romansonder/pro4e/documentation/07_PMA_report/30_analyse.tex

\begin{center}
    \begin{tabular}{ | c | m{5.5cm} | c | c | c | m{5.5cm} |}
    \hline
    $+/-$ & Ereignis & TA & PM & PA & Auswirkungen \\ \hline
    
$+$ & Die Analysephase des Projektes wurde schnell abgeschlossen. & & X & & Die Teile konnten sehr früh bestellt werden, so dass wir in der Projektwoche den Prototypen realisieren konnten. \\ \hline
    
$+$ & Der Aufbau des Dojos wurde von Anfang an gut geplant. & & & X & Beim Einbau der Teile in den Dojo hatten wir keine unvorhergesehene Platzprobleme. \\ \hline
    
$+$ & Die Teammitglieder erledigten ihre Arbeiten seriös und rechtzeitig. & X &  & & Das Projekt kam schnell voran und es gab kaum Verzögerungen im Zeitplan. \\ \hline
    
$-$ & Die Bluetoothverbindung klappte nicht wie gewünscht. & &  & X & Es musste viel Zeit in dieses Problem investiert werden.  \\ \hline
    
$-$ & Die Softwarearbeit wurde unterschätzt. Und die Arbeit anfangs Projekt ungenügend aufgeteilt. & & X & & Dominic musste in anderen Bereichen entlastet werden, da er sonst überlastet gewesen wäre.  \\ \hline
    
$-$ & Es funktionieren nicht alle SD-Kartentypen. & & & X & Wir mussten einen speziellen Typen bestellen, um unsere 3 Prototypen mit SD-Karten auszustatten.  \\ \hline

    \end{tabular}
\end{center}

\begin{tabular}{ | c | l | }
    \hline
    TA & Teamarbeit \\ \hline
    PM & Projektmanagement \\ \hline
    PA & Projektarbeit \\ \hline
   
    \end{tabular}
