romansonder/pro4e/documentation/04_technical_report_Disposition/30_grundlagen.tex

\subsection{Funktionen des Dojos}
Zu Beginn soll eine Übersicht über die Funktionen (aus Sicht des Benutzers) gemacht werden. Es wird gezeigt, wie der Dojo bedient wird und wie der Ablauf von der Konfiguration am PC-Terminal bis zum Check-out ist.

\subsection{Aufbau des Dojos}
Hier wird auf den mechanischen Aufbau des Dojos eingegangen. Die Dimensionen des Gehäuses sowie die Integration der Hardware werden beschrieben.
