romansonder/pro4e/documentation/04_technical_report_Disposition/10_abstract.tex

In diesem Abschnitt wird ein Abstract in Englisch verfasst.
