romansonder/pro4e/documentation/08_factsheet/01_plaincontent.tex

\title{
	Dojo - Mehr als nur ein Museumsführer
}

\team{
    Dominik Hiltbrunner,
    Tobias Klenke,
    Lattmann Emerson,
    Pius Ochs,
    Roman Sonder,
    Alexander Stutz
}

\client{
	Jana Kalbermatter und Hans Gysin
}

\coaches{
    Matthias Meier und Pascal Schleuniger
}

\fssummary{
    Wenn es nach Jana Kalbermatter, einer Absolventin der HGK, geht, sollten 		Museen schon längst modernisiert werden. Ihr letzter Museumsbesuch hat 			gezeigt, dass beim ziellosen umherschweifen Kunstwerke oftmals nicht 			wahrgenommen werden und am Ende nur das Erlebnis ''Besuch'' und nicht 			die Kunstwerke selbst in Erinnernung bleiben. Mit dem Dojo, einem stabförmigen 		Museumsführer soll sich dies nun ändern.
}

\fsgraphics{
    \begin{minipage}{\textwidth}
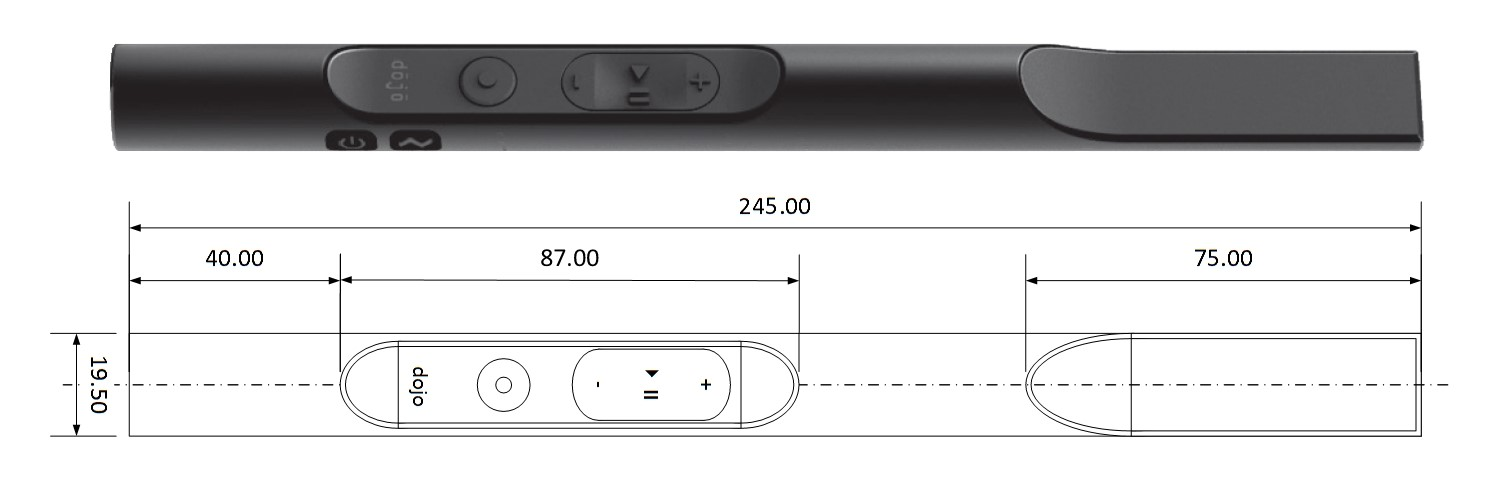
[picture p27: documentation/08_factsheet/graphics/Abbildung.jpg]
    	
        \graphicscaption{	Abbildung 1: Von Auftraggeberin designtes Gehäuse 							mit Dimensionsangaben}
    \end{minipage}
    \graphicssource{Abbildung von Auftraggeberin}
}

\fscontent{
    \section{Die Aufgabe}
    Auf dem Konzept von Jana Kalbermatter beruhend, soll die Elektronik für 		den von Ihr designten Dojo entwickelt werden. Dieser ist nicht nur in der 	Lage, Kunstwerke im Umfeld zu erkennen und entsprechende 						Audioinformationen bereitzustellen, sondern auch gleich als E-Ticket zu			fungieren. Der Dojo soll das Zutrittsrecht zu verschiedenen Räumen 				gewähren können, als auch eine Möglichkeit besitzen, Kunstwerke zu 				''liken''. Beim auschecken kann sodann eine Broschüre als Erinnerung 			mit den ''gelikten'' Kunstwerken bezogen werden. Damit im Museum auch 			weiterhin Ruhe herrscht, soll die Audioübertragung mittels 						Knochenschallgeber funktionieren.

    \newcol
    
    \section{Die Lösung}
    Mit der entwickelten Elektronik wurde ein erstes Funktionsmodell 				geschaffen, das in der Lage ist, die an Kunstwerken montierten Beacons 			zu erkennen und entsprechende Audioinformationen via Knochenschallgeber 		zur Verfügung zu stellen. Aufgrund der Signalstärken der 						einzelnen Beacons wird entschieden, vor welchem Kunstwerk sich der 				Museumsbesucher befindet und durch Vibration des Dojo eine verfügbare 			Audioinformation angekündigt. Ebenso funktioniert die Zutrittsregelung 			durch bei Drehkreuzen montierte Beacons, welche bei genügender 					Zutrittsberechtigung Zutritt gewähren.

    \section{Die Bedienung}
    Mittels einer mit Java entwickelten Software kann der Dojo mit neuen 			Audioinformationen versorgt, sowie mit vom Besucher gewünschter 				Zutrittsberechtigung und Sprache geladen werden. Anschliessend erhält der 	Besucher den Dojo, ein Museumsführer und E-Ticket zugleich. Befindet sich 	der Besucher in Reichweite eines Kunstwerkes, meldet sich der Dojo durch 		Vibration, dass Audioinformationen bereit stehen. Mittels 						''Like-Taste'' kann nun ein Kunstwerk ''geliked'' werden. Beim Abschluss 		des Besuches wird der Dojo zurückgeben, mittels Java Software ausgewertet 	und der Besucher erhält seine persönliche Erinnerungsbroschüre.
}

\infobox{Technische Daten}{
	\begin{tabbing}
		\hspace{40mm}		\= \hspace{15mm} \=\kill
		Gerätebezeichnung:	\> Dojo Museumsführer \\
		Modell:				\> Team 3 \\
		Speicherkapazität:	\> 2 GB \\
		Schnittstelle:		\> USB 2.0 (High Speed) \\
		Abmessungen:		\> ca. 245 mm x 19.5 mm (L x H) \\
		Akku:				\> Wiederaufladbarer Li-Ion Akku; 3.9 V, 600 mAh \\
		Eingang:			\> 5 V, 500 mAh (via USB-Schnittstelle) \\
		Laufzeit*:			\> Bis zu 3.5 Stunden Abspielzeit \\
\end{tabbing}

\begin{description}
\item *Akkulaufzeit kann je nach Abhängigkeit des Bedienverhaltens variieren.
\end{description}
}
