romansonder/pro4e/documentation/06_presentation/00_fhnwpresentation.tex

\documentclass[10pt,ngerman]{beamer}

%%%%%%%%%%%%%%%%%%%%%%%%%%%%%%%%%%%%%%%%%%%%%%%%%%%%%%%%%%%%%%%%%%%%%%%%%%%%%%%%
% basic font and language packages
%%%%%%%%%%%%%%%%%%%%%%%%%%%%%%%%%%%%%%%%%%%%%%%%%%%%%%%%%%%%%%%%%%%%%%%%%%%%%%%%
%\usepackage[left=20mm,right=20mm,top=20mm,bottom=20mm]{geometry}
\usepackage[T1]{fontenc} % font encoding
\usepackage{lmodern} % font latin modern
\usepackage[utf8]{inputenc} % input encoding
\usepackage[ngerman]{babel} % english and german word spelling
\usepackage[babel, german=swiss]{csquotes} % german cites
%\usepackage[babel, english=british]{csquotes} % english cites

%%%%%%%%%%%%%%%%%%%%%%%%%%%%%%%%%%%%%%%%%%%%%%%%%%%%%%%%%%%%%%%%%%%%%%%%%%%%%%%%
% style packages
%%%%%%%%%%%%%%%%%%%%%%%%%%%%%%%%%%%%%%%%%%%%%%%%%%%%%%%%%%%%%%%%%%%%%%%%%%%%%%%%
% \usepackage{hyperref} % use hyperlinks in table of contents
% \hypersetup{colorlinks=true,urlcolor=blue,linkcolor=black} % define hyperlink colors
\usepackage{verbatim} % don't interpret latex symbols (source code)
\usepackage{enumerate} % numbered items
\usepackage{graphicx} % use figures
\usepackage{subfigure} % more than one figure in the same place
\usepackage{booktabs} % create tables
\usepackage{multirow} % create tables
\usepackage{cite} % citations
\usepackage{pdflscape} % allow landscape sites in pdf documents
\usepackage{pdfpages} % include pdf files

%%%%%%%%%%%%%%%%%%%%%%%%%%%%%%%%%%%%%%%%%%%%%%%%%%%%%%%%%%%%%%%%%%%%%%%%%%%%%%%%
% mathematical packages
%%%%%%%%%%%%%%%%%%%%%%%%%%%%%%%%%%%%%%%%%%%%%%%%%%%%%%%%%%%%%%%%%%%%%%%%%%%%%%%%
\usepackage{amsmath} % formula
\usepackage{amsfonts} % formula
\usepackage{amssymb} % formula
\usepackage{amsthm} % formula
\usepackage{listings} % source code formatting

%%%%%%%%%%%%%%%%%%%%%%%%%%%%%%%%%%%%%%%%%%%%%%%%%%%%%%%%%%%%%%%%%%%%%%%%%%%%%%%%
% optional parameters
%%%%%%%%%%%%%%%%%%%%%%%%%%%%%%%%%%%%%%%%%%%%%%%%%%%%%%%%%%%%%%%%%%%%%%%%%%%%%%%%
\bibliographystyle{IEEEtran}
\graphicspath{{./graphics/}{./appendix/}}

% source code parameters
\lstset{numbers=left, numberstyle=\tiny, numbersep=6pt}
\lstset{captionpos=b, tabsize=4, basicstyle=\small, xleftmargin=0mm, xrightmargin=0mm}

%%%%%%%%%%%%%%%%%%%%%%%%%%%%%%%%%%%%%%%%%%%%%%%%%%%%%%%%%%%%%%%%%%%%%%%%%%%%%%%%
% debugging parameters
%%%%%%%%%%%%%%%%%%%%%%%%%%%%%%%%%%%%%%%%%%%%%%%%%%%%%%%%%%%%%%%%%%%%%%%%%%%%%%%%
%\usepackage{todonotes}
%\overfullrule=1em

%%%%%%%%%%%%%%%%%%%%%%%%%%%%%%%%%%%%%%%%%%%%%%%%%%%%%%%%%%%%%%%%%%%%%%%%%%%%%%%%
% beamer theme
%%%%%%%%%%%%%%%%%%%%%%%%%%%%%%%%%%%%%%%%%%%%%%%%%%%%%%%%%%%%%%%%%%%%%%%%%%%%%%%%
\usetheme[compress]{Berlin}
\setbeamertemplate{bibliography item}{\insertbiblabel}

\definecolor{custum_blue}{RGB}{0,0,230}
\setbeamercolor{structure}{fg=custum_blue}

%%%%%%%%%%%%%%%%%%%%%%%%%%%%%%%%%%%%%%%%%%%%%%%%%%%%%%%%%%%%%%%%%%%%%%%%%%%%%%%%
% title
%%%%%%%%%%%%%%%%%%%%%%%%%%%%%%%%%%%%%%%%%%%%%%%%%%%%%%%%%%%%%%%%%%%%%%%%%%%%%%%%
\title{Midterm Presentation}
\subtitle{Dojo -- Mehr als nur ein Museumsbegleiter}
\date{xx.xx.2018}

\begin{document}
%%%%%%%%%%%%%%%%%%%%%%%%%%%%%%%%%%%%%%%%%%%%%%%%%%%%%%%%%%%%%%%%%%%%%%%%%%%%%%%%
\begin{frame}
\maketitle
\end{frame}

%-------------------------------------------------------------------------------
\begin{frame}
\tableofcontents
\end{frame}

%%%%%%%%%%%%%%%%%%%%%%%%%%%%%%%%%%%%%%%%%%%%%%%%%%%%%%%%%%%%%%%%%%%%%%%%%%%%%%%%
\section{introduction}
\begin{frame}

\end{frame}

%-------------------------------------------------------------------------------
\begin{frame}

\end{frame}

%-------------------------------------------------------------------------------
\begin{frame}

\end{frame}

%%%%%%%%%%%%%%%%%%%%%%%%%%%%%%%%%%%%%%%%%%%%%%%%%%%%%%%%%%%%%%%%%%%%%%%%%%%%%%%%
\section{Concept}
\begin{frame}

\end{frame}

%-------------------------------------------------------------------------------
\begin{frame}

\end{frame}

%-------------------------------------------------------------------------------
\begin{frame}

\end{frame}

%%%%%%%%%%%%%%%%%%%%%%%%%%%%%%%%%%%%%%%%%%%%%%%%%%%%%%%%%%%%%%%%%%%%%%%%%%%%%%%%
\section{Harware}
\begin{frame}

\end{frame}

%-------------------------------------------------------------------------------
\begin{frame}

\end{frame}

%%%%%%%%%%%%%%%%%%%%%%%%%%%%%%%%%%%%%%%%%%%%%%%%%%%%%%%%%%%%%%%%%%%%%%%%%%%%%%%%
\section{Software}
\begin{frame}

\end{frame}

%-------------------------------------------------------------------------------
\begin{frame}

\end{frame}

%%%%%%%%%%%%%%%%%%%%%%%%%%%%%%%%%%%%%%%%%%%%%%%%%%%%%%%%%%%%%%%%%%%%%%%%%%%%%%%%
\section{Q\&A}
\begin{frame}

\end{frame}

\end{document}
