romansonder/pro4e/documentation/05_technical_report_usermanual/00_fhnwreport.tex

\documentclass[10pt,a5paper,landscape]{article}

%%%%%%%%%%%%%%%%%%%%%%%%%%%%%%%%%%%%%%%%%%%%%%%%%%%%%%%%%%%%%%%%%%%%%%%%%%%%%%%%
% basic font and language packages
%%%%%%%%%%%%%%%%%%%%%%%%%%%%%%%%%%%%%%%%%%%%%%%%%%%%%%%%%%%%%%%%%%%%%%%%%%%%%%%%
\usepackage[left=20mm,right=20mm,top=20mm,bottom=20mm]{geometry}
\usepackage[T1]{fontenc} % font encoding
\usepackage{lmodern} % font latin modern
\usepackage[utf8]{inputenc} % input encoding
\usepackage[ngerman]{babel} % english and german word spelling
\usepackage[babel, german=swiss]{csquotes} % german cites
%\usepackage[babel, english=british]{csquotes} % english cites

%%%%%%%%%%%%%%%%%%%%%%%%%%%%%%%%%%%%%%%%%%%%%%%%%%%%%%%%%%%%%%%%%%%%%%%%%%%%%%%%
% style packages
%%%%%%%%%%%%%%%%%%%%%%%%%%%%%%%%%%%%%%%%%%%%%%%%%%%%%%%%%%%%%%%%%%%%%%%%%%%%%%%%
\usepackage{hyperref} % use hyperlinks in table of contents
\hypersetup{colorlinks=true,urlcolor=blue,linkcolor=black} % define hyperlink colors
\usepackage{verbatim} % don't interpret latex symbols (source code)
\usepackage{enumerate} % numbered items
\usepackage{graphicx} % use figures
\usepackage{subfigure} % more than one figure in the same place
\usepackage{booktabs} % create tables
\usepackage{multirow} % create tables
\usepackage{cite} % citations
\usepackage{pdflscape} % allow landscape sites in pdf documents
\usepackage{pdfpages} % include pdf files

%%%%%%%%%%%%%%%%%%%%%%%%%%%%%%%%%%%%%%%%%%%%%%%%%%%%%%%%%%%%%%%%%%%%%%%%%%%%%%%%
% mathematical packages
%%%%%%%%%%%%%%%%%%%%%%%%%%%%%%%%%%%%%%%%%%%%%%%%%%%%%%%%%%%%%%%%%%%%%%%%%%%%%%%%
\usepackage{amsmath} % formula
\usepackage{amsfonts} % formula
\usepackage{amssymb} % formula
\usepackage{amsthm} % formula
\usepackage{listings} % source code formatting

%%%%%%%%%%%%%%%%%%%%%%%%%%%%%%%%%%%%%%%%%%%%%%%%%%%%%%%%%%%%%%%%%%%%%%%%%%%%%%%%
% optional parameters
%%%%%%%%%%%%%%%%%%%%%%%%%%%%%%%%%%%%%%%%%%%%%%%%%%%%%%%%%%%%%%%%%%%%%%%%%%%%%%%%
\bibliographystyle{IEEEtran}
\graphicspath{{./graphics/}{./appendix/}}

% source code parameters
\lstset{numbers=left, numberstyle=\tiny, numbersep=6pt}
\lstset{captionpos=b, tabsize=4, basicstyle=\small, xleftmargin=0mm, xrightmargin=0mm}

%%%%%%%%%%%%%%%%%%%%%%%%%%%%%%%%%%%%%%%%%%%%%%%%%%%%%%%%%%%%%%%%%%%%%%%%%%%%%%%%
% debugging parameters
%%%%%%%%%%%%%%%%%%%%%%%%%%%%%%%%%%%%%%%%%%%%%%%%%%%%%%%%%%%%%%%%%%%%%%%%%%%%%%%%
%\usepackage{todonotes}
%\overfullrule=1em

%%%%%%%%%%%%%%%%%%%%%%%%%%%%%%%%%%%%%%%%%%%%%%%%%%%%%%%%%%%%%%%%%%%%%%%%%%%%%%%%
% document settings
%%%%%%%%%%%%%%%%%%%%%%%%%%%%%%%%%%%%%%%%%%%%%%%%%%%%%%%%%%%%%%%%%%%%%%%%%%%%%%%%
\title{
	\textsc{\LARGE{Bedienungsanleitung}}\\[5mm]
	\textsc{\LARGE{Dojo - Mehr als nur ein Museumsführer}}
}

\author{}

\date{\today}

%%%%%%%%%%%%%%%%%%%%%%%%%%%%%%%%%%%%%%%%%%%%%%%%%%%%%%%%%%%%%%%%%%%%%%%%%%%%%%%
% pictures
%\begin{figure}[htb]
%\includegraphics[width=100mm]{image1.png}
%\figcaption{image1} % picture caption
%\label{fig:image1}
%\end{figure}
%
%(Abb. \ref{fig:image1})
%%%%%%%%%%%%%%%%%%%%%%%%%%%%%%%%%%%%%%%%%%%%%%%%%%%%%%%%%%%%%%%%%%%%%%%%%%%%%%%

%%%%%%%%%%%%%%%%%%%%%%%%%%%%%%%%%%%%%%%%%%%%%%%%%%%%%%%%%%%%%%%%%%%%%%%%%%%%%%%
% equation
%\begin{equation}
%X_{1,2} = \frac{-b \pm \sqrt{b^{2}-4ac}}{2a}
%\label{eq:equation1}
%\end{equation}
%%%%%%%%%%%%%%%%%%%%%%%%%%%%%%%%%%%%%%%%%%%%%%%%%%%%%%%%%%%%%%%%%%%%%%%%%%%%%%%

%%%%%%%%%%%%%%%%%%%%%%%%%%%%%%%%%%%%%%%%%%%%%%%%%%%%%%%%%%%%%%%%%%%%%%%%%%%%%%%
% table
%\begin{table}[tb]
%\centering
%\begin{tabular}
%
%\end{tabular}
%\caption{Table 1}
%\label{tab:table1}
%\end{table}
%%%%%%%%%%%%%%%%%%%%%%%%%%%%%%%%%%%%%%%%%%%%%%%%%%%%%%%%%%%%%%%%%%%%%%%%%%%%%%%

%%%%%%%%%%%%%%%%%%%%%%%%%%%%%%%%%%%%%%%%%%%%%%%%%%%%%%%%%%%%%%%%%%%%%%%%%%%%%%%
% citation
%\cite{BUCH1}
%%%%%%%%%%%%%%%%%%%%%%%%%%%%%%%%%%%%%%%%%%%%%%%%%%%%%%%%%%%%%%%%%%%%%%%%%%%%%%%

%%%%%%%%%%%%%%%%%%%%%%%%%%%%%%%%%%%%%%%%%%%%%%%%%%%%%%%%%%%%%%%%%%%%%%%%%%%%%%%
% source code
%\begin{lstlisting}[frame=tb,caption={Application.java}, label=lst:code, language=java]
%your source code
%\end{lstlisting}
% or
%\lstinputlisting[frame=tb,caption={Caption 1}, label=lst:code1, language=c]{path/file.src}
%
%%%%%%%%%%%%%%%%%%%%%%%%%%%%%%%%%%%%%%%%%%%%%%%%%%%%%%%%%%%%%%%%%%%%%%%%%%%%%%%

\begin{document}

%%%%%%%%%%%%%%%%%%%%%%%%%%%%%%%%%%%%%%%%%%%%%%%%%%%%%%%%%%%%%%%%%%%%%%%%%%%%%%%%
% title page
%%%%%%%%%%%%%%%%%%%%%%%%%%%%%%%%%%%%%%%%%%%%%%%%%%%%%%%%%%%%%%%%%%%%%%%%%%%%%%%%
\pagenumbering{gobble}
\maketitle

%\definecolor{gray}{rgb}{0.5,0.5,0.5}
%\color{gray}
\noindent % einzug
\rule{\linewidth}{0.5mm}

\begin{center}
\parbox{50mm}{
\textsc{
\begin{tabbing}
\hspace{50mm}	\= \hspace{15mm} \=\kill
Auftraggeber	\> Jana Kalbermatter und Hans Gysin \\[2.5mm]
Fachcoaches		\> Matthias Meier und Pascal Schleuniger\\[2.5mm]
Projektleiter	\> Dominik Hiltbrunner\\
Team			\> Alexander Stutz, Emerson Lattmann, \\
				\> Pius Ochs, Tobias Klenke und Roman Sonder\\[2.5mm]
Studiengang		\> Elektro- und Informationstechnik \\[2.5mm]
\end{tabbing}}}
\end{center}

\color{black}

%%%%%%%%%%%%%%%%%%%%%%%%%%%%%%%%%%%%%%%%%%%%%%%%%%%%%%%%%%%%%%%%%%%%%%%%%%%%%%%%
% table of contents
%%%%%%%%%%%%%%%%%%%%%%%%%%%%%%%%%%%%%%%%%%%%%%%%%%%%%%%%%%%%%%%%%%%%%%%%%%%%%%%%
\tableofcontents
\clearpage

%%%%%%%%%%%%%%%%%%%%%%%%%%%%%%%%%%%%%%%%%%%%%%%%%%%%%%%%%%%%%%%%%%%%%%%%%%%%%%%%
% Geräte Übersicht
%%%%%%%%%%%%%%%%%%%%%%%%%%%%%%%%%%%%%%%%%%%%%%%%%%%%%%%%%%%%%%%%%%%%%%%%%%%%%%%%
\pagenumbering{arabic}
\setcounter{page}{1}
\section{Geräte Übersicht}\label{sec:Geräte Übersicht}
\input{10_geraete_uebersicht}
\clearpage

%%%%%%%%%%%%%%%%%%%%%%%%%%%%%%%%%%%%%%%%%%%%%%%%%%%%%%%%%%%%%%%%%%%%%%%%%%%%%%%%
% Über dieses Gerät
%%%%%%%%%%%%%%%%%%%%%%%%%%%%%%%%%%%%%%%%%%%%%%%%%%%%%%%%%%%%%%%%%%%%%%%%%%%%%%%%
\section{Über dieses Gerät}\label{sec:Über dieses Gerät}
\input{20_ueber_dieses_geraet}
\clearpage

%%%%%%%%%%%%%%%%%%%%%%%%%%%%%%%%%%%%%%%%%%%%%%%%%%%%%%%%%%%%%%%%%%%%%%%%%%%%%%%%
% Inbetriebnahme
%%%%%%%%%%%%%%%%%%%%%%%%%%%%%%%%%%%%%%%%%%%%%%%%%%%%%%%%%%%%%%%%%%%%%%%%%%%%%%%%
\section{Inbetriebnahme}\label{sec:Inbetriebnahme}
\input{30_inbetriebnahme}
\clearpage

%%%%%%%%%%%%%%%%%%%%%%%%%%%%%%%%%%%%%%%%%%%%%%%%%%%%%%%%%%%%%%%%%%%%%%%%%%%%%%%%
% Datenaustausch mit dem Computer
%%%%%%%%%%%%%%%%%%%%%%%%%%%%%%%%%%%%%%%%%%%%%%%%%%%%%%%%%%%%%%%%%%%%%%%%%%%%%%%%
\section{Datenaustausch mit dem Computer}\label{sec:Datenaustausch mit dem Computer}
\input{40_datenaustausch_mit_computer }
\clearpage

%%%%%%%%%%%%%%%%%%%%%%%%%%%%%%%%%%%%%%%%%%%%%%%%%%%%%%%%%%%%%%%%%%%%%%%%%%%%%%%%
% Bedienung
%%%%%%%%%%%%%%%%%%%%%%%%%%%%%%%%%%%%%%%%%%%%%%%%%%%%%%%%%%%%%%%%%%%%%%%%%%%%%%%%
\section{Bedienung}\label{sec:Bedienung}
\input{50_bedienung}
\clearpage

%%%%%%%%%%%%%%%%%%%%%%%%%%%%%%%%%%%%%%%%%%%%%%%%%%%%%%%%%%%%%%%%%%%%%%%%%%%%%%%%
% Technische Daten
%%%%%%%%%%%%%%%%%%%%%%%%%%%%%%%%%%%%%%%%%%%%%%%%%%%%%%%%%%%%%%%%%%%%%%%%%%%%%%%%
\section{Technische Daten}\label{sec:Technische Daten}
\input{60_technische_daten}
\clearpage

%%%%%%%%%%%%%%%%%%%%%%%%%%%%%%%%%%%%%%%%%%%%%%%%%%%%%%%%%%%%%%%%%%%%%%%%%%%%%%%%
% Entsorgung
%%%%%%%%%%%%%%%%%%%%%%%%%%%%%%%%%%%%%%%%%%%%%%%%%%%%%%%%%%%%%%%%%%%%%%%%%%%%%%%%
\section{Entsorgung}\label{sec:Entsorgung}
\input{70_entsorgung}
\clearpage

\end{document}
