romansonder/pro4e/documentation/00_research/blockschaltbild.pptx

Steckdose

Messgerät

Messteil

Filter und Verstärker

AD-Wandler

Verbraucher

Smartphone

App

NUS-Library

Energie-versorgung

Speicher

nRF52832

Applikation

RTC

Batterie

zB. SPI

?

NUS-Library
BLE-Driver
BLE-Modul

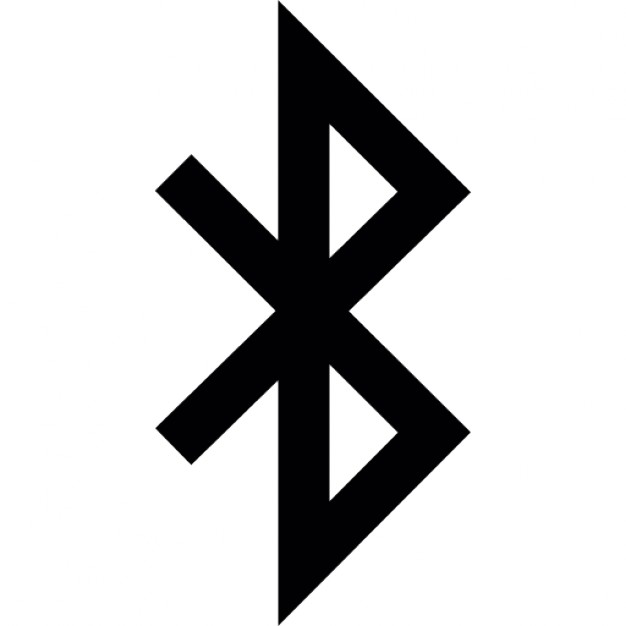
[picture p28: figure]

BLE-Modul
BLE-Treiber

Display

Zu entwickeln in Pro3E

Produkt von Nordic Semiconductor

Produkt von Dritten
