romansonder/pro4e/documentation/07_PMA_report/50_schlusswort.tex

Die Teamarbeit des Projekts kann positiv gewertet werden. Während der gesamten Zeit gab es keine relevanten Unstimmigkeiten. Die im Laufe des Projektes aufgetauchten Probleme, beseitigte das Team jeweils durch viel Engagement und guter Zusammenarbeit. Die negativen Erfahrungen im Projekt beschränken sich auf technische und Projektmanagement spezifische Angelegenheiten. Die Projektarbeit in unserem Team hat ausgezeichnet funktioniert.\\
\\
Besonders hervorzuheben ist in diesem Projekt der schnelle Abschluss der Analysephase. Wir konnten bereits im Pflichtenheft einen relativ detaillierten Lösungsvorschlag für die Hardware präsentieren. Zu kurz gekommen ist in dieser Phase die Software. Die Analyse der Software hätte präziser ausfallen sollen. Dadurch hätten wir uns viele Probleme erspart.\\
\\
Für weitere Projekte kann man die Methoden in der Teamarbeit so beibehalten. Im Bereich des Projektmanagements sollte man darauf achten, dass alle Bereiche genau analysiert werden, auch wenn sie auf den ersten Blick als unproblematisch erachtet werden. Aus unseren technischen Problemen kann man hautsächlich lernen, dass man besser auf gut dokumentierte Bauteile setzen sollte und auf exotische Bauteile verzichtet.
