romansonder/pro4e/documentation/00_research/flussdiagramm.pptx

Reset

Initialisiere aller Nordic Module

n* ≡ LOG_INTERVALL* ≡10 s

k* ≡ DISPLAY_INTERVALL ≡ 3 s

Initialisiere aller Hardwaretreiber

Initialisiere alle anderen Module

n* mal wiederholen

Messung von Strom und Spannung starten

fertig

wiederholen

trifft zu

Berechne zu loggende Werte

BLE Advertising starten

Warten bis Messung fertig

Logge Werte des letzten LOG_INTERVALL*

Daten über BLE empfangen

Reagiere darauf:
- Zeit aktualisieren
- Daten senden
-Messung zurücksetzen

Ende des Threads

Signalverarbeitung durchführen

Alle k* mal trifft zu

trifft nicht zu

Berechne anzuzeigende Werte

Gebe die Werte auf Display aus

Falls mit App verbunden:
Sende Werte an App
