romansonder/pro4e/documentation/03_technical_report/graphics/dojo_layer.pdf

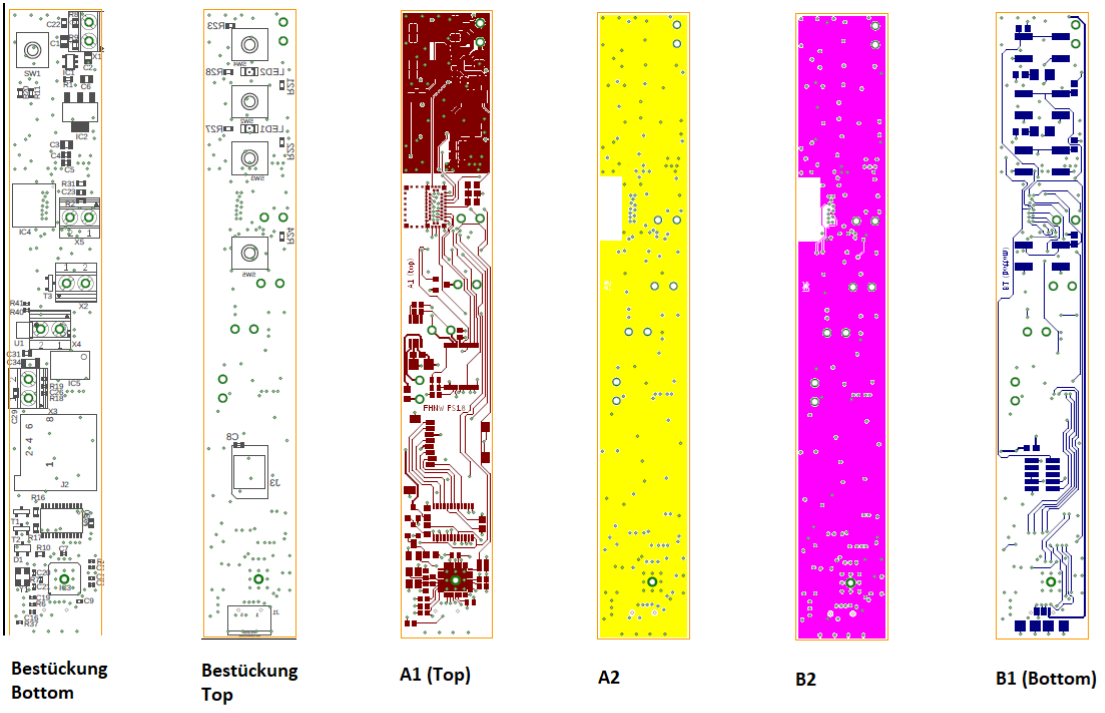
[picture p35: figure]
