romansonder/pro4e/documentation/01_product_specification_organizational/graphics/projektplan_1.pdf

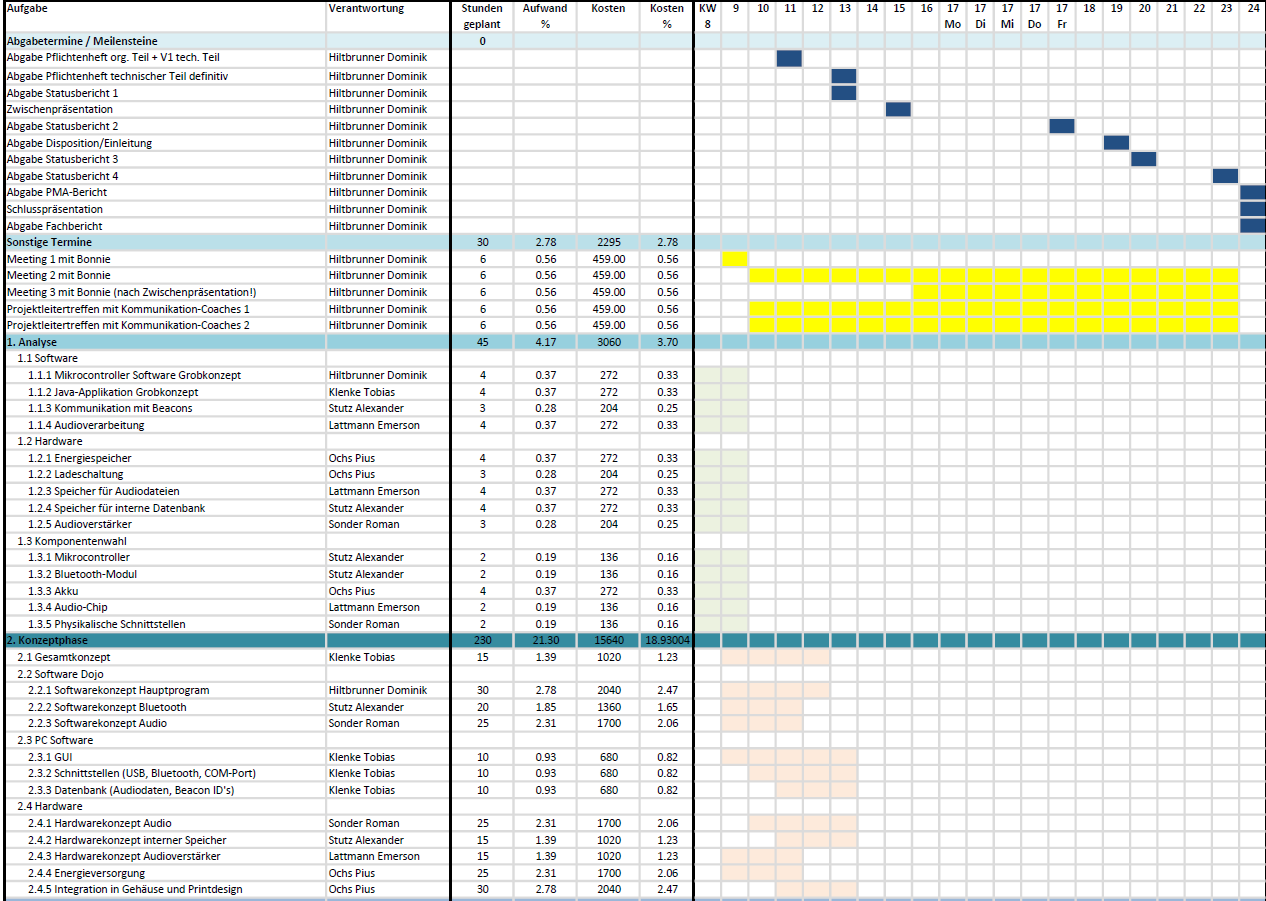
[picture p37: page 1]
