romansonder/pro4e/documentation/01_product_specification_organizational/graphics/projektplan_2.pdf

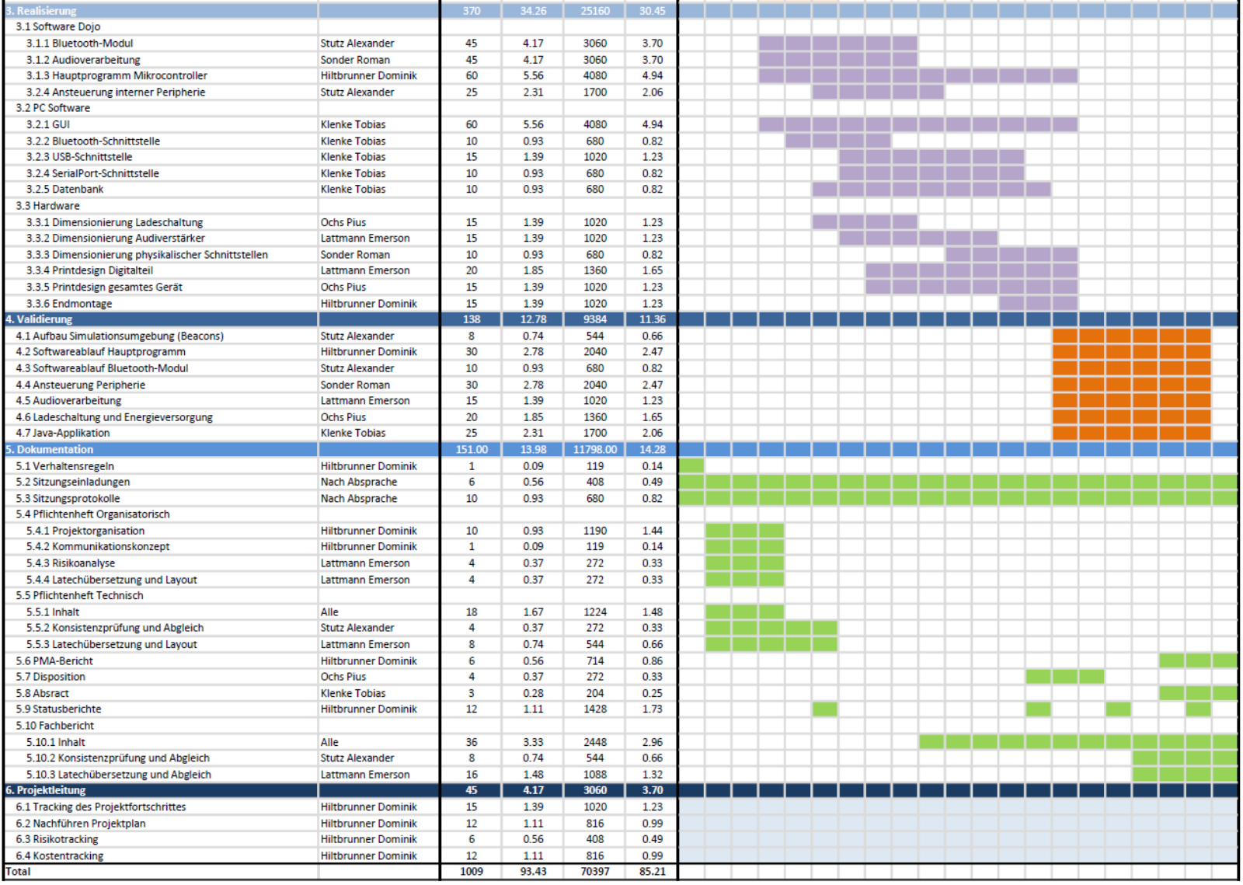
[picture p38: page 1]
