romansonder/pro4e/software/host/Laborbericht_Roman_Tobias/messresultate_01.xlsx

19.6°C |  | f2 | 4.955 | Distro D8
34.00% |  | f1 | 1+-0.005 | Masstab
974hPa |  | s1 | 0.12+-0.005 | Masstab
 |  | s2 | 4.75 | Distro D8
Frequenz | Abstand |  |  | Linse Brennweite | 1m
-227 | 0
-329 | -9.6e-05
-427 | -0.000177
-526 | -0.000248
-624 | -0.000333
-726 | -0.000413
-828 | -0.000496
-926 | -0.000576
-1024 | -0.000659
229 | 0
327 | 9e-05
427 | 0.000163
528 | 0.000236
625 | 0.000333
725 | 0.000407
826 | 0.000474
925 | 0.000557
1027 | 0.000651
