romansonder/pro4e/hardware/pcb/Board_1_Eagle/Bestellung 28_03_2018/Mängelliste.xlsx

1 | Botton-Beschriftung
2 | V_Bat Spannungsmessung
3 | Transistoren sind scheisse
4 | MUX freihängend
