romansonder/pro4e/documentation/01_product_specification_organizational/graphics/projektplan.png

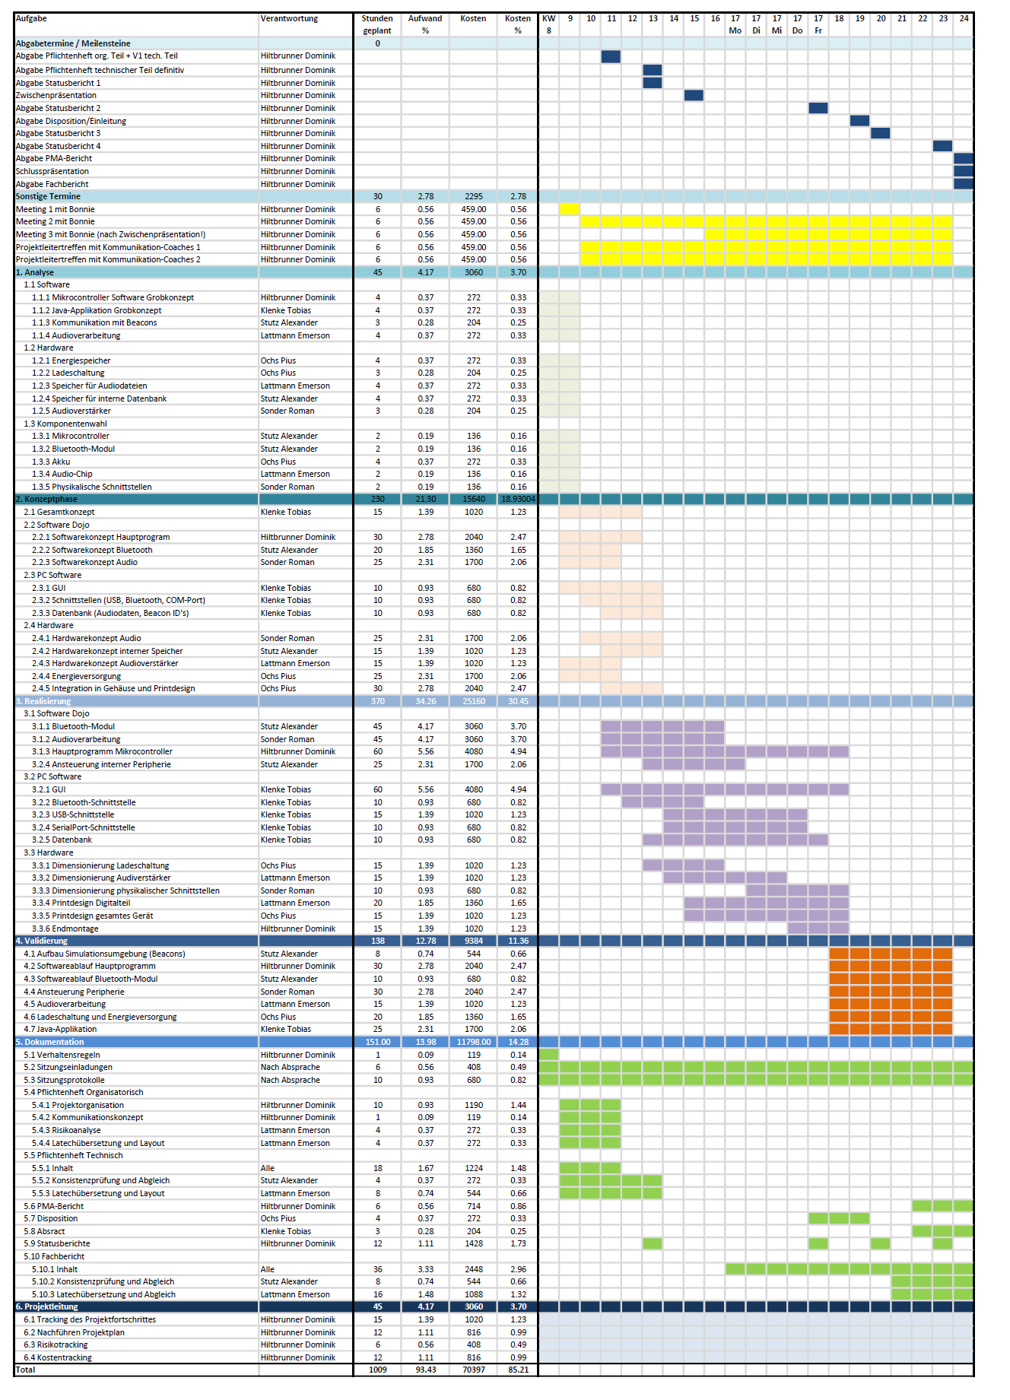
documentation/01_product_specification_organizational/graphics/projektplan.png
