romansonder/pro4e/documentation/03_technical_report/graphics/dojo_layer.png

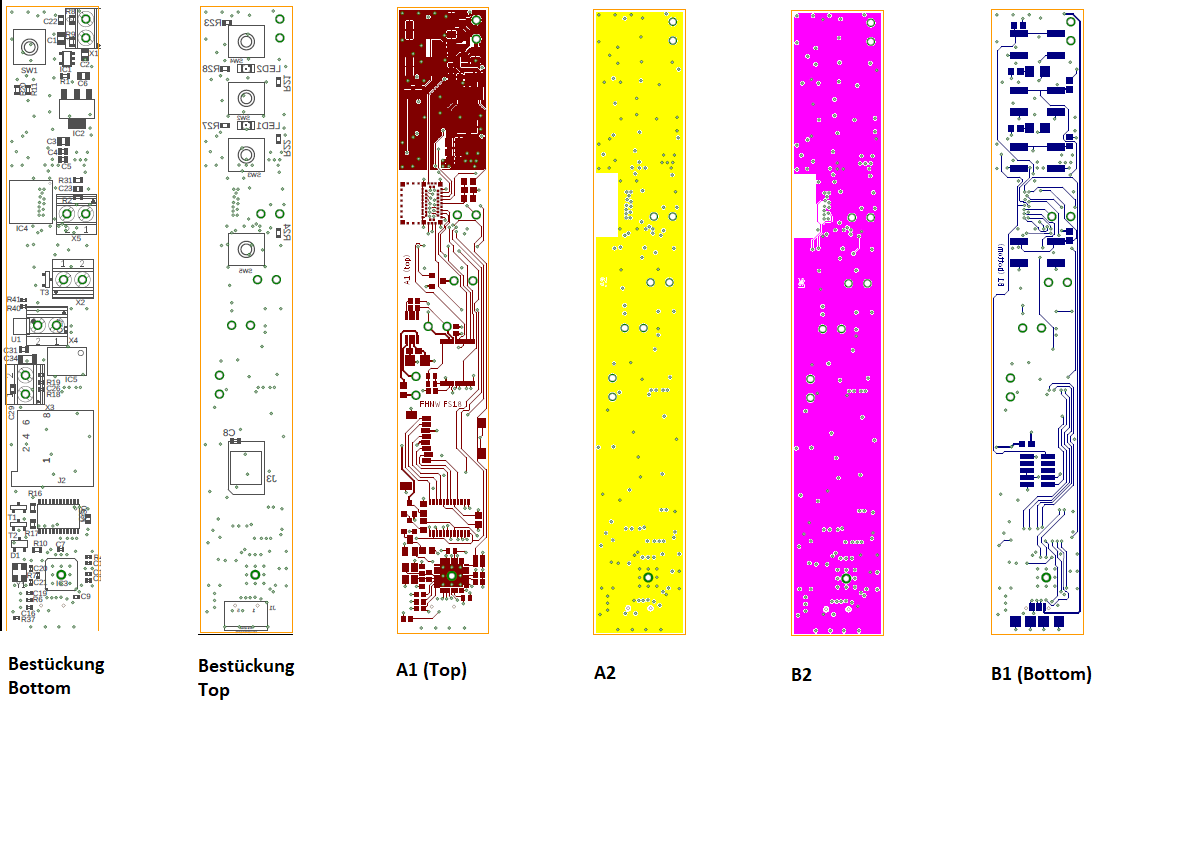
documentation/03_technical_report/graphics/dojo_layer.png
