romansonder/pro4e/documentation/03_technical_report/graphics/EnladekurveSpannung.png

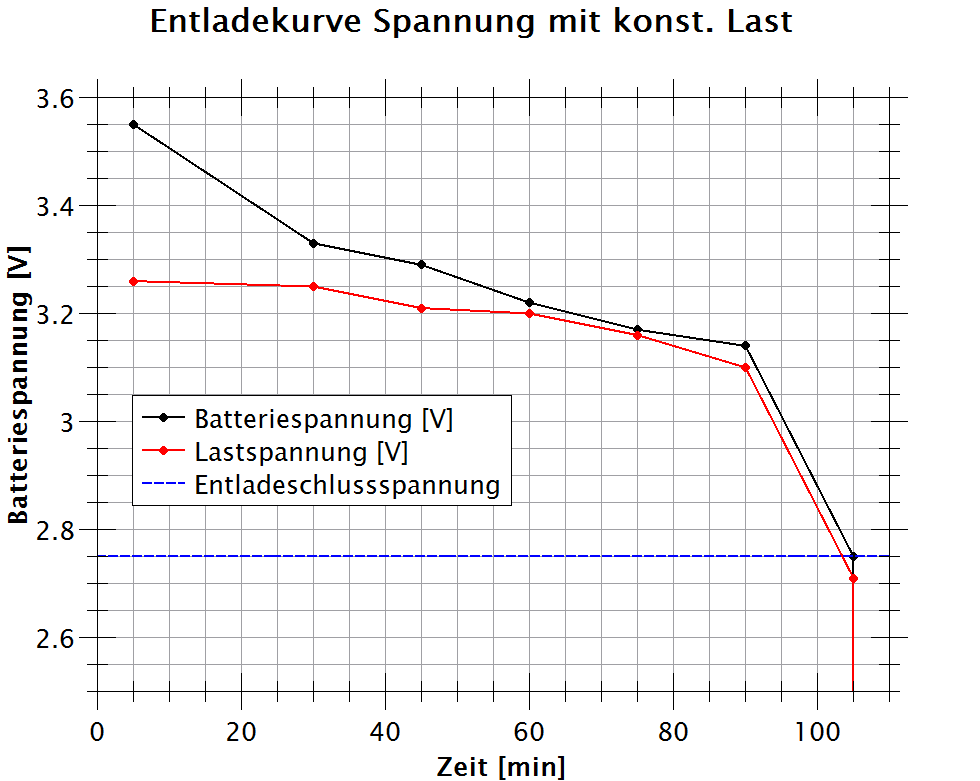
documentation/03_technical_report/graphics/EnladekurveSpannung.png
