romansonder/pro4e/documentation/03_technical_report/graphics/EnladekurveStrom.png

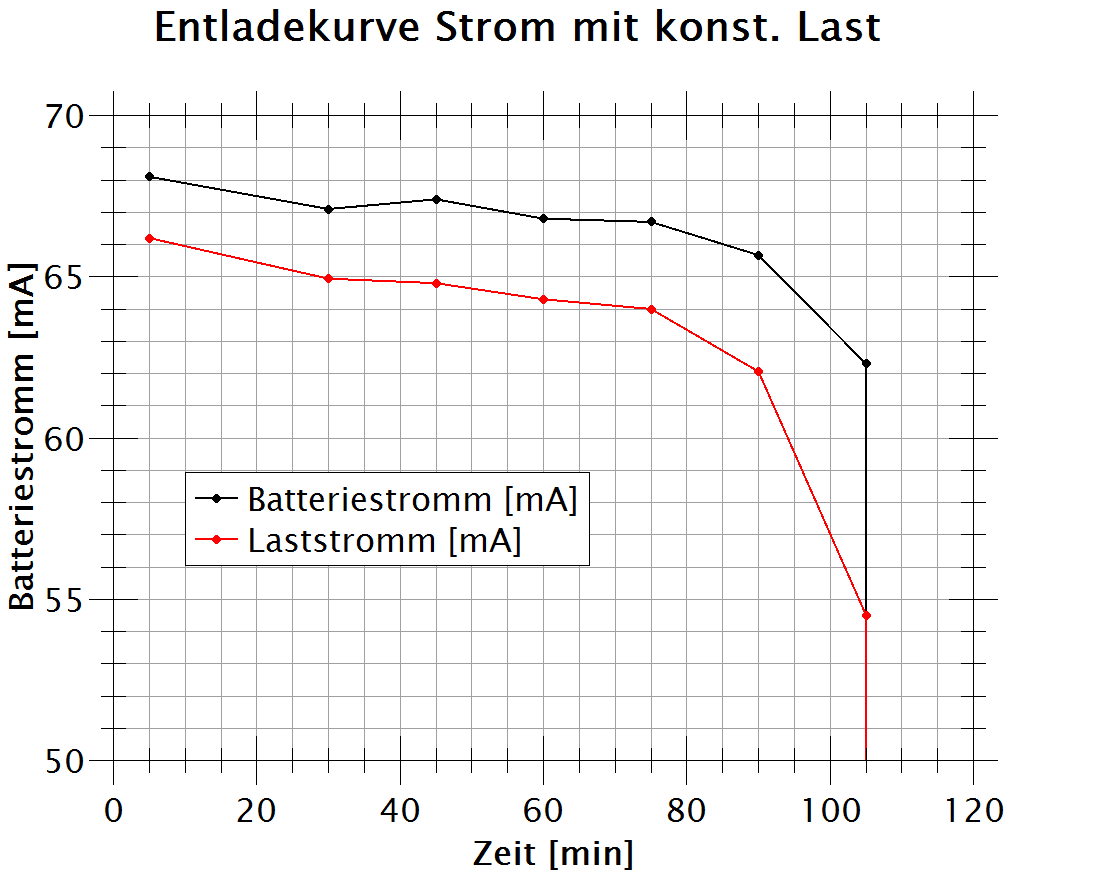
documentation/03_technical_report/graphics/EnladekurveStrom.png
