romansonder/pro4e/documentation/03_technical_report/graphics/kurve_knochenschallgeber_1.png

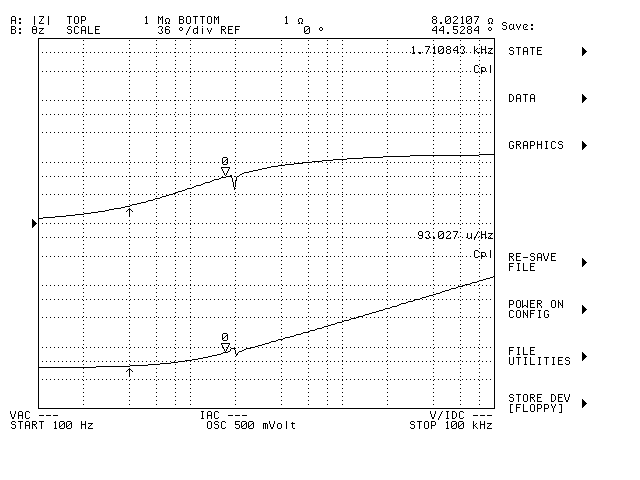
documentation/03_technical_report/graphics/kurve_knochenschallgeber_1.png
