romansonder/pro4e/documentation/03_technical_report/graphics/Zeichnung 4.jpg

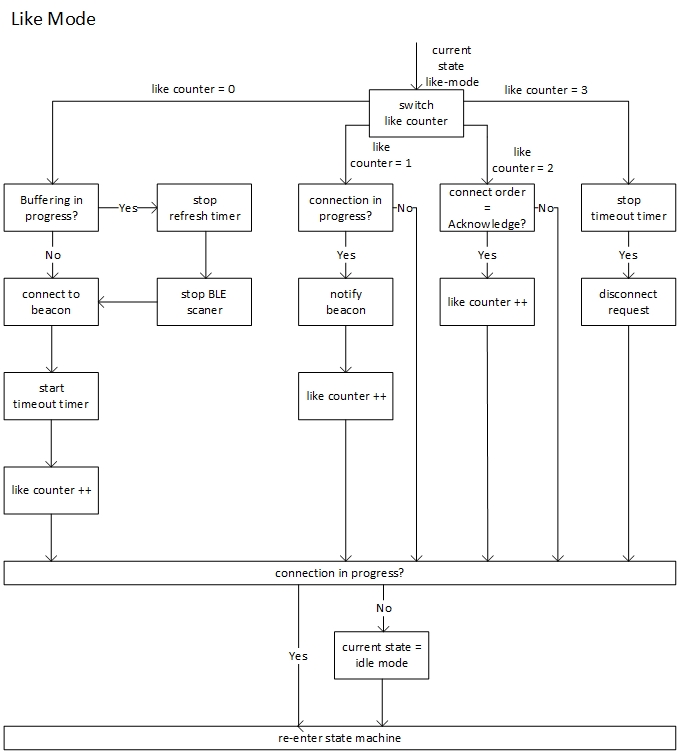
documentation/03_technical_report/graphics/Zeichnung 4.jpg
