romansonder/pro4e/documentation/04_technical_report_Disposition/graphics/blockschaltbild.png

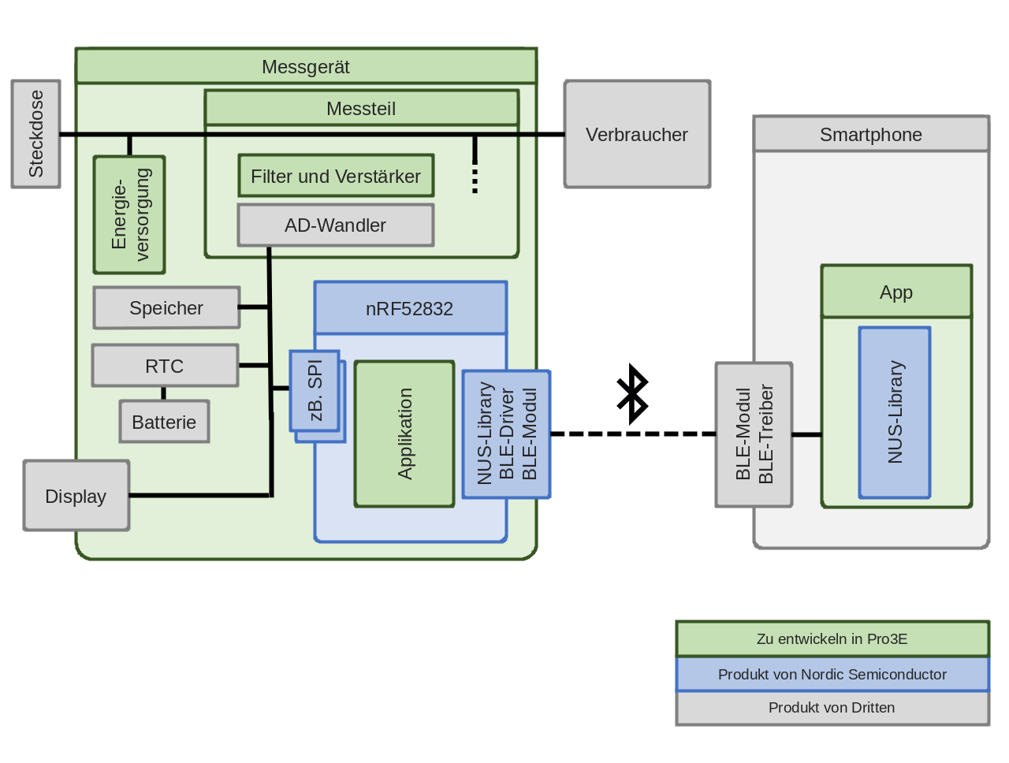
documentation/04_technical_report_Disposition/graphics/blockschaltbild.png
