romansonder/pro4e/hardware/pcb/Board_1_Eagle/Bestellung 28_03_2018/Unbenannt.png

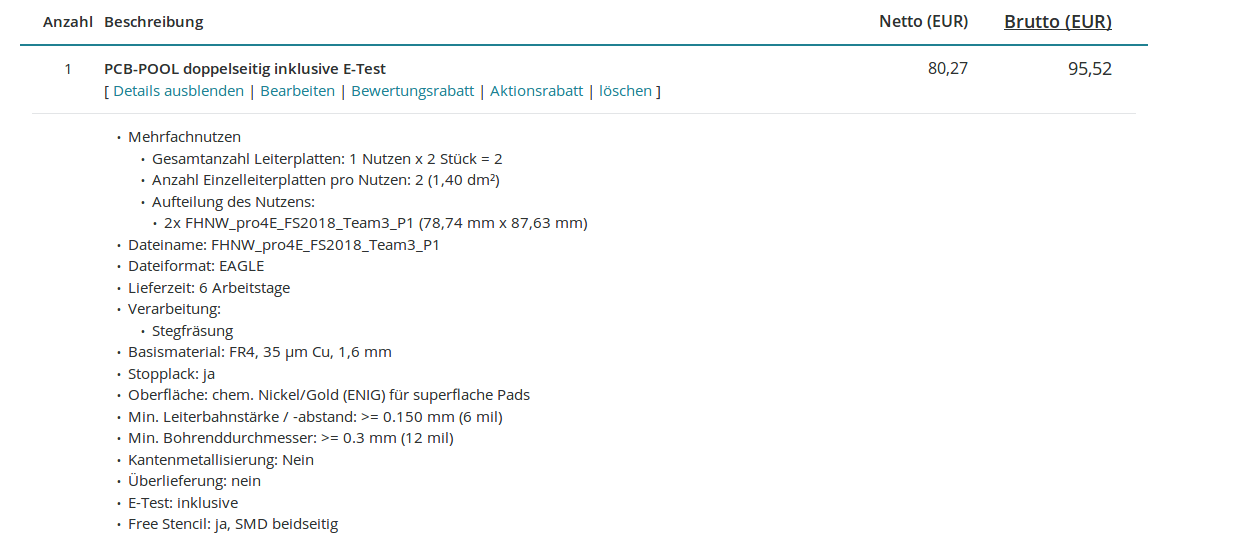
hardware/pcb/Board_1_Eagle/Bestellung 28_03_2018/Unbenannt.png
