romansonder/pro4e/software/host/Simtoolbericht_Roman_Tobias/graphics/tank_10m_100C.PNG

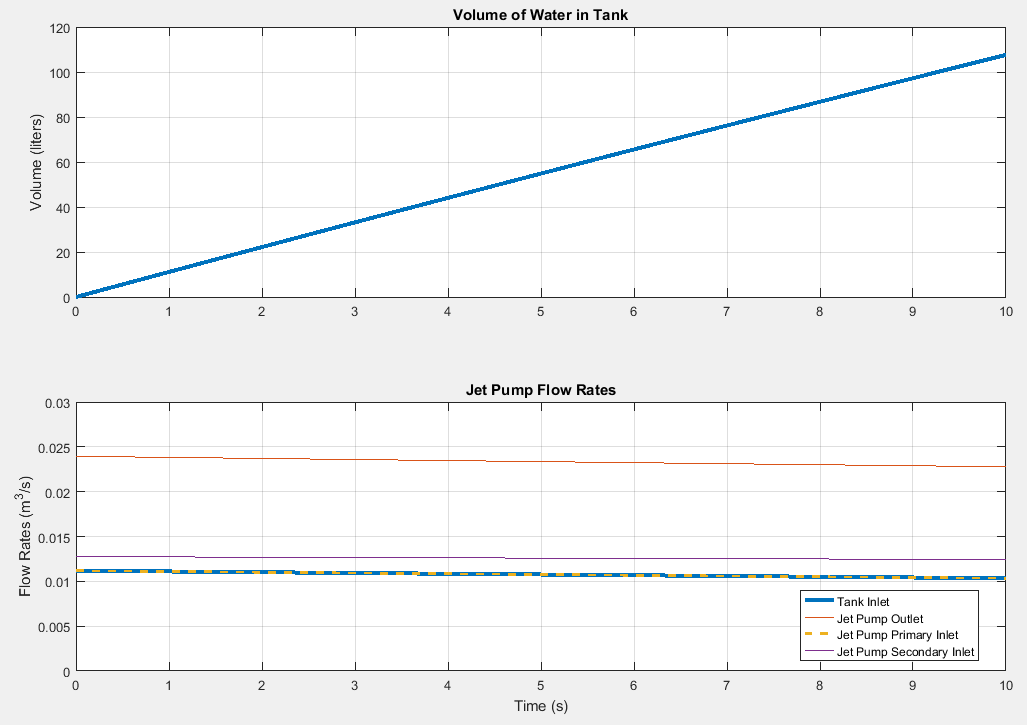
software/host/Simtoolbericht_Roman_Tobias/graphics/tank_10m_100C.PNG
