romansonder/pro4e/hardware/pcb/Board_2_Eagle/Bestellung.xlsx

Bestellmenge | Mouser-Nr. | Accuswiss-Nr. | Distrelec-Nr. | Preis pro Stück CHF | Preis CHF | Device | Package | Wert
10 | 81-ZRB15XC80J106ME5D |  |  | 1 | 10 | C_Ker | C0402 | 1u
10 | 80-CBR04C809B1GAC |  |  | 0.24 | 2.4 | C_Ker | C0402 | 8p
4 | 80-T490A107M6ATE500 |  |  | 1.17 | 4.68 | C_Tan | C1206 | 100u
10 | 80-C0402T104K4RACTU |  |  | 1.14 | 11.4 | C_Ker | C0402 | 100n
10 | 80-C0402C102J5HAUTO |  |  | 0.42 | 4.2 | C_Ker | C0402 | 1n
10 | 821-BAS40-05 |  |  | 0.336 | 3.36 | BAS40-05 | SOT23 | BAS40-05
4 | 595-TS3A27518EIPWRQ1 |  |  | 2.6 | 10.4 | TS3A27 | TSSOP24 | TS3A27
4 | 579-MCP73831T-3ACIOT |  |  | 0.64 | 2.56 | MCP73831 | SOT23-5 | MCP73831
4 | 595-TL1963A-33DCYR |  |  | 2.69 | 10.76 | LDO | SOT222 | 3.3V
4 | 579-TC1262-3.0VDB |  |  | 0.584 | 2.336 | LDO | SOT223 | 3V
4 | 649-202112100010C4LF |  |  | 0.69 | 2.76 | DEBUG_CONNECTOR | 10Pin
3 |  |  | 169-61-320 | 4.2 | 12.6
3 |  | TrustFire_10440 |  | 6.8 | 20.4
3 | 359-ISP1507-AX-RS |  |  | 13.54 | 40.62 | Mod
4 | 621-PAM8302AASCR |  |  | 0.59 | 2.36
4 | 710-629105136821 |  |  | 1.31 | 5.24
3 | 710-693071010811 |  |  | 3.13 | 9.39
3 | 485-1674 |  |  | 8.65 | 25.95
3 | 619-28821 |  |  | 3.85 | 11.55
15 | 863-1HP04CH-TL-W |  |  | 0.6 | 9 | P-MOSFET | SOT-23
4 | 511-TS4871ID |  |  | 0.82 | 3.28 | TS4890D | SO08-6.0 | TS487ID
4 | 815-8W24-4D1XT |  |  | 0.63 | 2.52 | CRYSTAL.3.2X2.5MM | 3.2X2.5MM | CRYSTAL.3.2X2.5MM
 |  |  |  | Gesamtpreis | 207.766
