romansonder/pro4e/hardware/pcb/Board_1_Eagle/Bestellung 28_03_2018/Board_1.xlsx

Sheet: Bestellliste
Bestellmenge | Mouser-Nr. | Preis pro Stück CHF | Preis CHF | Device | Package | Wert
5 | 81-ZRB15XC80J106ME5D | 1 | 5 | C_Ker | C0402 | 1u
5 | 80-CBR04C809B1GAC | 0.24 | 1.2 | C_Ker | C0402 | 8p
3 | 80-T490A107M6ATE500 | 1.17 | 3.51 | C_Tan | C1206 | 100u
15 | 80-C0402T104K4RACTU | 1.14 | 17.1 | C_Ker | C0402 | 100n
9 | 80-C0402C102J5HAUTO | 0.42 | 3.78 | C_Ker | C0402 | 1n
3 | 821-BAS40-05 | 0.336 | 1.008 | BAS40-05 | SOT23 | BAS40-05
3 | 595-TS3A27518EIPWRQ1 | 2.6 | 7.8 | TS3A27 | TSSOP24 | TS3A27
3 | 579-MCP73831T-3ACIOT | 0.64 | 1.92 | MCP73831 | SOT23-5 | MCP73831
3 | 595-TL1963A-33DCYR | 2.69 | 8.07 | LDO | SOT222 | 3.3V
3 | 579-TC1262-3.0VDB | 0.584 | 1.752 | LDO | SOT223 | 3V
3 | 649-202112100010C4LF | 0.69 | 2.07 | DEBUG_CONNECTOR | 10Pin
2 | 364-ACN52832 | 11.27 | 22.54 | ACM_52832_VER2
7 | 863-1HP04CH-TL-W | 0.6 | 4.2 | P-MOSFET | SOT-23
3 | 511-TS4871ID | 0.82 | 2.46 | TS4890D | SO08-6.0 | TS487ID
3 | 815-8W24-4D1XT | 0.63 | 1.89 | CRYSTAL.3.2X2.5MM | 3.2X2.5MM | CRYSTAL.3.2X2.5MM
 |  | Gesamtpreis | 84.3

Sheet: Alle Komponenten
Bestellen | Anzahl pro pcb | Bestellmenge | Device | Package | Wert | Mouser-Nr. | Preis CHF | Preis Summe | Parts
no | 4 | 8 | C_Ker | C0805 | 10u |  |  |  | C1, C2, C3, C6
yes | 2 | 5 | C_Ker | C0402 | 1u | 81-ZRB15XC80J106ME5D | 1 | 5 | C13, C18
yes | 2 | 5 | C_Ker | C0402 | 8p | 80-CBR04C809B1GAC | 0.24 | 1.2 | C20, C21
no | 1 | 2 | C_Ker | C0603 | 1n |  |  |  | C26
no | 1 | 2 | C_Ker | C0603 | 0R |  |  |  | C28
no | 1 | 2 | C_Ker | C0603 | 5.6u |  |  |  | C29
no | 1 | 2 | C_Ker | C0805 | 1u |  |  |  | C32
yes | 1 | 3 | C_Tan | C1206 | 100u | 80-T490A107M6ATE500 | 1.17 | 3.51 | C34
no | 2 | 4 | C_Ker | C0603 | 1u |  |  |  | C4, C23
no | 6 | 12 | C_Ker | C0603 | 100n |  |  |  | C5, C22, C25, C27, C30, C31
yes | 7 | 15 | C_Ker | C0402 | 100n | 80-C0402T104K4RACTU | 1.14 | 17.1 | C7, C9, C11, C14, C15, C16, C19
yes | 4 | 9 | C_Ker | C0402 | 1n | 80-C0402C102J5HAUTO | 0.42 | 3.78 | C8, C10, C12, C17
yes | 1 | 3 | BAS40-05 | SOT23 | BAS40-05 | 821-BAS40-05 | 0.336 | 1.008 | D1
yes | 1 | 3 | TS3A27 | TSSOP24 | TS3A27 | 595-TS3A27518EIPWRQ1 | 2.6 | 7.8 | IC30
yes | 1 | 3 | MCP73831 | SOT23-5 | MCP73831 | 579-MCP73831T-3ACIOT | 0.64 | 1.92 | IC1
yes | 1 | 3 | LDO | SOT222 | 3.3V | 595-TL1963A-33DCYR | 2.69 | 8.07 | IC2
yes | 1 | 3 | LDO | SOT223 | 3V | 579-TC1262-3.0VDB | 0.584 | 1.752 | IC2
no | 1 | 2 | VUB300 | QFN36-6X6 | VUB300 |  |  |  | IC3
no | 1 | 2 | WTV020SD | SSOP_20 | WTV020SD-20S |  |  |  | IC5
no | 1 | 2 |  |  |  |  |  |  | J1
no | 1 | 2 |  |  |  |  |  |  | J2
yes | 1 | 3 | DEBUG_CONNECTOR | 10Pin |  | 649-202112100010C4LF | 0.69 | 2.07 | J3
no | 2 | 4 | LED | LED_1206 |  |  |  |  | LED1, LED2
yes | 1 | 2 | ACM_52832_VER2 |  |  | 364-ACN52832 | 11.27 | 22.54 | MOD1
no | 1 | 2 | R_Chip | R0603 | 2k |  |  |  | R1
no | 3 | 6 | R_Chip | R0603 | 470k |  |  |  | R10, R16, R17
no | 7 | 14 | R_Chip | R0603 | 10k |  |  |  | R11, R21, R22, R23, R24, R25, R26
no | 10 | 20 | R_Chip | R0603 | 1k |  |  |  | R12, R14, R27, R28, R31, R37, R39, R40, R41, R42
no | 1 | 2 | R_Chip | R0603 | 150 |  |  |  | R18
no | 1 | 2 | R_Chip | R0603 | 15k |  |  |  | R19
no | 6 | 12 | R_Chip | R0603 | NP |  |  |  | R2, R3, R13, R15, R30, R36
no | 1 | 2 | R_Chip | R0603 | 330R |  |  |  | R20
no | 1 | 2 | R_Chip | R0603 | 0R |  |  |  | R29
no | 2 | 4 | R_Chip | R0402 | 15k |  |  |  | R34, R35
no | 1 | 2 | R_Chip | MINI_MELF-0102W | 0R |  |  |  | R38
no | 1 | 2 | R_Chip | R0402 | 100k |  |  |  | R4
no | 1 | 2 | R_Chip | R0402 | NP |  |  |  | R5
no | 1 | 2 | R_Chip | R0402 | 12k |  |  |  | R6
no | 1 | 2 | R_Chip | R0402 | 1M |  |  |  | R7
no | 2 | 4 | R_Chip | R0603 | Ferit Bead |  |  |  | R8, R9
no | 7 | 14 | SW |  |  |  |  |  | SW1, SW2, SW3, SW4, SW5, SW6, SW7
yes | 3 | 7 | P-MOSFET | SOT-23 |  | 863-1HP04CH-TL-W | 0.6 | 4.2 | T1, T2, T3
yes | 1 | 3 | TS4890D | SO08-6.0 | TS487ID | 511-TS4871ID | 0.82 | 2.46 | U$1
no | 4 | 8 | 1751248 | 1751248 | 1751248 |  |  |  | X1, X2, X3, X4
yes | 1 | 3 | CRYSTAL.3.2X2.5MM | 3.2X2.5MM | CRYSTAL.3.2X2.5MM | 815-8W24-4D1XT | 0.63 | 1.89 | Y1
 |  |  |  |  |  |  |  | 84.3
