romansonder/pro4e/documentation/05_technical_report_usermanual/60_technische_daten.tex

\begin{tabbing}
\hspace{40mm}		\= \hspace{15mm} \=\kill
Gerätebezeichnung:	\> Dojo Museumsführer \\[4mm]
Modell:				\> Team 3 \\[4mm]
Speicherkapazität:	\> 2 GB \\[4mm]
Schnittstelle:		\> USB 2.0 (High Speed) \\[4mm]
Abmessungen:		\> ca. 245 mm x 19.5 mm (L x H) \\[4mm]
Akku:				\> Wiederaufladbarer Li-Ion Akku; 3.9 V, 600 mAh \\[4mm]
Eingang:			\> 5 V, 500 mAh (via USB-Schnittstelle) \\[4mm]
Laufzeit*:			\> Bis zu 3.5 Stunden Abspielzeit \\[4mm]
\end{tabbing}

\begin{description}
\item *Akkulaufzeit kann je nach Abhängigkeit des Bedienverhaltens variieren.
\end{description}
