romansonder/pro4e/documentation/05_technical_report_usermanual/70_entsorgung.tex

Das Gerät darf keinesfalls mit dem normalen Hausmüll entsorgt werden. Informieren Sie sich daher über geeignete Entsorgungsstelle für Elektronikabfall.
\\[20mm]
\begin{figure}[h]
	\centering
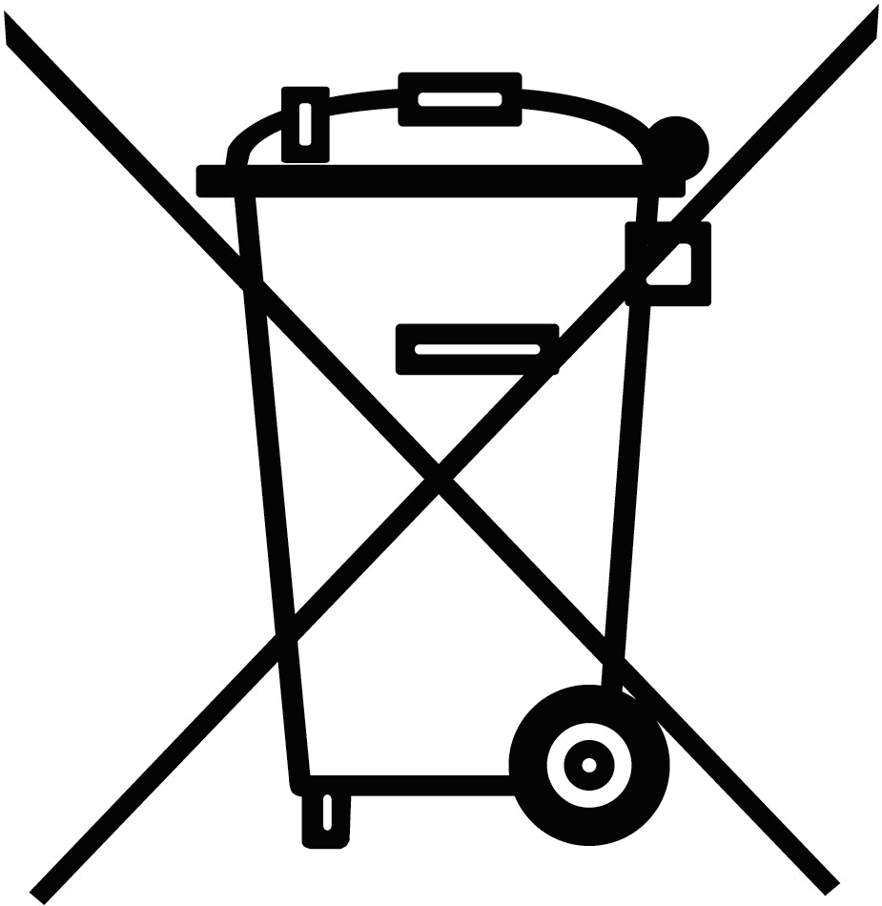
[picture p63: documentation/03_technical_report_usermanual/graphics/AbfallSymbol.jpg]
	
\end{figure}
