romansonder/pro4e/documentation/05_technical_report_usermanual/10_geraete_uebersicht.tex

\begin{figure}[h]
	\centering
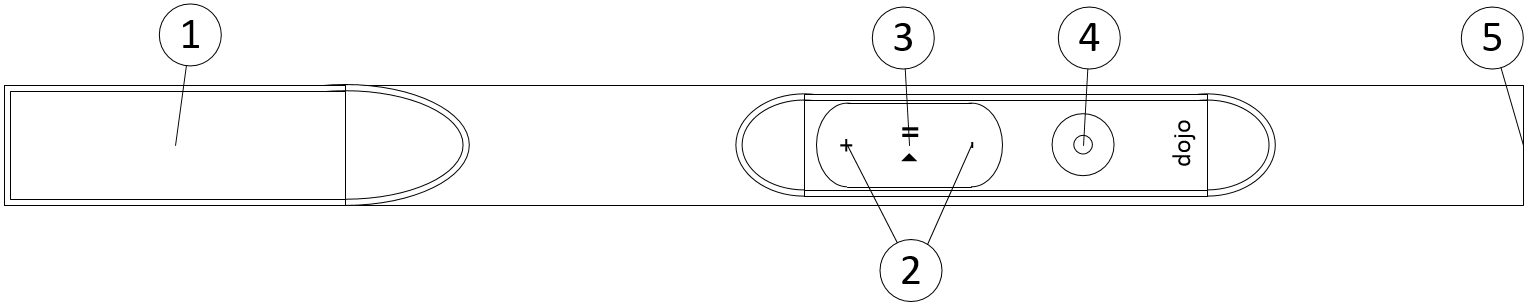
[picture p64: documentation/05_technical_report_usermanual/graphics/DojoUebersicht.PNG]
	
\end{figure}
\begin{center}
\parbox{50mm}{
\begin{enumerate}
	\item Knochenschallgeber
    \item Lautstärke -/+
    \item Play/Pause
    \item Like Knopf
    \item USB Anschluss
\end{enumerate}}
\end{center}
