romansonder/pro4e/documentation/05_technical_report_usermanual/20_ueber_dieses_geraet.tex

\textbf{Lieferumfang}

\begin{itemize}
\item Dojo Museumsführer
\end{itemize}
\begin{itemize}
\item Bedienungsanleitung
\end{itemize}
\begin{itemize}
\item Dojo-Transmitterstation
\end{itemize}
\begin{itemize}
\item USB-Kabel ($1m$)
\end{itemize}
\begin{itemize}
\item Java Testsoftware
\end{itemize}
\begin{itemize}
\item Audio Konvertierungs Tool
\end{itemize}
\textbf{Systemvoraussetzungen}
\\[4mm]
Wenn das Gerät mit dem Computer verbindet werden soll, um die Kunstobjekte zu aktualisieren, müssen folgende Voraussetzungen erfüllt sein.
\begin{itemize}
\item Computer mit mindestens USB 2.0 Schnittstelle
\end{itemize}
\begin{itemize}
\item Ubuntu oder Windows 7 und höher.
\end{itemize}
\begin{itemize}
\item Java runtime environment (JRE) installiert
\end{itemize}
