romansonder/pro4e/documentation/05_technical_report_usermanual/50_bedienung.tex

\textbf{Knopffunktionen}

\begin{table}[htb]
\centering
\begin{tabular}{|c|l|}
\hline
\textbf{Knopf} & \textbf{Funktion}                                                                                                                                                                                                            \\ \hline
1              & \begin{tabular}[c]{@{}l@{}}Lautstärke lauter: Damit die Lautstärke des Knochenschallgebers lauter wird,\\ muss der Knopf 1 so oft gedrückt werden bis die gewünschte Lautstärke eingestellt ist.\end{tabular}                \\ \hline
2              & \begin{tabular}[c]{@{}l@{}}Play/Pause: Sobald der Dojo in Reichweite eines Kunstwerkes ist, beginnt dieser zu verbrieren.\\ Mit Hilfe dieses Knopfes 2 kann nun die Wiedergabe gestartet resp. pausiert werden.\end{tabular} \\ \hline
3              & \begin{tabular}[c]{@{}l@{}}Lautstärke leiser: Damit die Lautstärke des Knochenschallgebers leiser wird,\\ muss der Knopf 3 so oft gedrückt werden bis die gewünschte Lautstärke eingestellt ist.\end{tabular}                \\ \hline
4              & \begin{tabular}[c]{@{}l@{}}Liken: Sobald sich der Dojo in der Reichweite eines Kunstwerkes befindet,\\ kann der Knopf 4 dazu genutzt werden, um eine Kunstwerk zu liken.\end{tabular}                                        \\ \hline
\end{tabular}
\end{table}

* Tasten 1..4 beziehen sich auf die Knöpfe von links nach rechts dargestellt in Abbildung in Kapitel \ref{sec:geraete_uebersicht}.
