romansonder/pro4e/documentation/03_technical_report/graphics/Aufbau2.pdf

## Ansicht von Unten

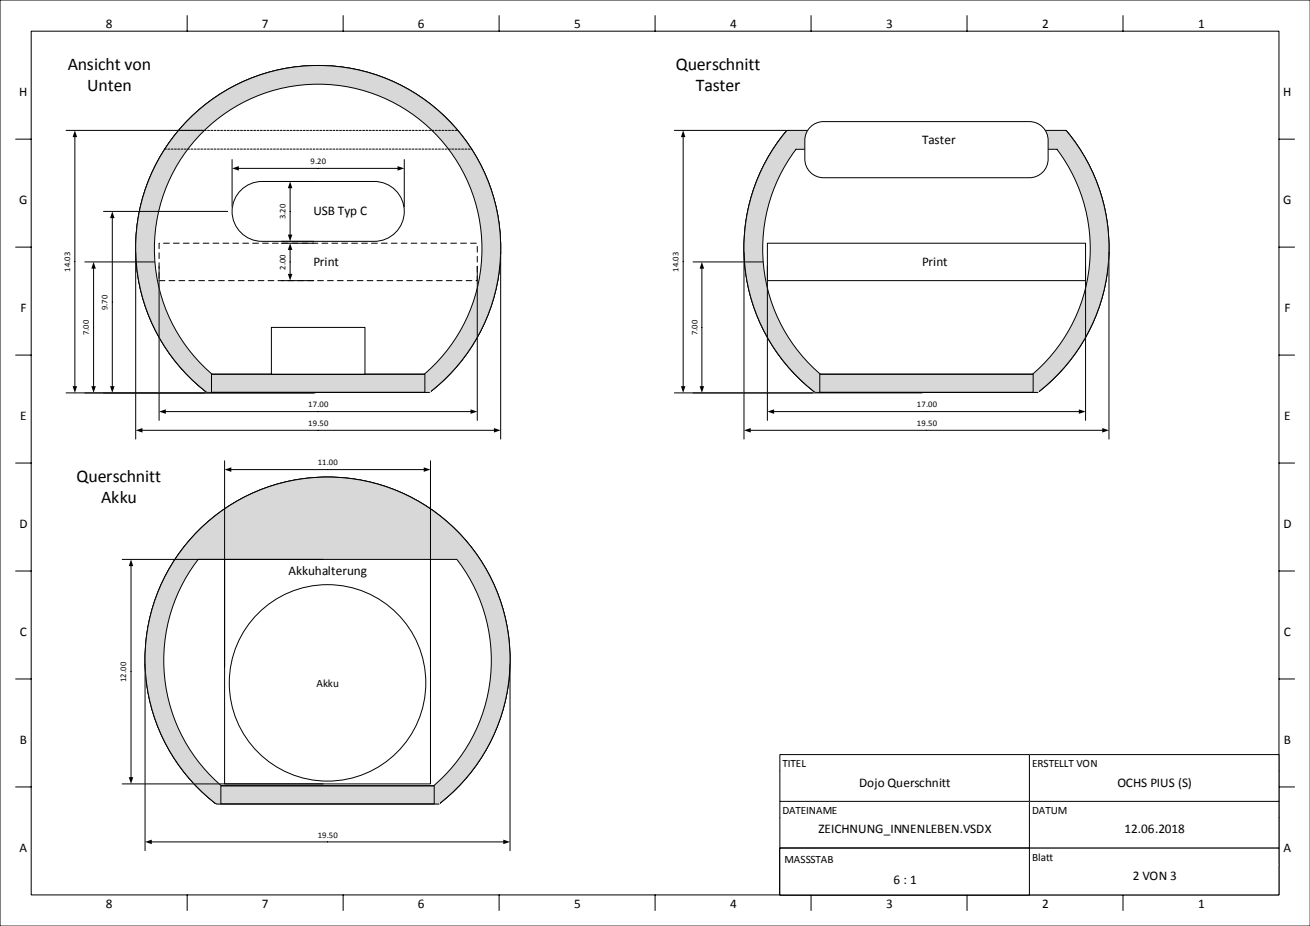
[picture p73: page 1]
DATUM; DATEINAME ZEICHNUNG_INNENLEBEN.VSDX; ERSTELLT VON; OCHS PIUS (S); Blatt; TITEL; Dojo Querschnitt; MASSSTAB; USB Typ C; Print; Querschnitt Taster; Taster; Querschnitt Akku; Akku; Akkuhalterung
