romansonder/pro4e/documentation/03_technical_report/graphics/Board_13.pdf

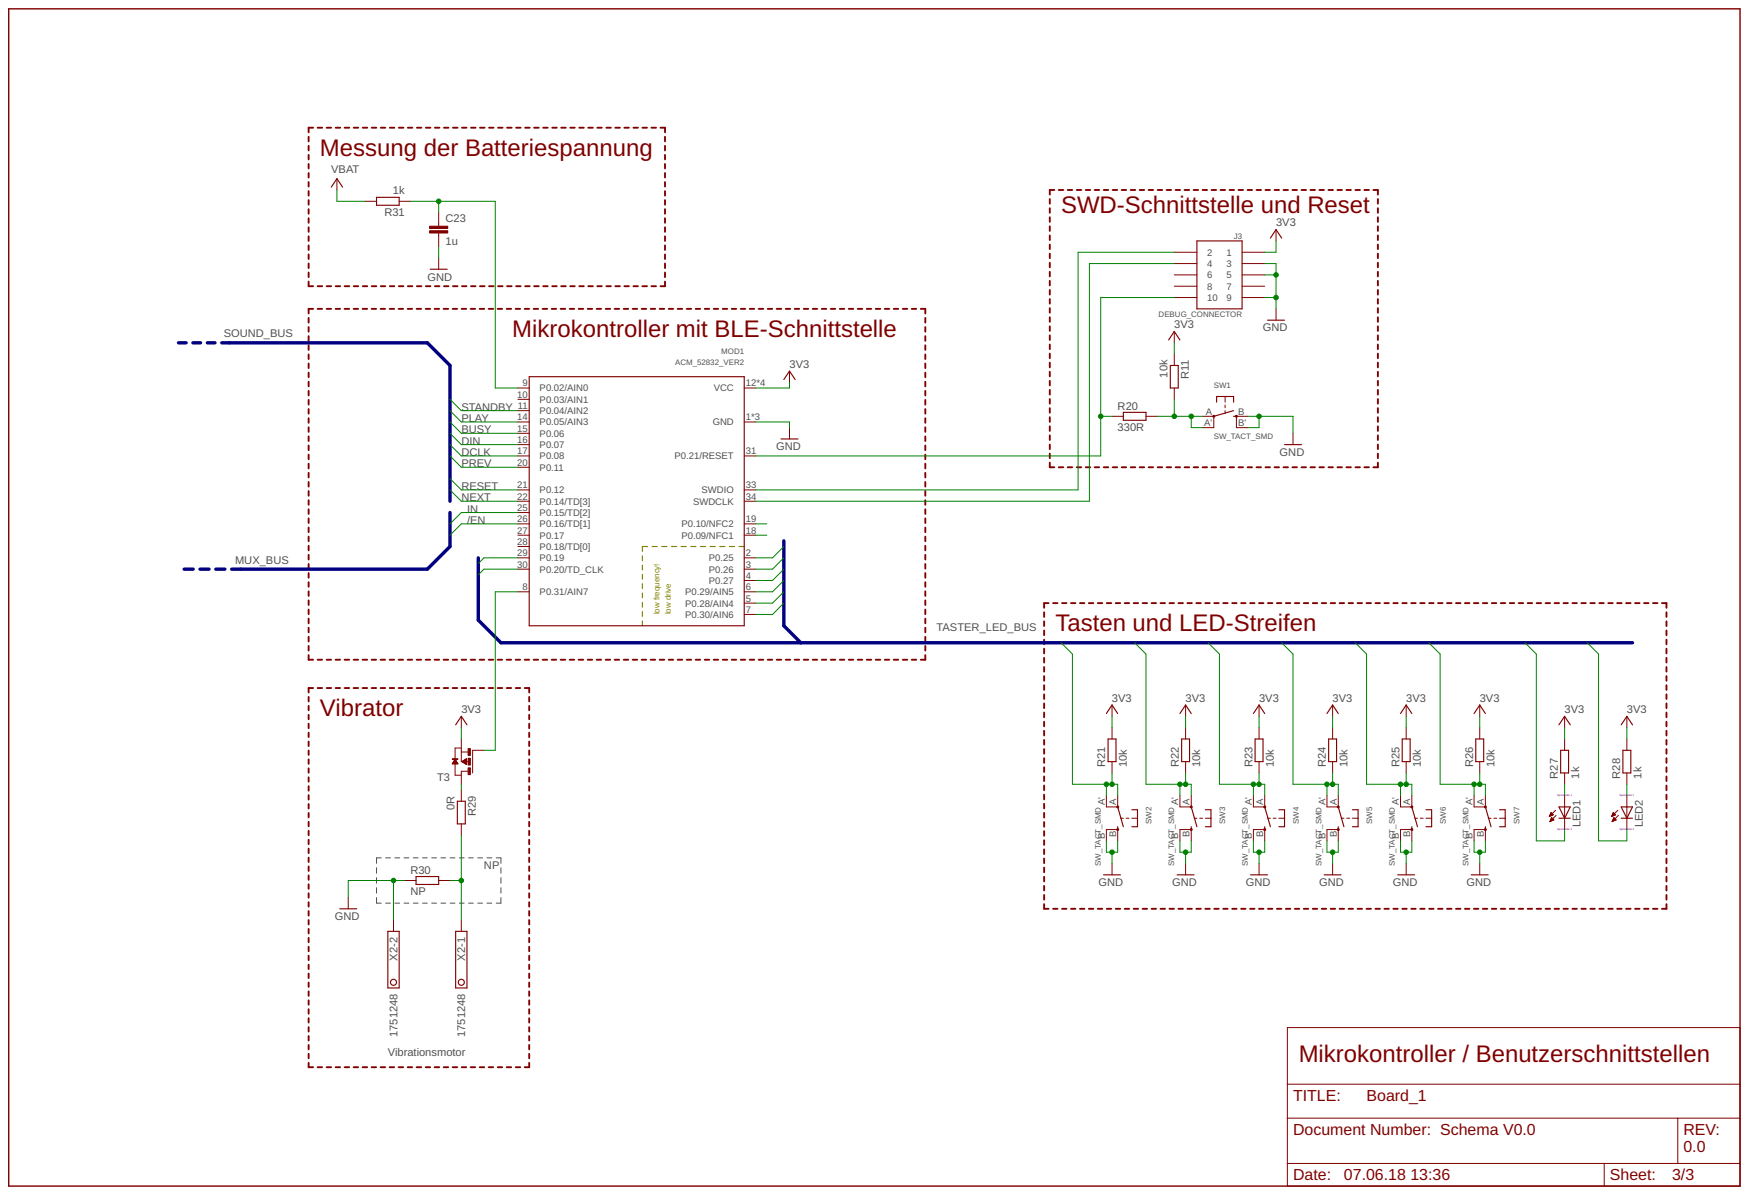
[picture p74: page 1]

SWD-Schnittstelle und Reset

Mikrokontroller mit BLE-Schnittstelle

Tasten und LED-Streifen

Document Number: Schema V0.0 | REV: 0.0

Date: 07.06.18 13:36 | Sheet: 3/3
