romansonder/pro4e/documentation/03_technical_report/graphics/Board_23.pdf

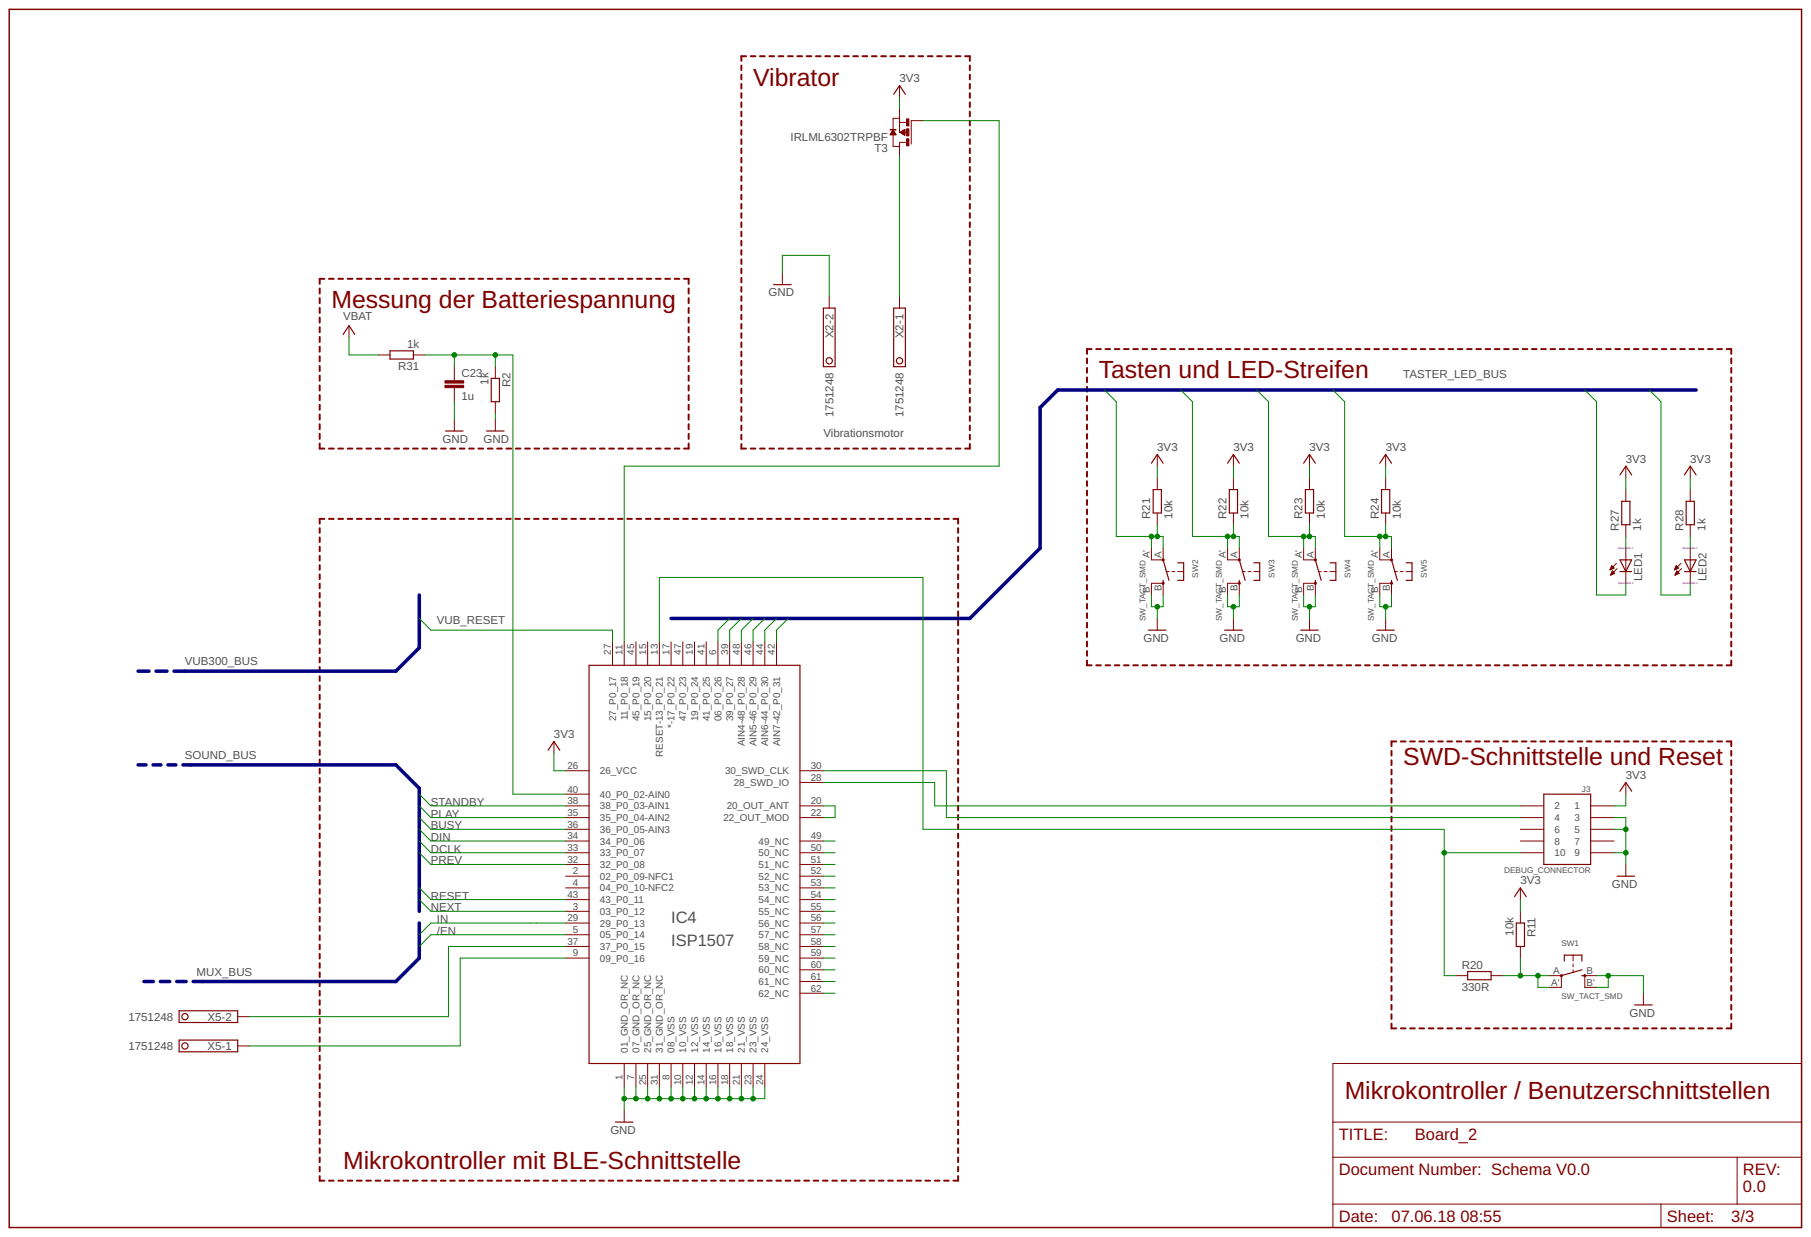
[picture p75: page 1]

Tasten und LED-Streifen

SWD-Schnittstelle und Reset

Document Number: | REV: 0.0

Date: 07.06.18 08:55 | Sheet: 3/3
