romansonder/pro4e/documentation/03_technical_report/graphics/Softwarekonzeptzeichnung1.pdf

H

G

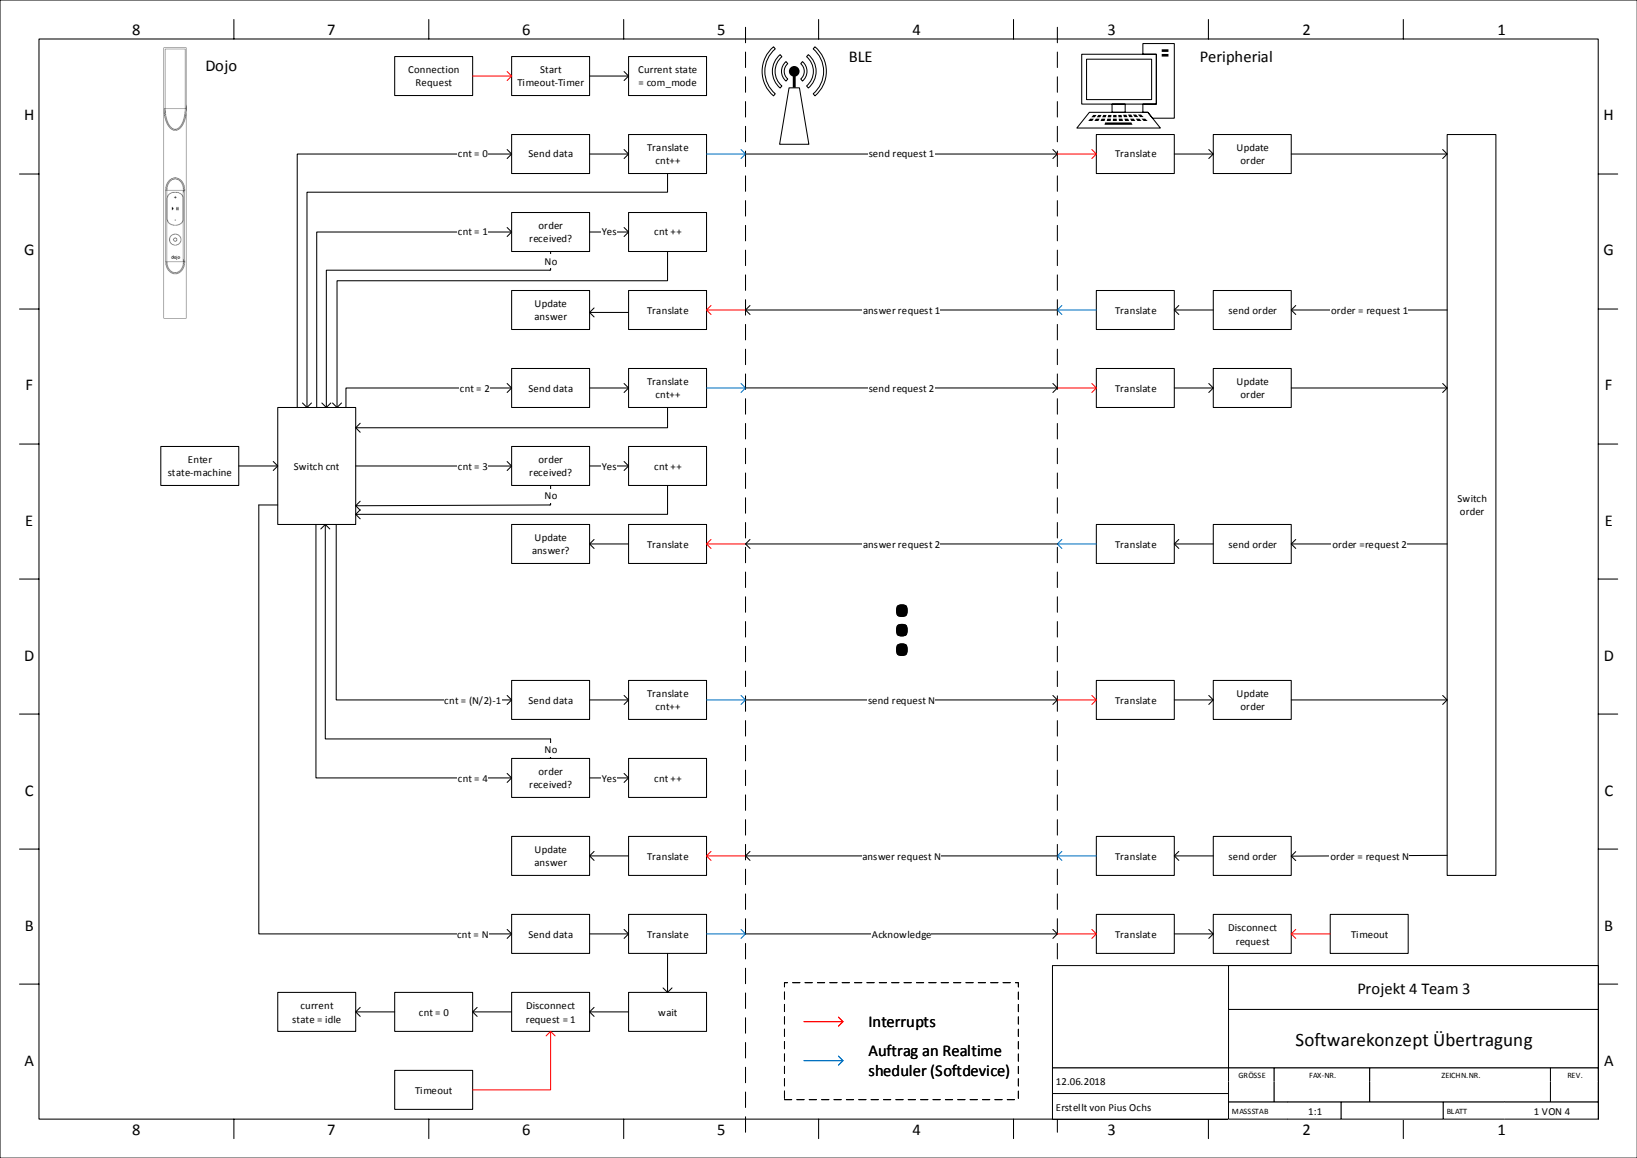
[picture p76: page 1]
Connection Request; Start Timeout-Timer; Current state = com_mode; Send data; Translate; cnt++; order received?; Translate Update answer; cnt ++; Translate Update answer?; wait Disconnect request = 1; Timeout; cnt = 0 current state = idle; cnt = 0; cnt = 2; cnt = (N/2)-1; cnt = N; Dojo; BLE; Peripherial; Update; order; send order; Switch order; Disconnect; request; order =request 2; order = request 1; send request 1; answer request 1; send request 2; answer request 2; send request N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

Switch cnt Enter
state-machine

Interrupts
Auftrag an Realtime
sheduler (Softdevice)

Erstellt von Pius Ochs
