romansonder/pro4e/documentation/03_technical_report/graphics/Softwarekonzeptzeichnung2.pdf

H

G

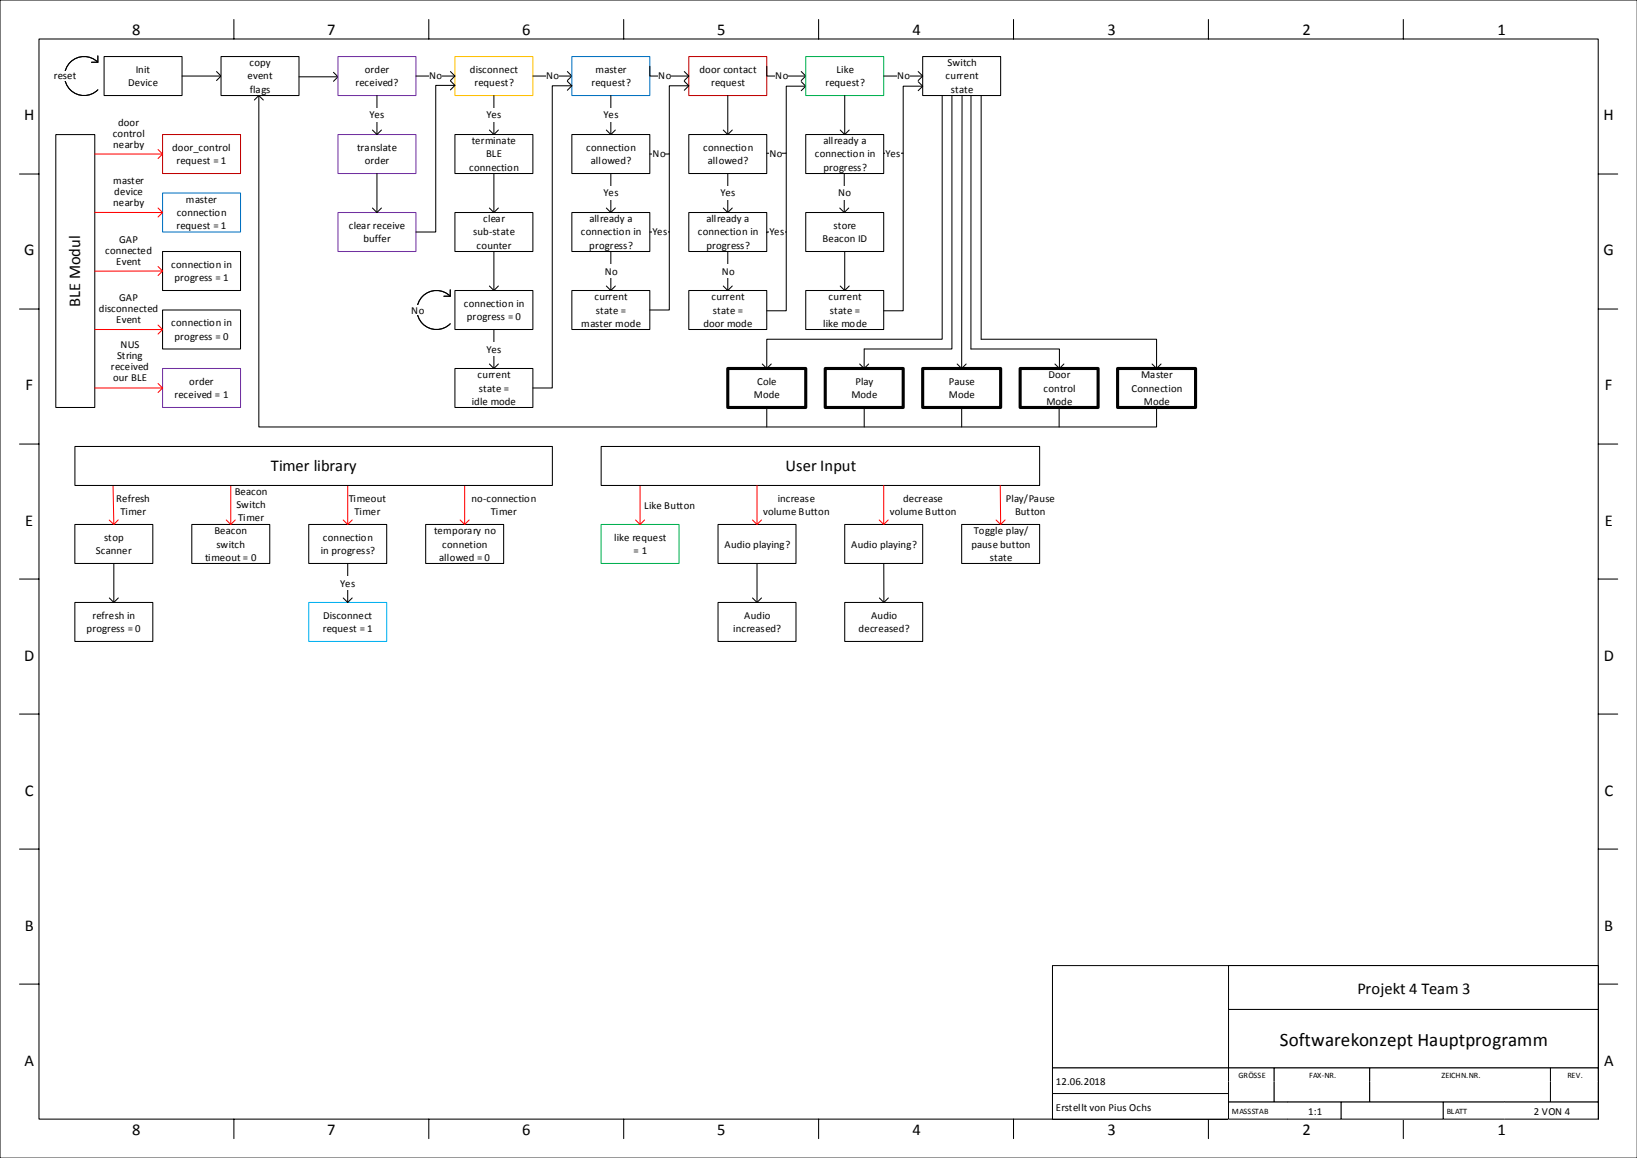
[picture p77: page 1]
Init Device; copy event flags; disconnect; request?; Yes; terminate BLE connection; clear sub-state counter; connection in progress = 0; reset; current state = idle mode; master request?; connection allowed?; allready a connection in progress?; current state = master mode; door contact request; current state = door mode; Switch current state; Cole Mode; Play Mode; Pause Mode; Door control Mode; Master Connection Mode; like request = 1; Like Button; temporary no connetion allowed = 0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

Erstellt von Pius Ochs
