romansonder/pro4e/documentation/03_technical_report/graphics/Softwarekonzeptzeichnung3.pdf

H

G

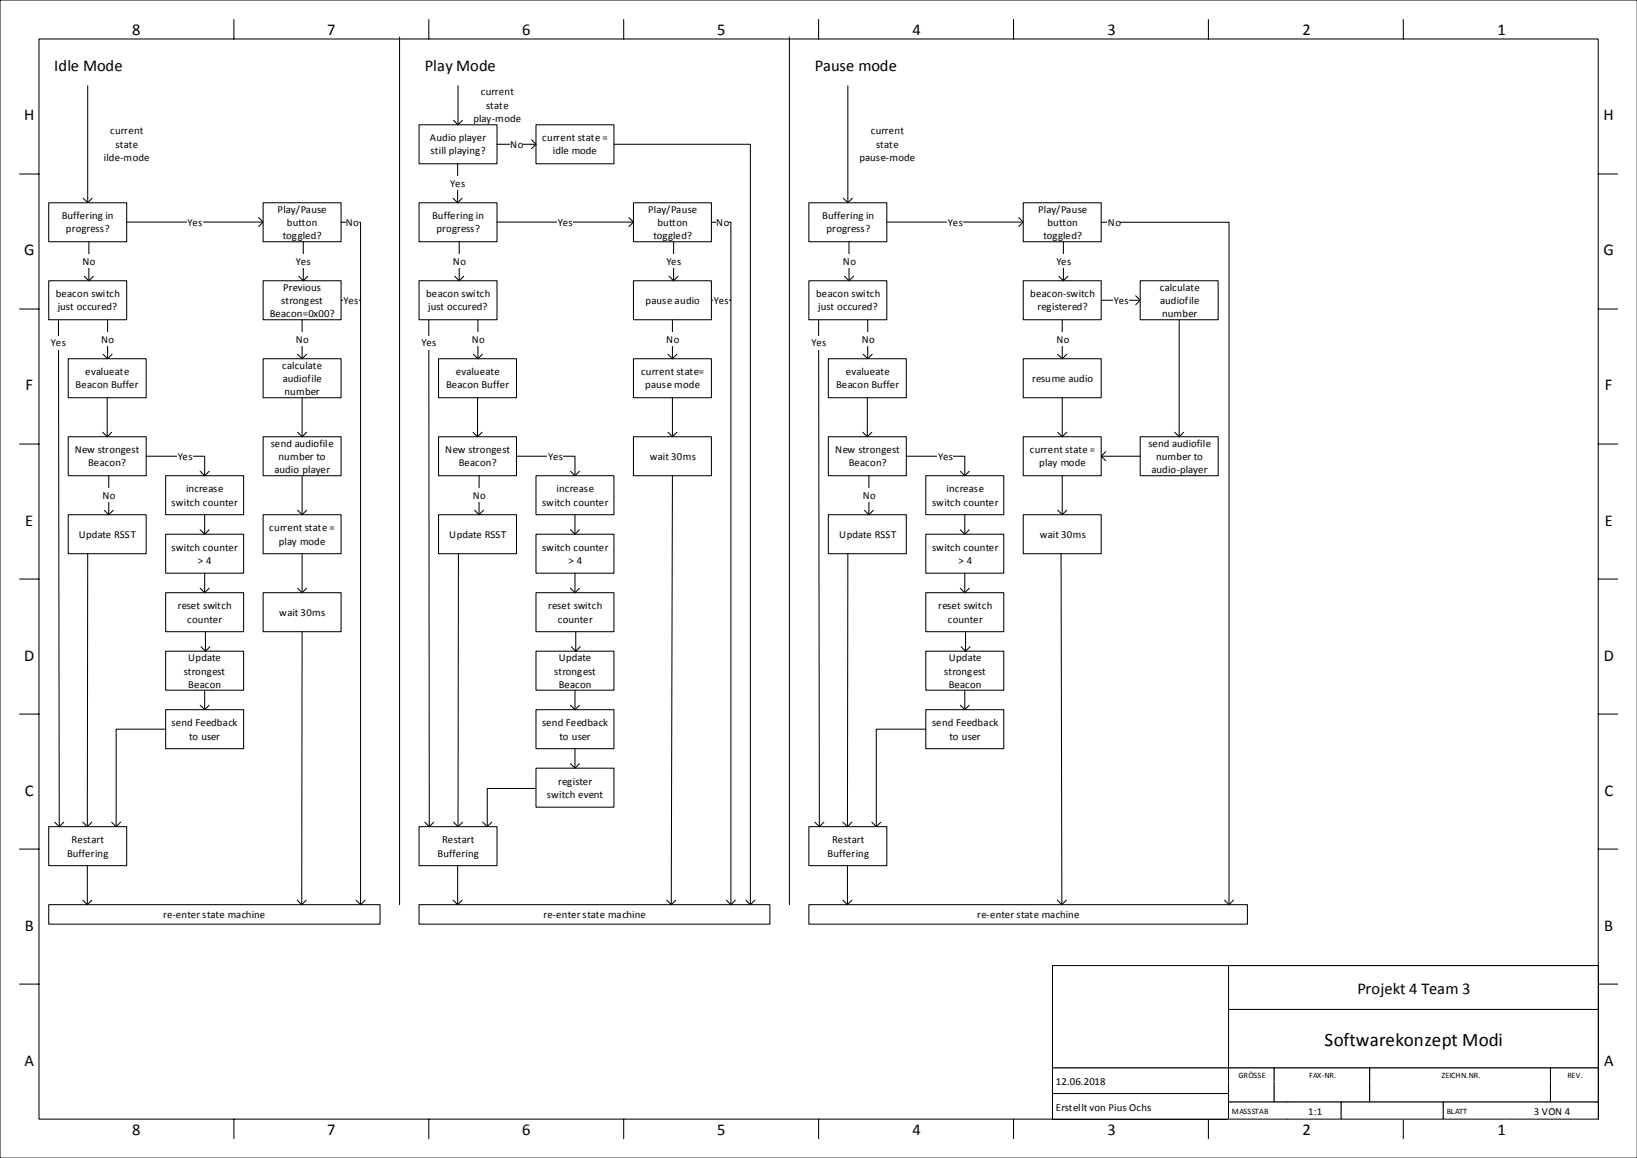
[picture p78: page 1]
Buffering in; progress?; Yes; Play/Pause button toggled?; Idle Mode; Previous strongest Beacon=0x00?; calculate audiofile number; send audiofile number to audio player; current state = play mode; wait 30ms; beacon switch just occured?; evalueate Beacon Buffer; New strongest Beacon?; Update RSST; increase switch counter; switch counter > 4; reset switch counter; Update strongest Beacon; send Feedback to user; Restart Buffering; Audio player still playing?; pause audio; current state= pause mode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

current state =
idle mode No

re-enter state machine

Erstellt von Pius Ochs
