romansonder/pro4e/documentation/03_technical_report/graphics/Softwarekonzeptzeichnung4.pdf

H

G

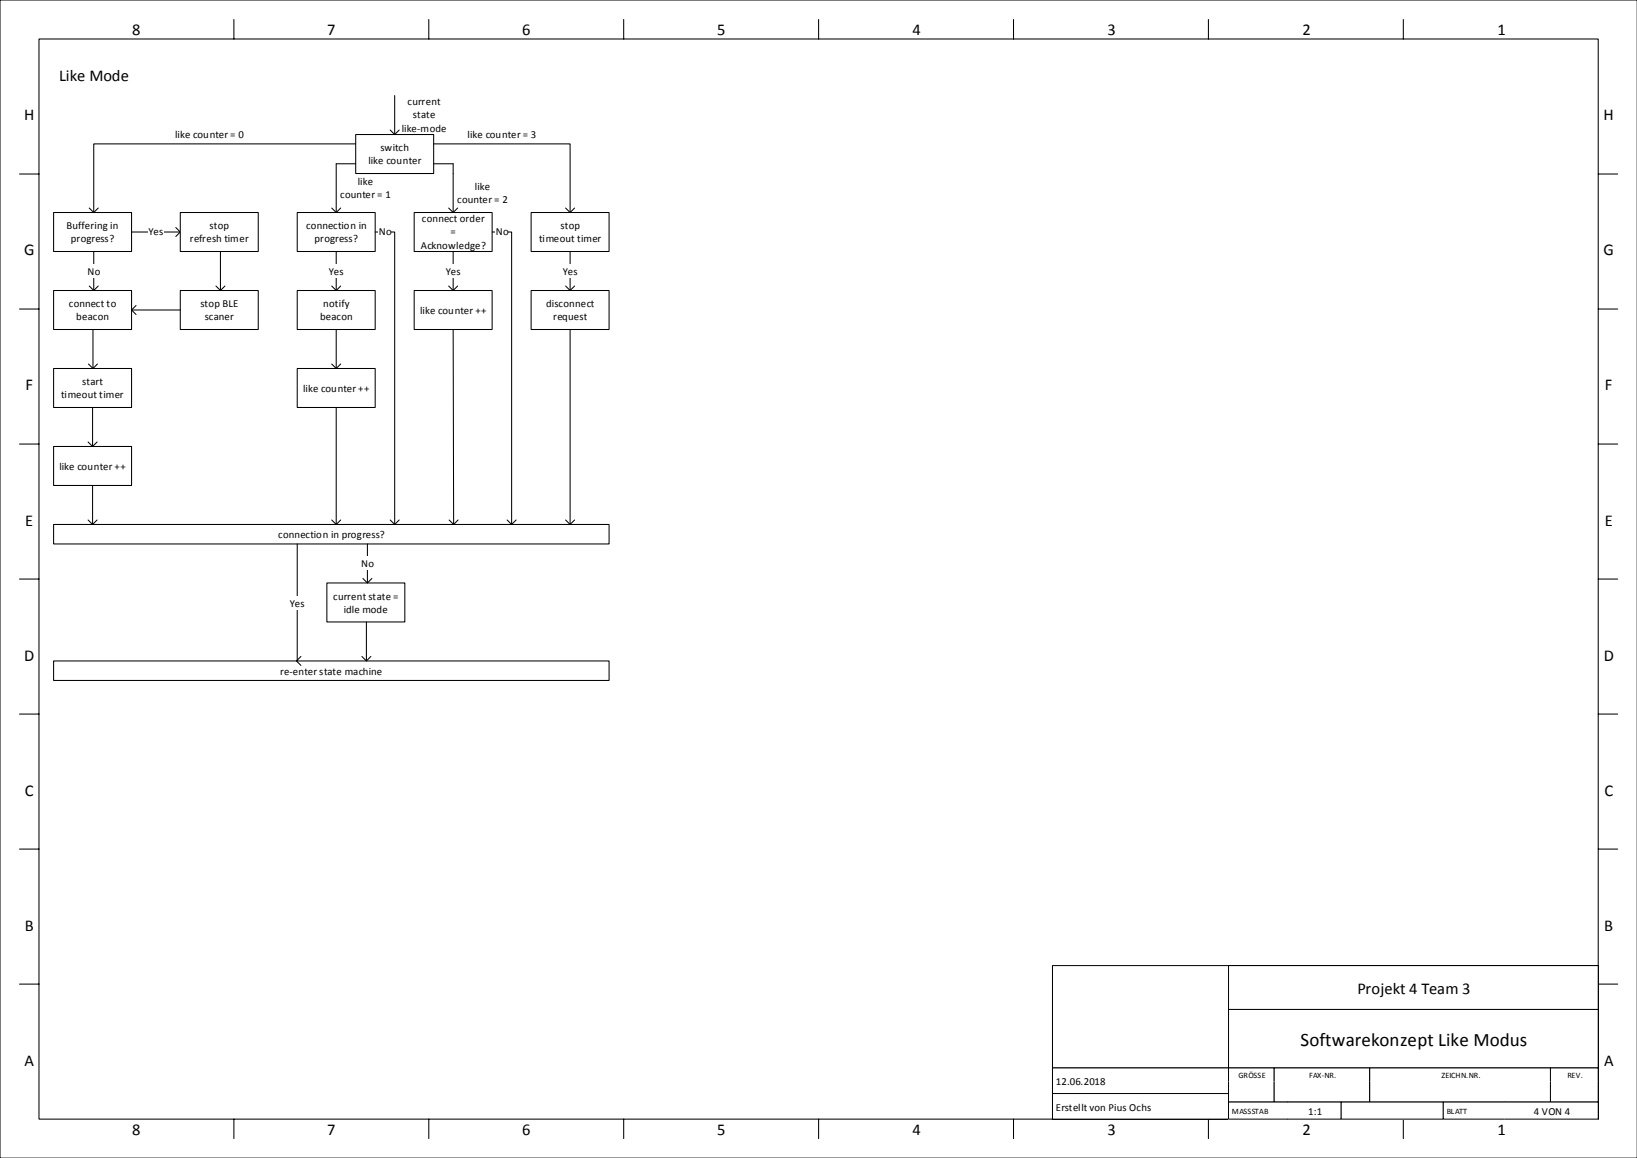
[picture p79: page 1]
Buffering in; progress?; Yes; stop; refresh timer; Like Mode; stop BLE scaner; connect to beacon; start timeout timer; like counter ++; current state like-mode; switch like counter; connection in progress?; notify beacon; like counter = 1; like counter = 0; connect order = Acknowledge?; like counter = 2; stop timeout timer; disconnect request; like counter = 3; current state = idle mode; Projekt 4 Team 3; GRÖSSE; FAX-NR.; ZEICHN.NR.; REV.; MASSSTAB; BLATT; 4 VON 4

connection in progress?

re-enter state machine

Softwarekonzept Like Modus

Erstellt von Pius Ochs
