romansonder/pro4e/documentation/03_technical_report/graphics/Board_1.pdf

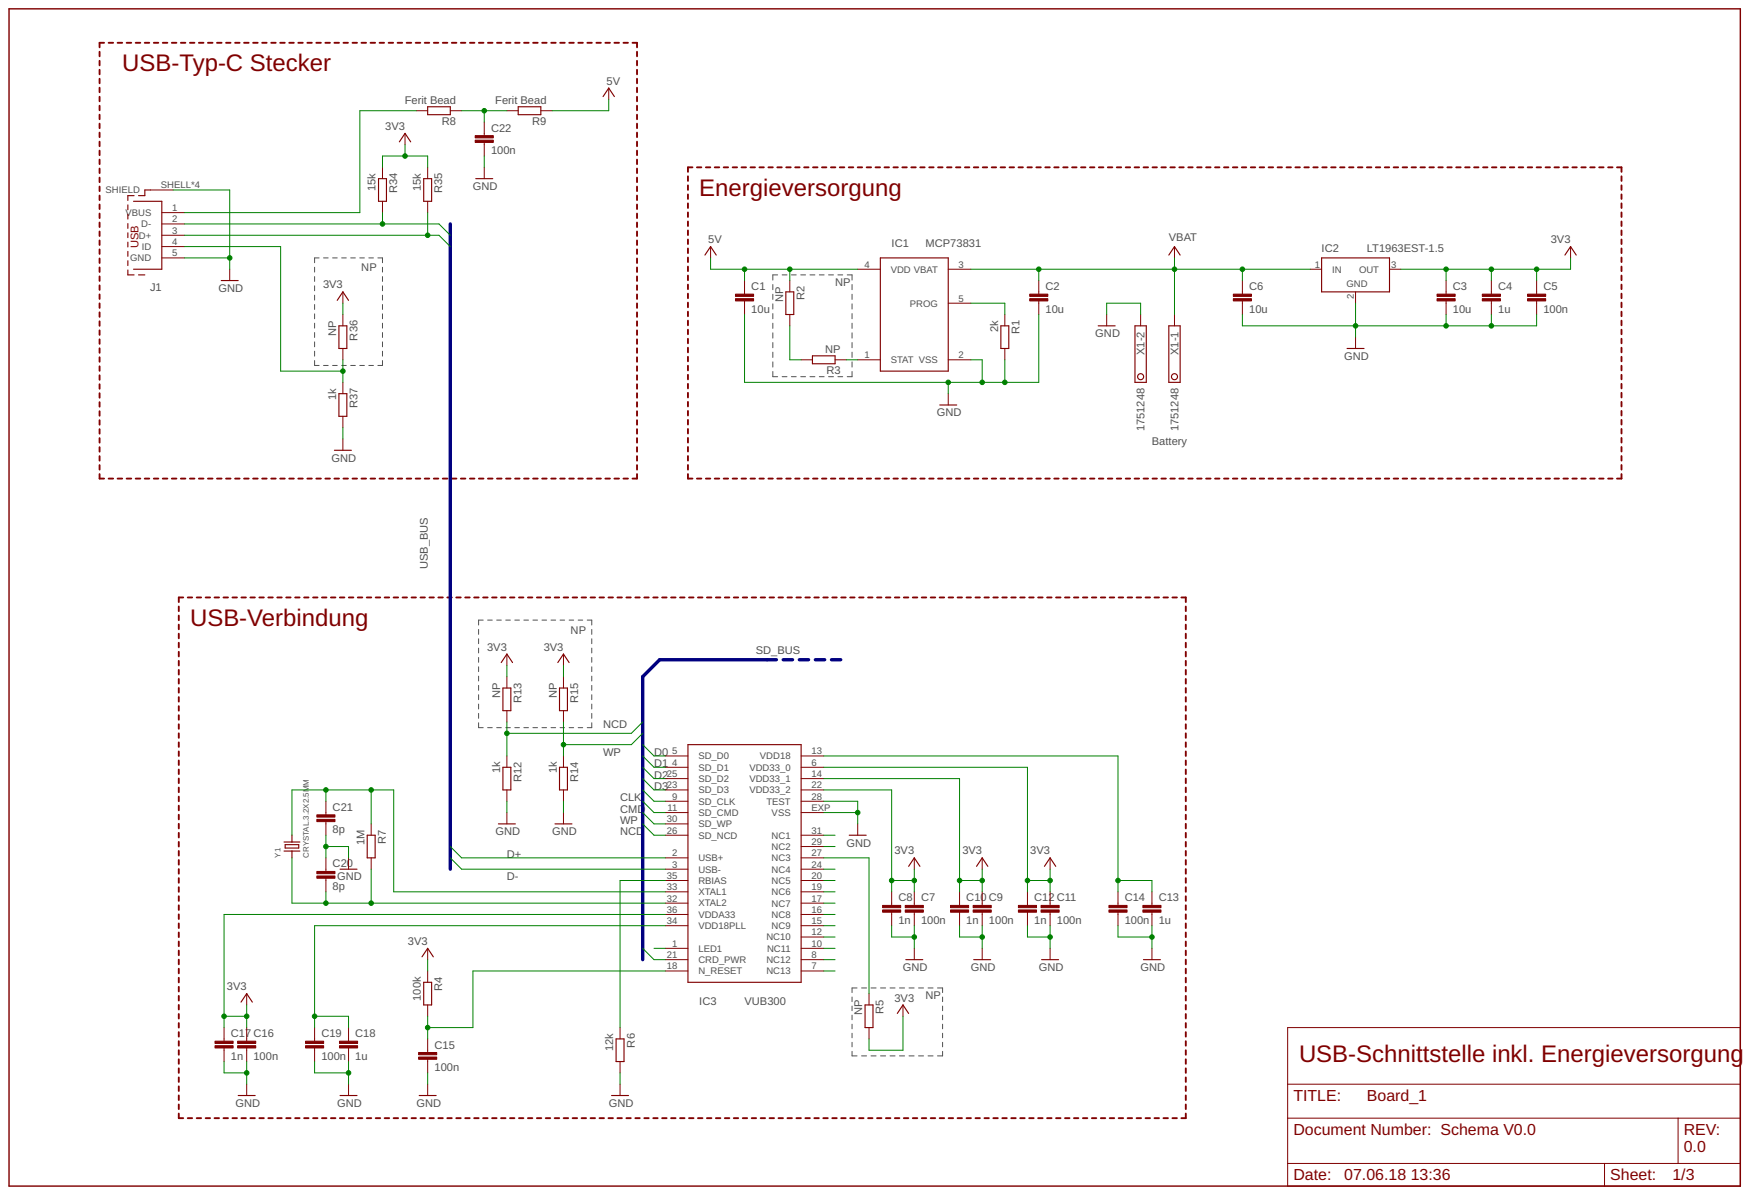
[picture p80: page 1]

USB-Schnittstelle inkl. Energieversorgung

Document Number: Schema V0.0 | REV: 0.0

Date: 07.06.18 13:36 | Sheet: 1/3

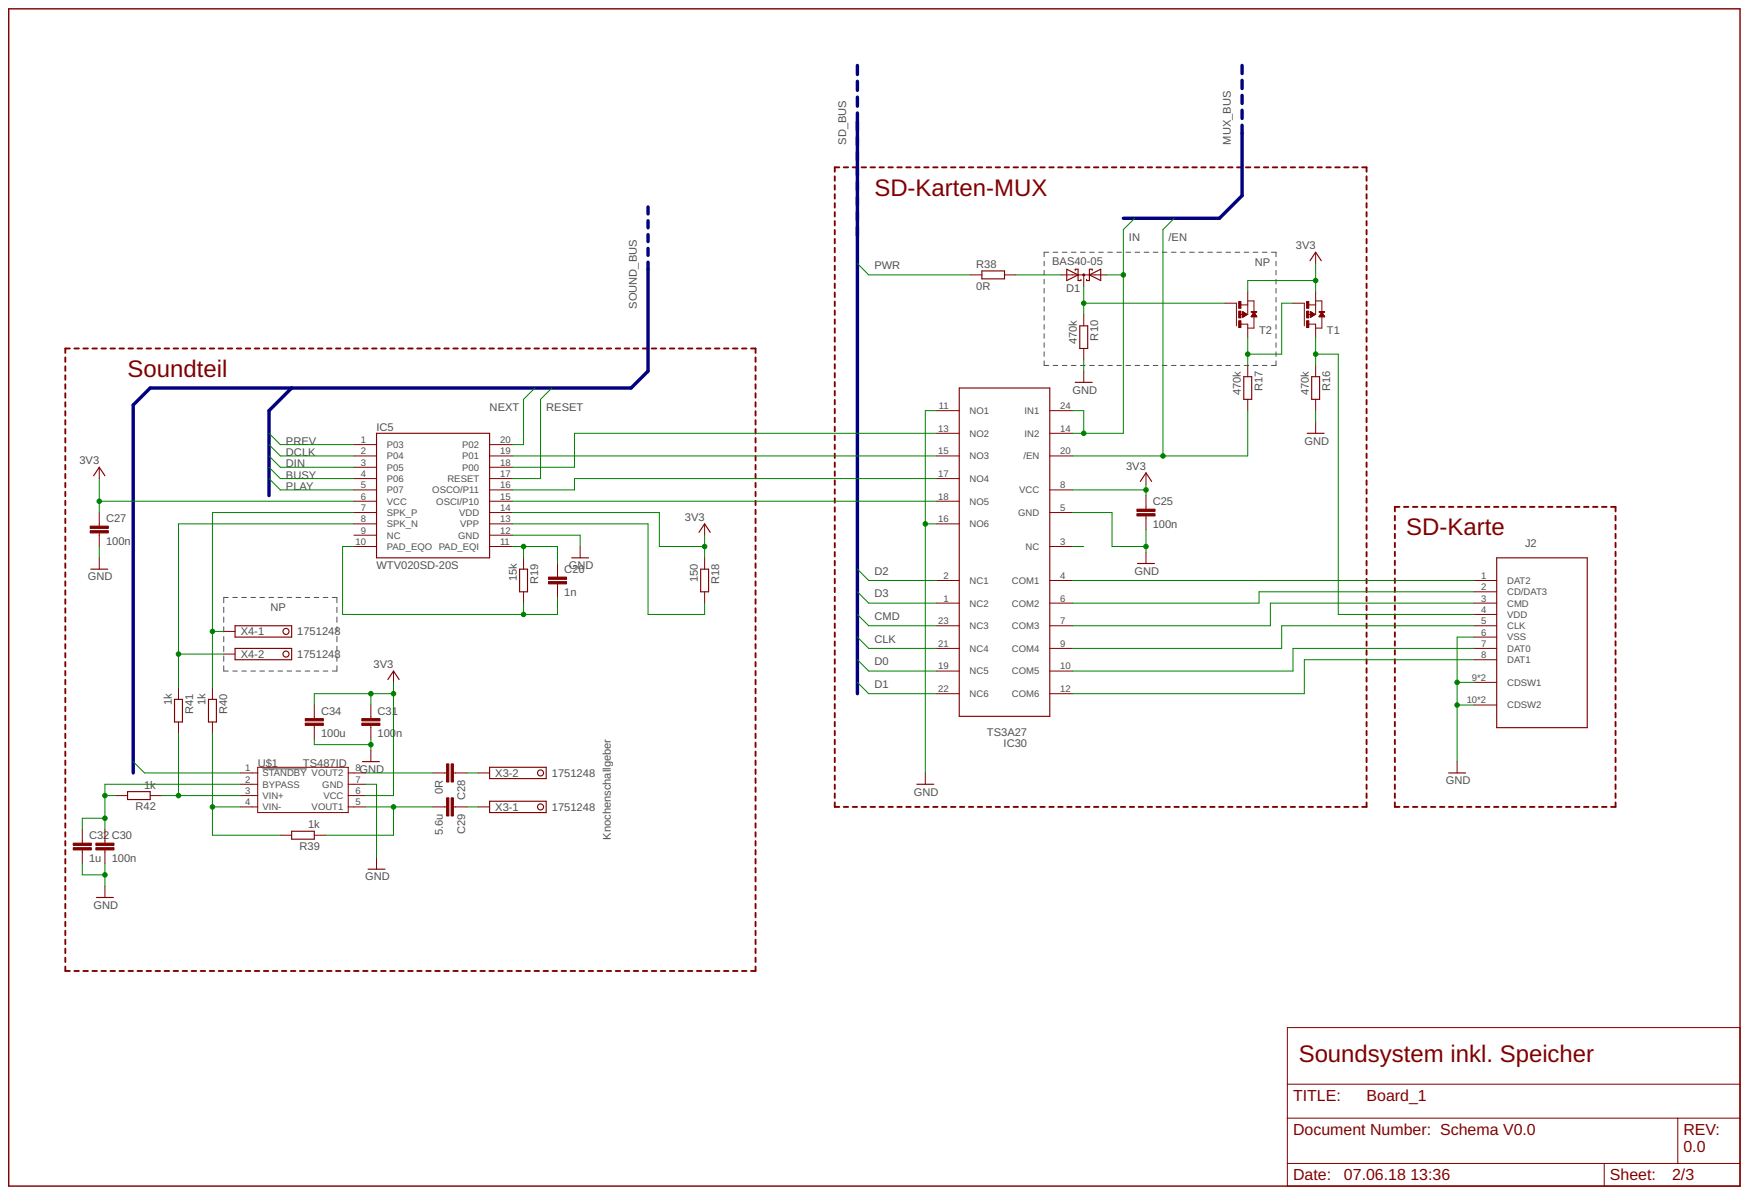
[picture p81: page 2]


SWD-Schnittstelle und Reset

Mikrokontroller mit BLE-Schnittstelle

Tasten und LED-Streifen
