romansonder/pro4e/documentation/03_technical_report/graphics/Board_1_Best_bottom.pdf

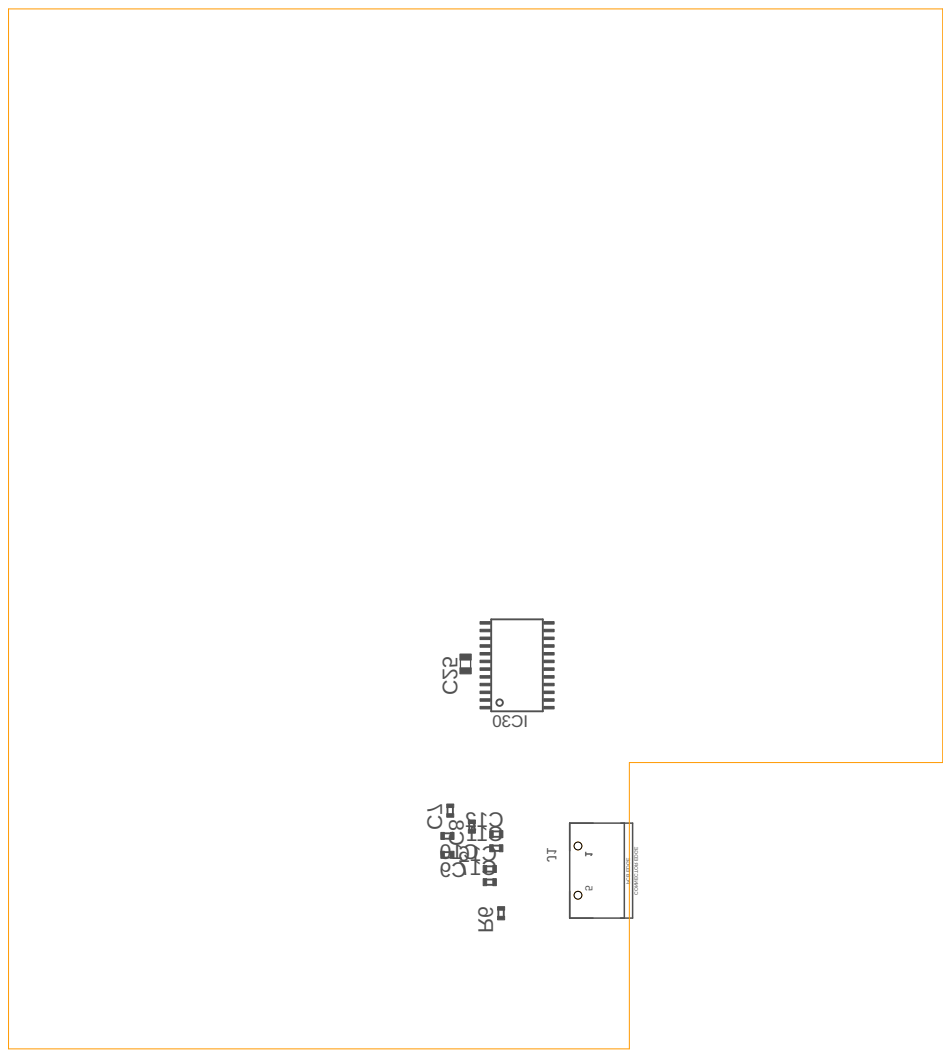
[picture p82: page 1]

01 C11 C 261 C 7 C25 C7 C8 9 C 03 CI R6 J11 5 PCB EDGE CONNECTOR EDGE 1
