romansonder/pro4e/documentation/03_technical_report/graphics/Board_2.pdf

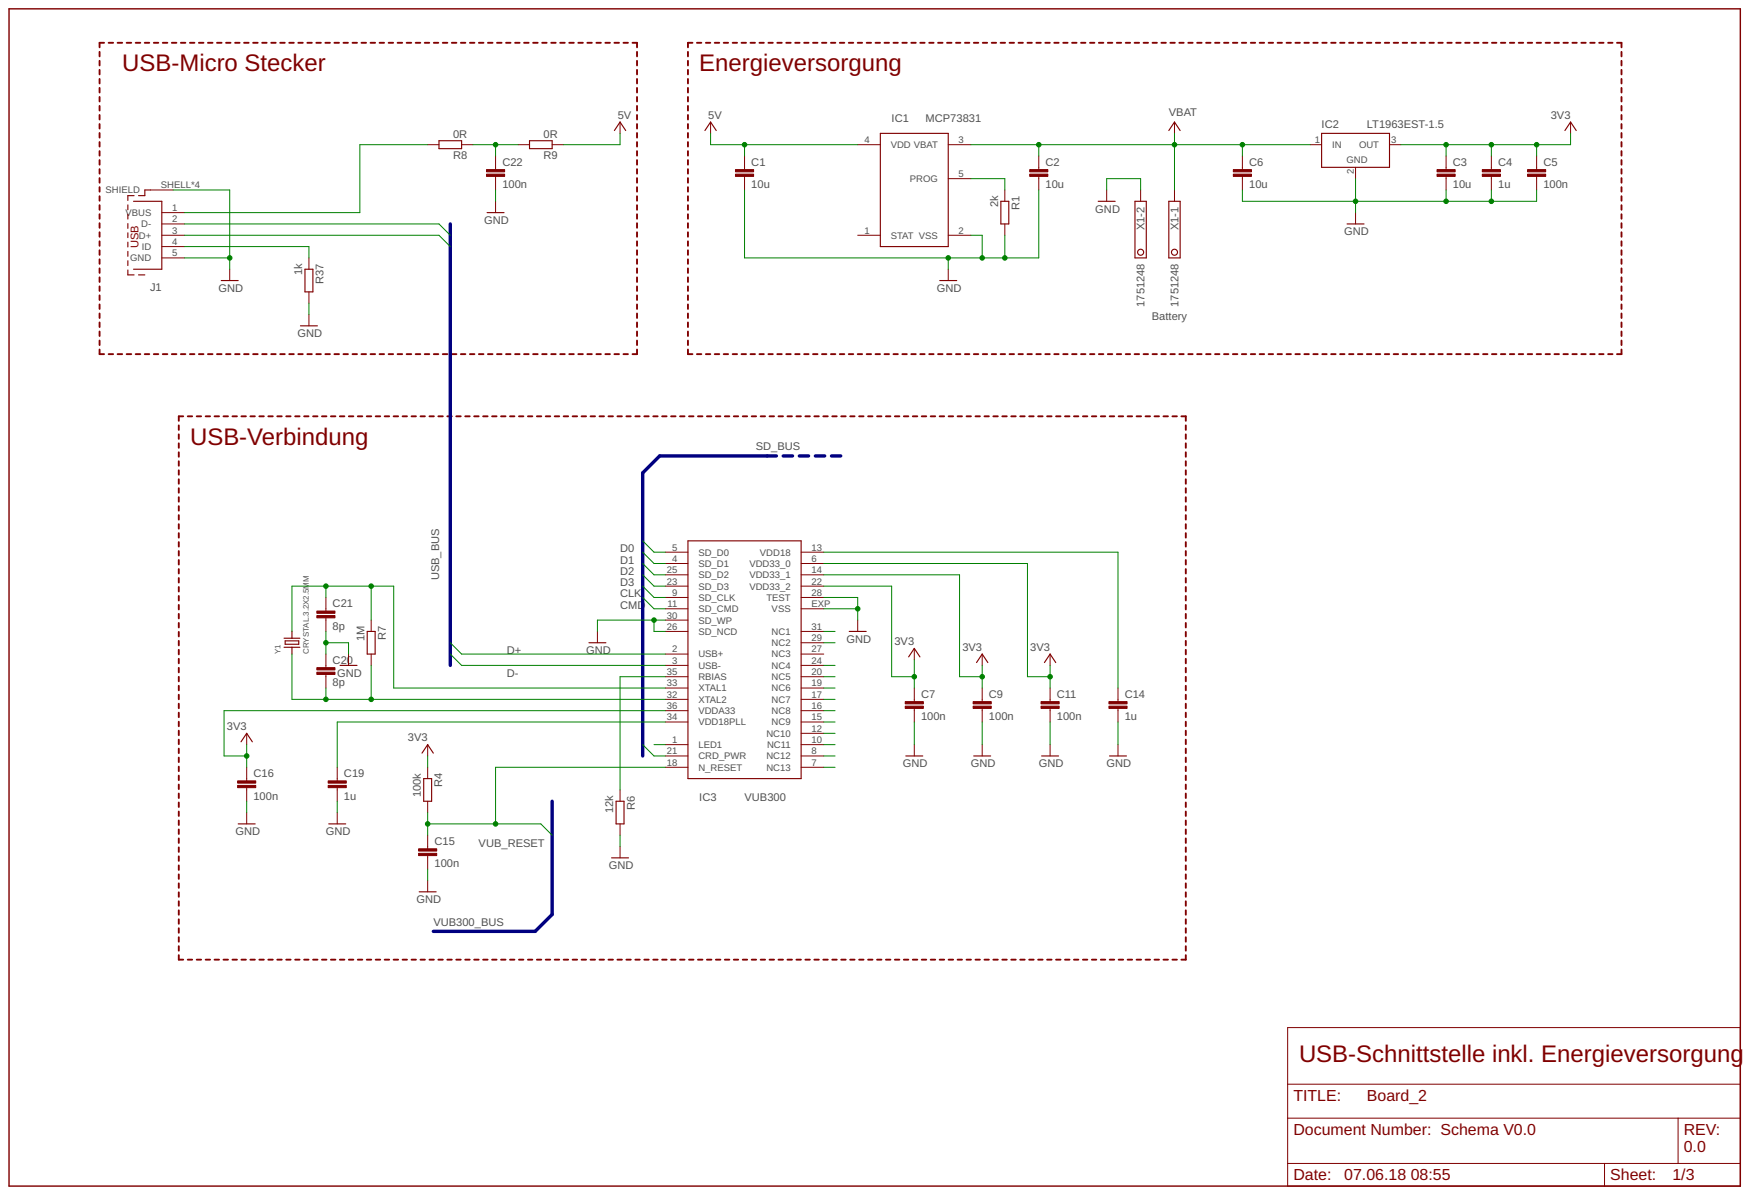
[picture p83: page 1]

USB-Schnittstelle inkl. Energieversorgung

Document Number: Schema V0.0 | REV: 0.0

Date: 07.06.18 08:55 | Sheet: 1/3

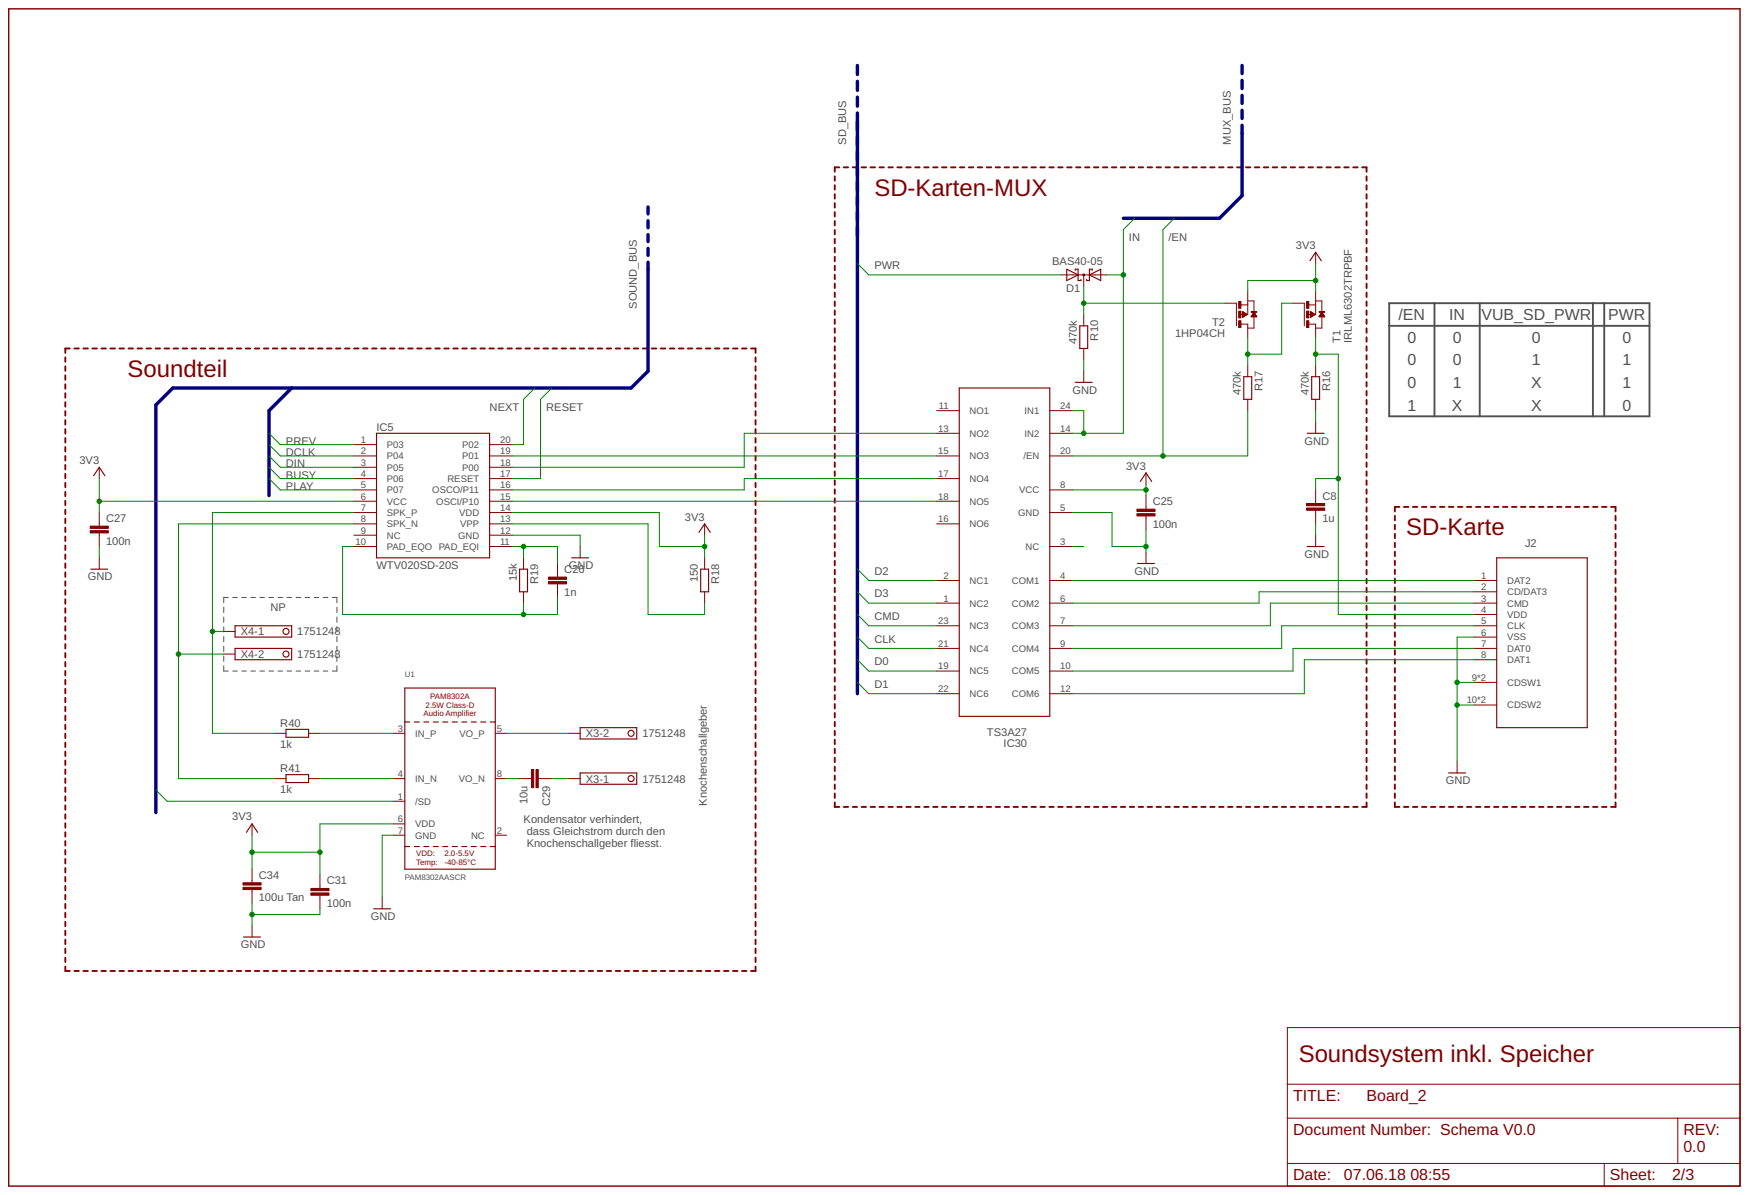
[picture p84: page 2]

/EN | IN | VUB_SD_PWR | PWR
0 0 0 1 | 0 0 1 X | 0 1 X X | 0 1 1 0


Tasten und LED-Streifen

SWD-Schnittstelle und Reset
