romansonder/pro4e/hardware/pcb/Board_1_Eagle/Board/Board_1.pdf

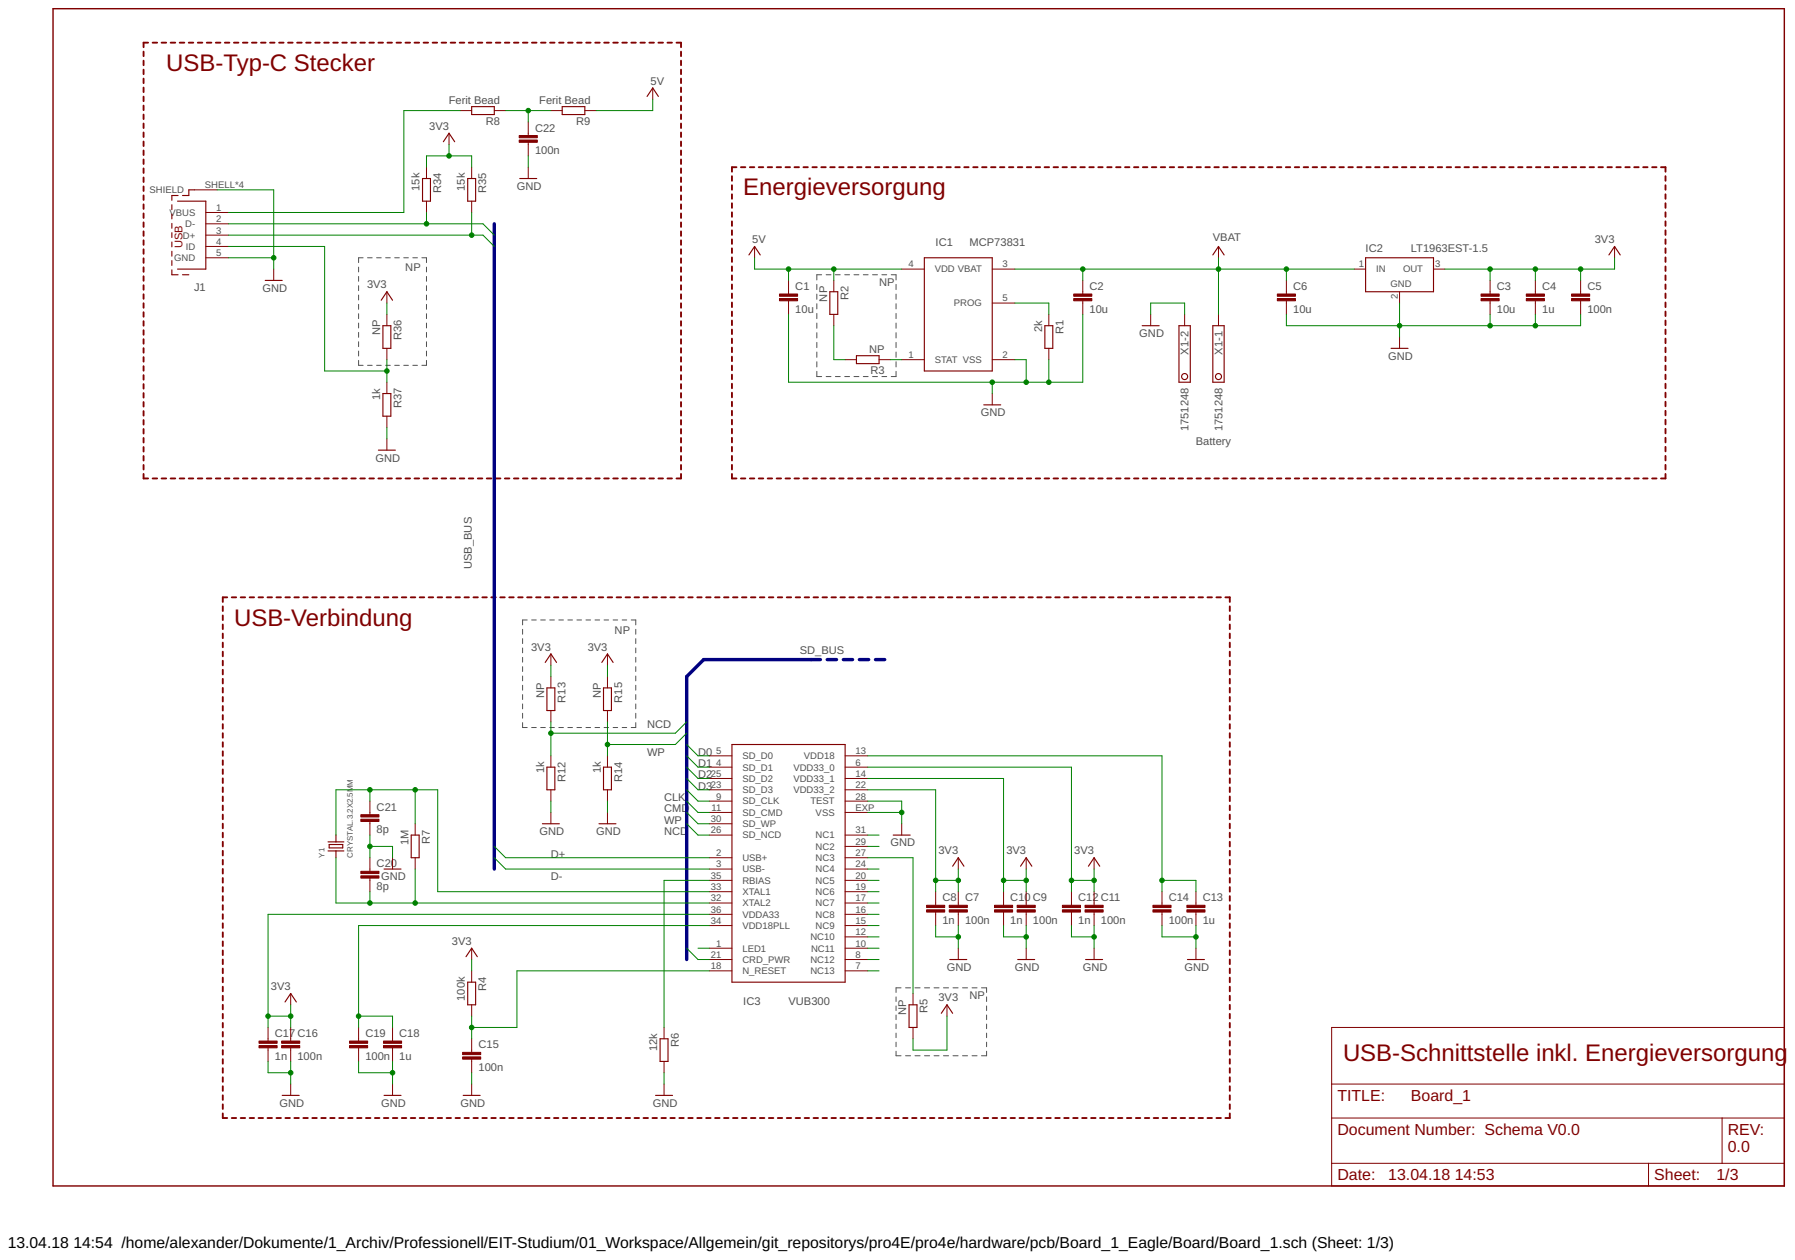
[picture p85: page 1]

USB-Schnittstelle inkl. Energieversorgung

Document Number: Schema V0.0 | REV: 0.0

Date: 13.04.18 14:53 | Sheet: 1/3

13.04.18 14:54 /home/alexander/Dokumente/1_Archiv/Professionell/EIT-Studium/01_Workspace/Allgemein/git_repositorys/pro4E/pro4e/hardware/pcb/Board_1_Eagle/Board/Board_1.sch (Sheet: 1/3)

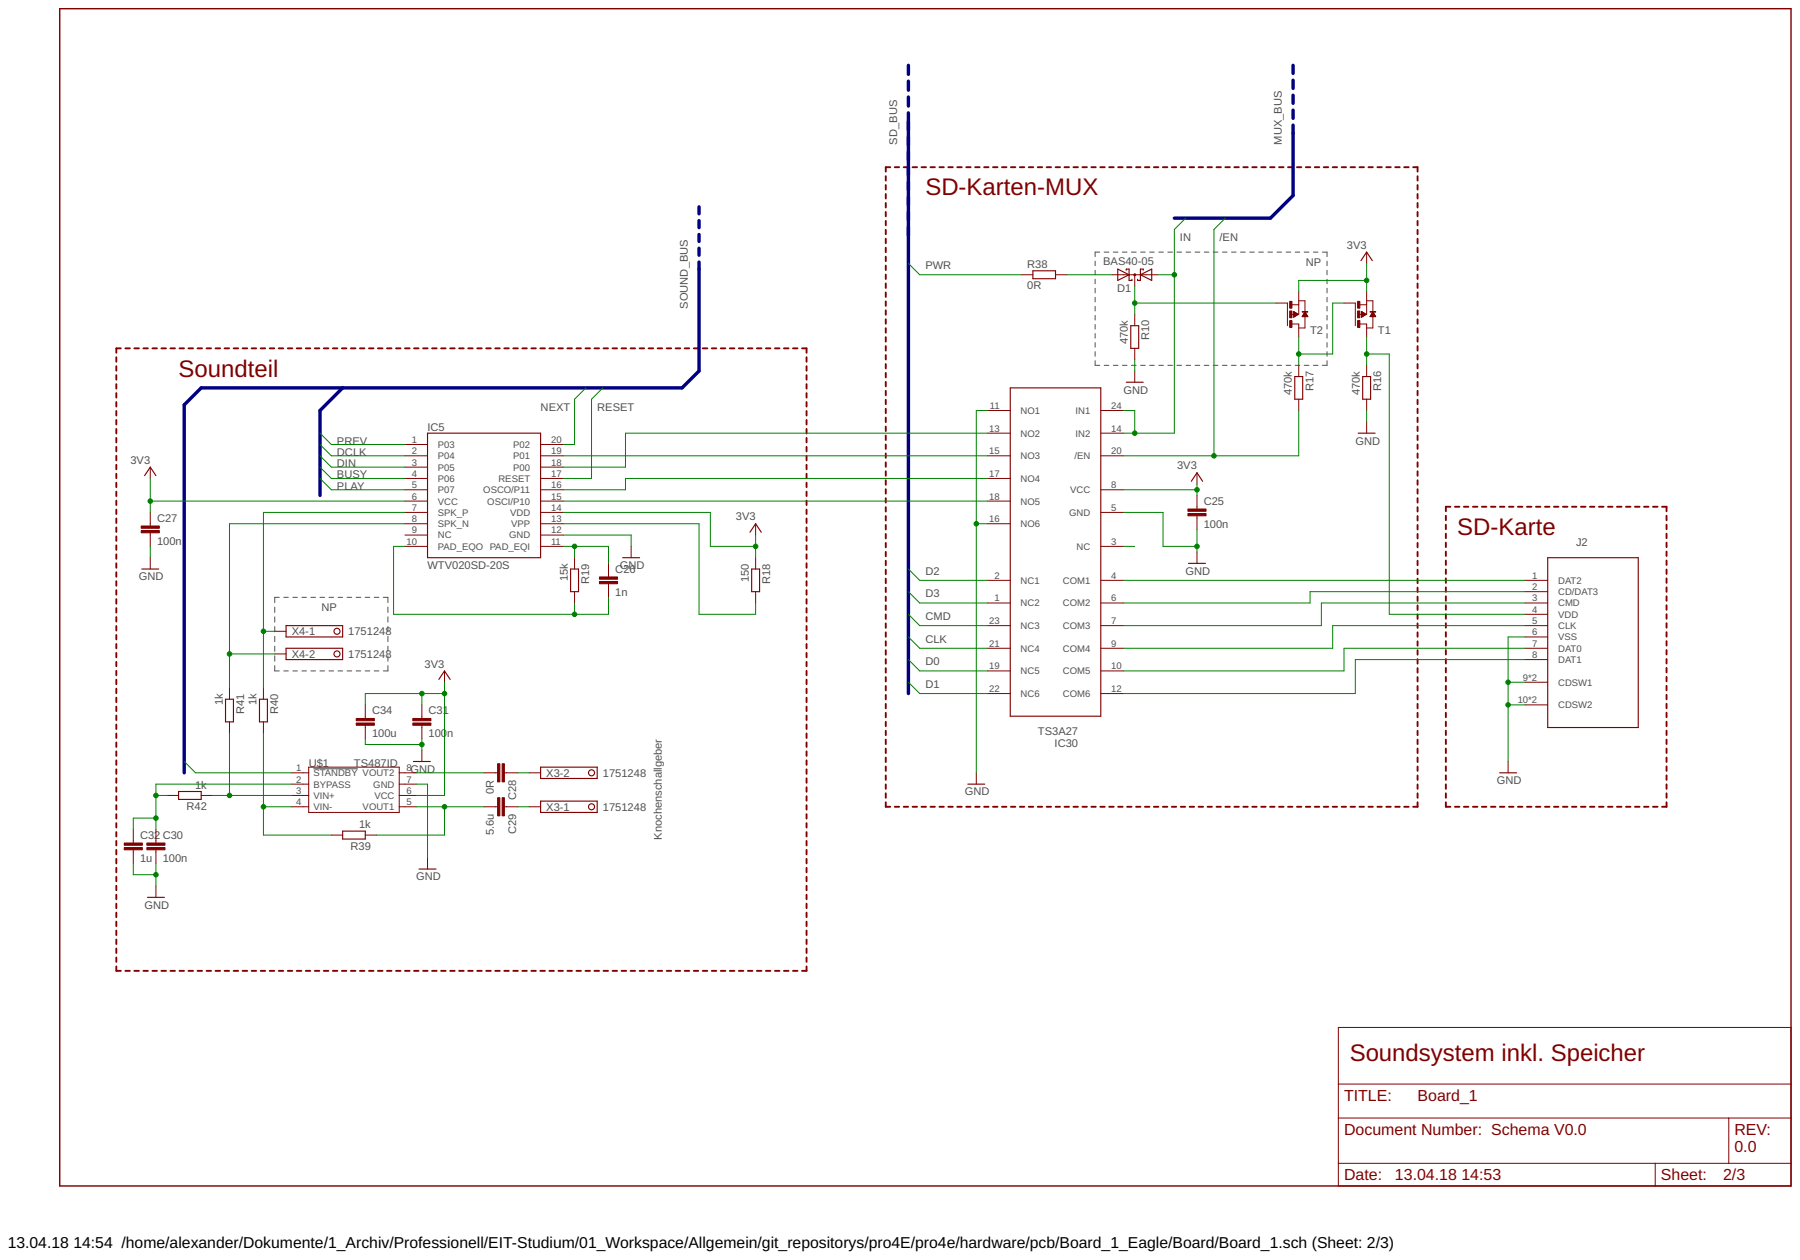
[picture p86: page 2]

13.04.18 14:54 /home/alexander/Dokumente/1_Archiv/Professionell/EIT-Studium/01_Workspace/Allgemein/git_repositorys/pro4E/pro4e/hardware/pcb/Board_1_Eagle/Board/Board_1.sch (Sheet: 2/3)

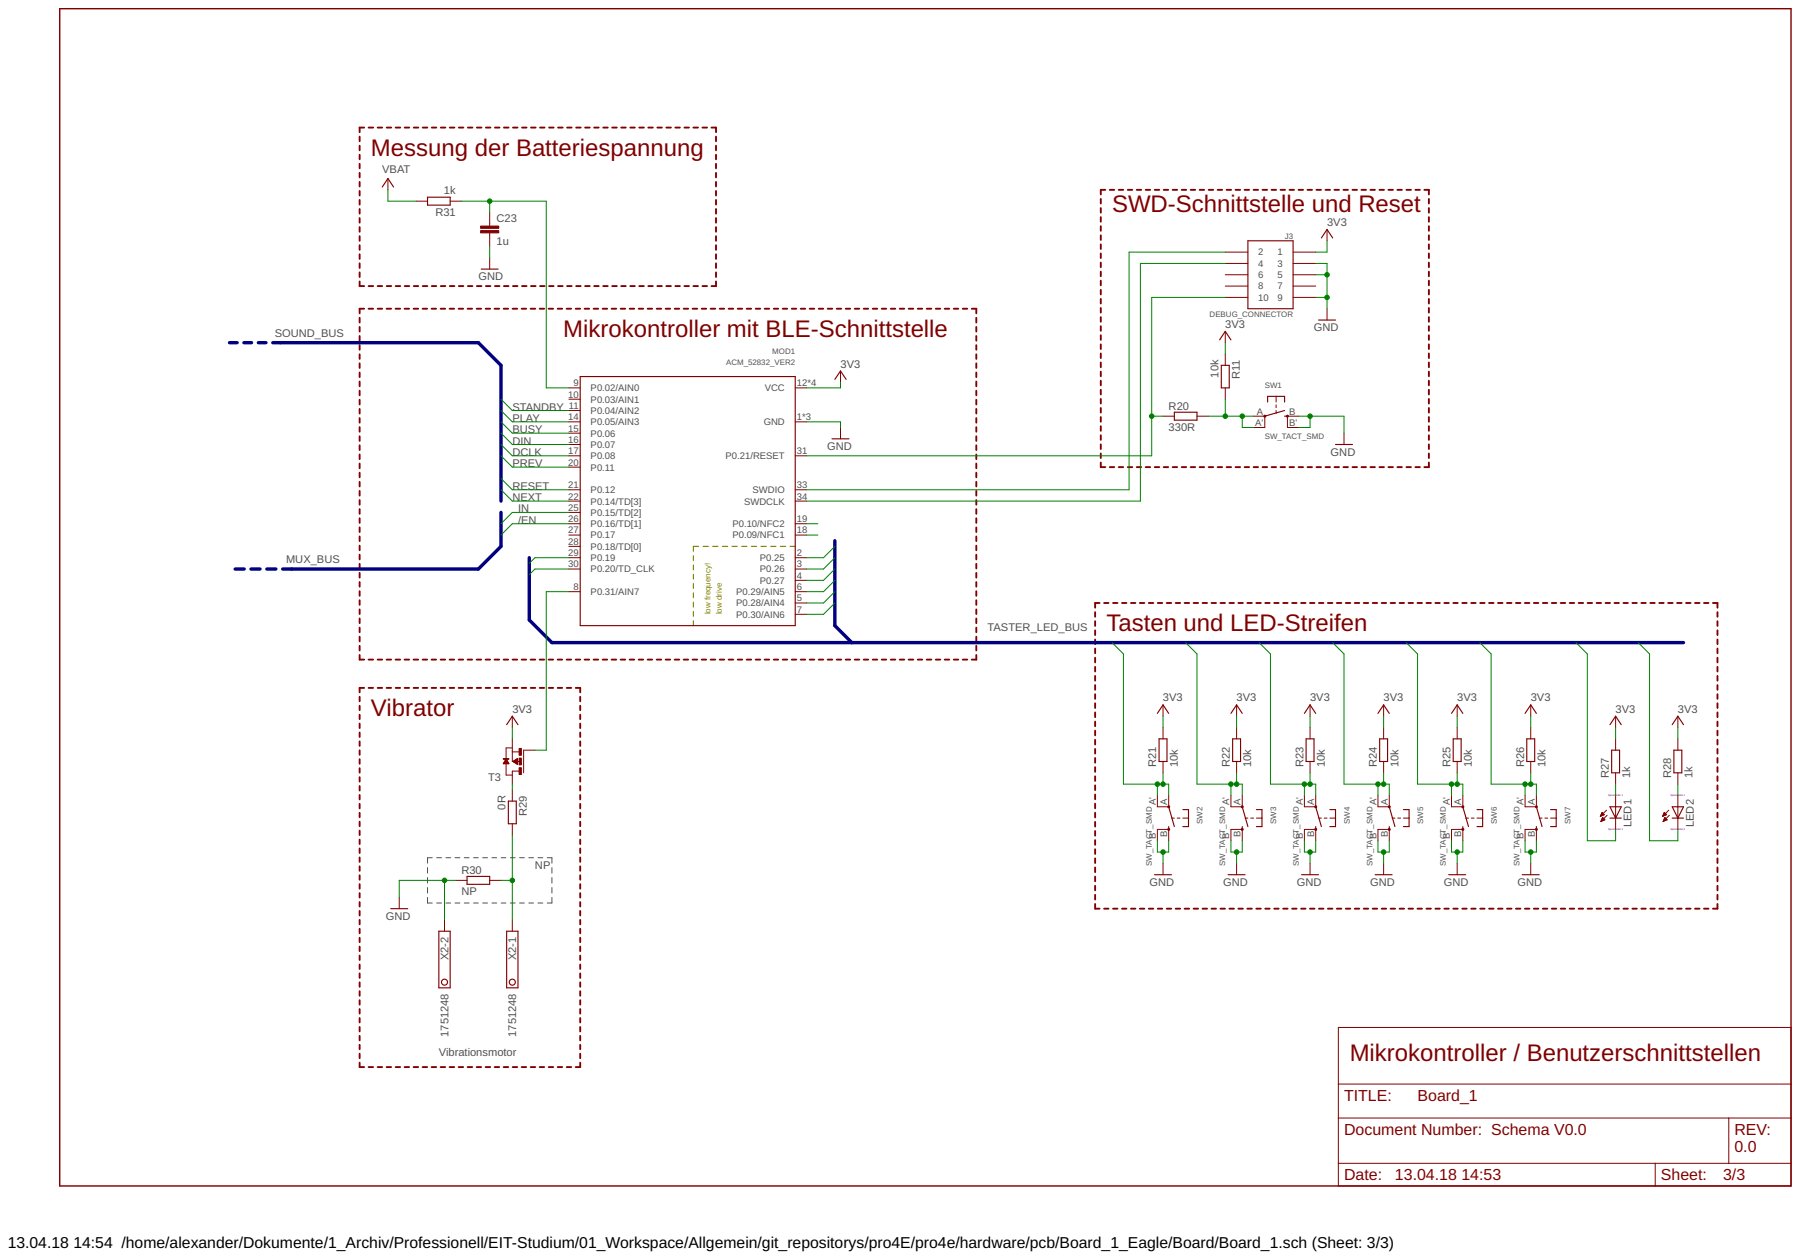
[picture p87: page 3]

SWD-Schnittstelle und Reset

Mikrokontroller mit BLE-Schnittstelle

Tasten und LED-Streifen

13.04.18 14:54 /home/alexander/Dokumente/1_Archiv/Professionell/EIT-Studium/01_Workspace/Allgemein/git_repositorys/pro4E/pro4e/hardware/pcb/Board_1_Eagle/Board/Board_1.sch (Sheet: 3/3)
