romansonder/pro4e/documentation/03_technical_report/graphics/Aufbau1.pdf

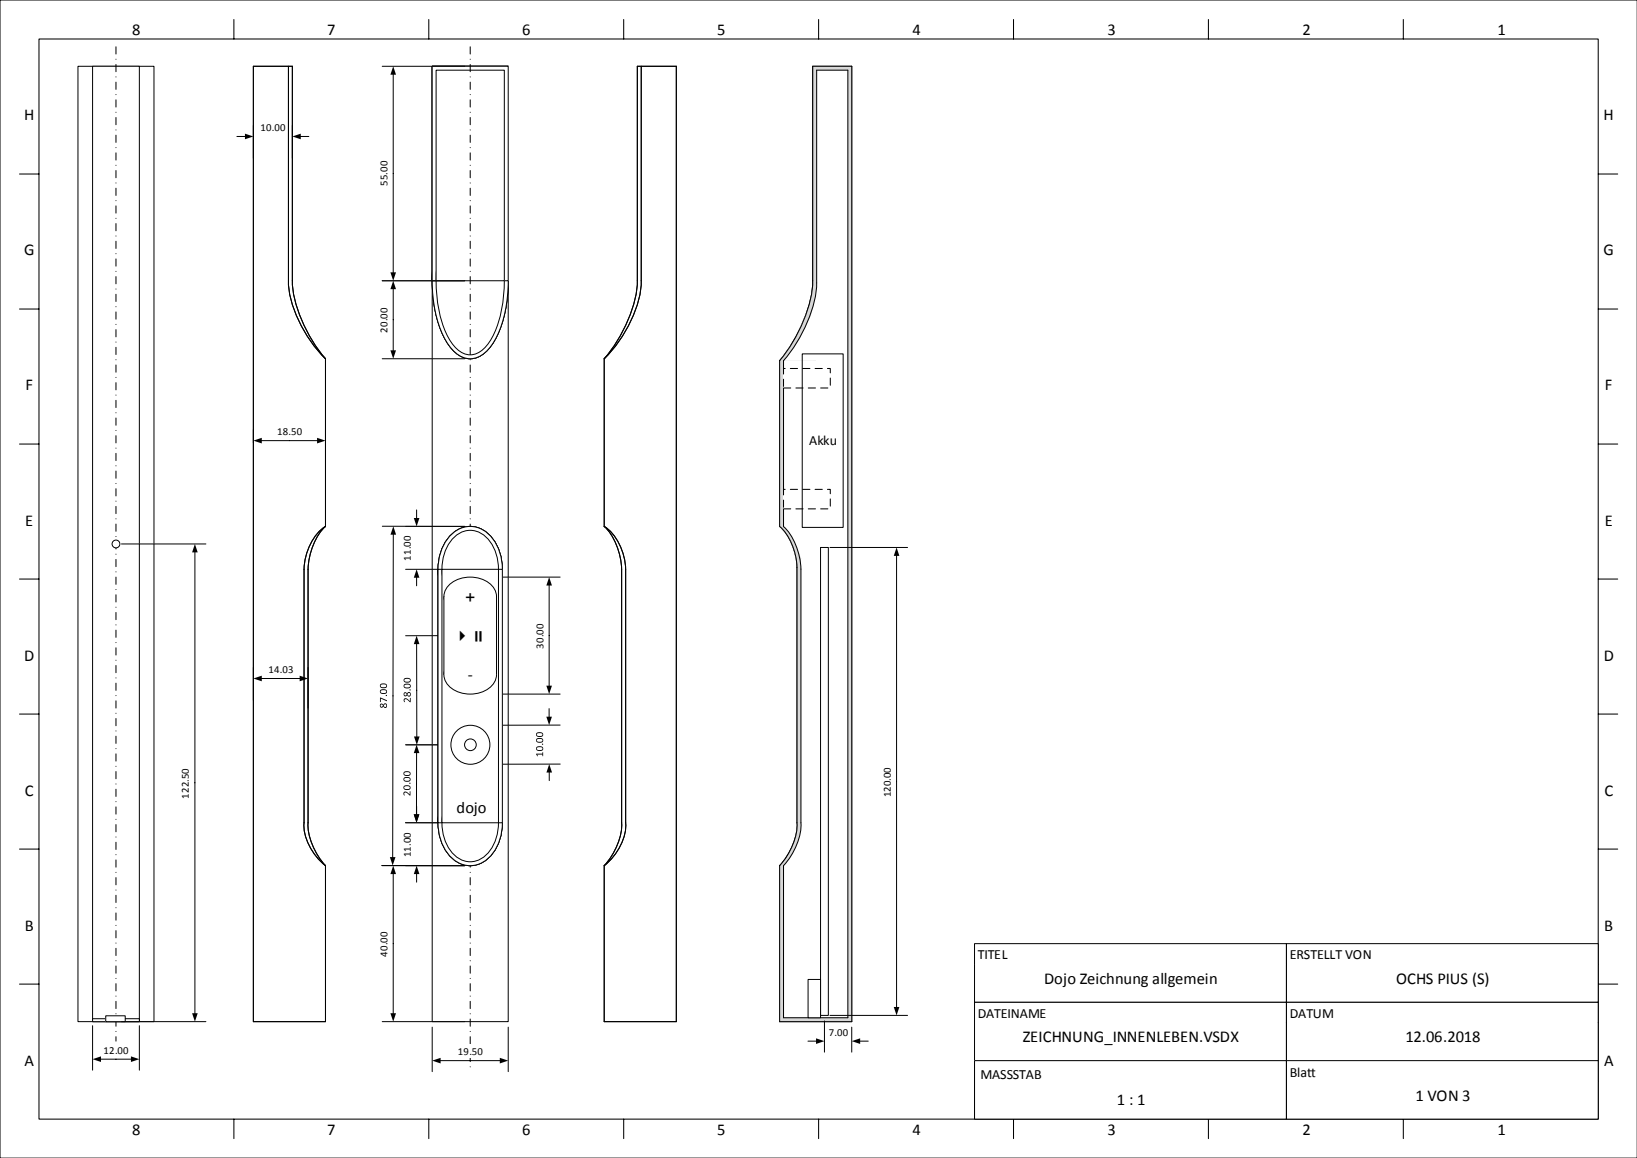
[picture p88: page 1]
DATUM; DATEINAME ZEICHNUNG_INNENLEBEN.VSDX; ERSTELLT VON; OCHS PIUS (S); Blatt; TITEL; MASSSTAB; 19.50 ¹²².50; dojo; Akku

Dojo Zeichnung allgemein
