romansonder/pro4e/documentation/03_technical_report/graphics/Aufbau3.pdf

## Querschnitt Akku

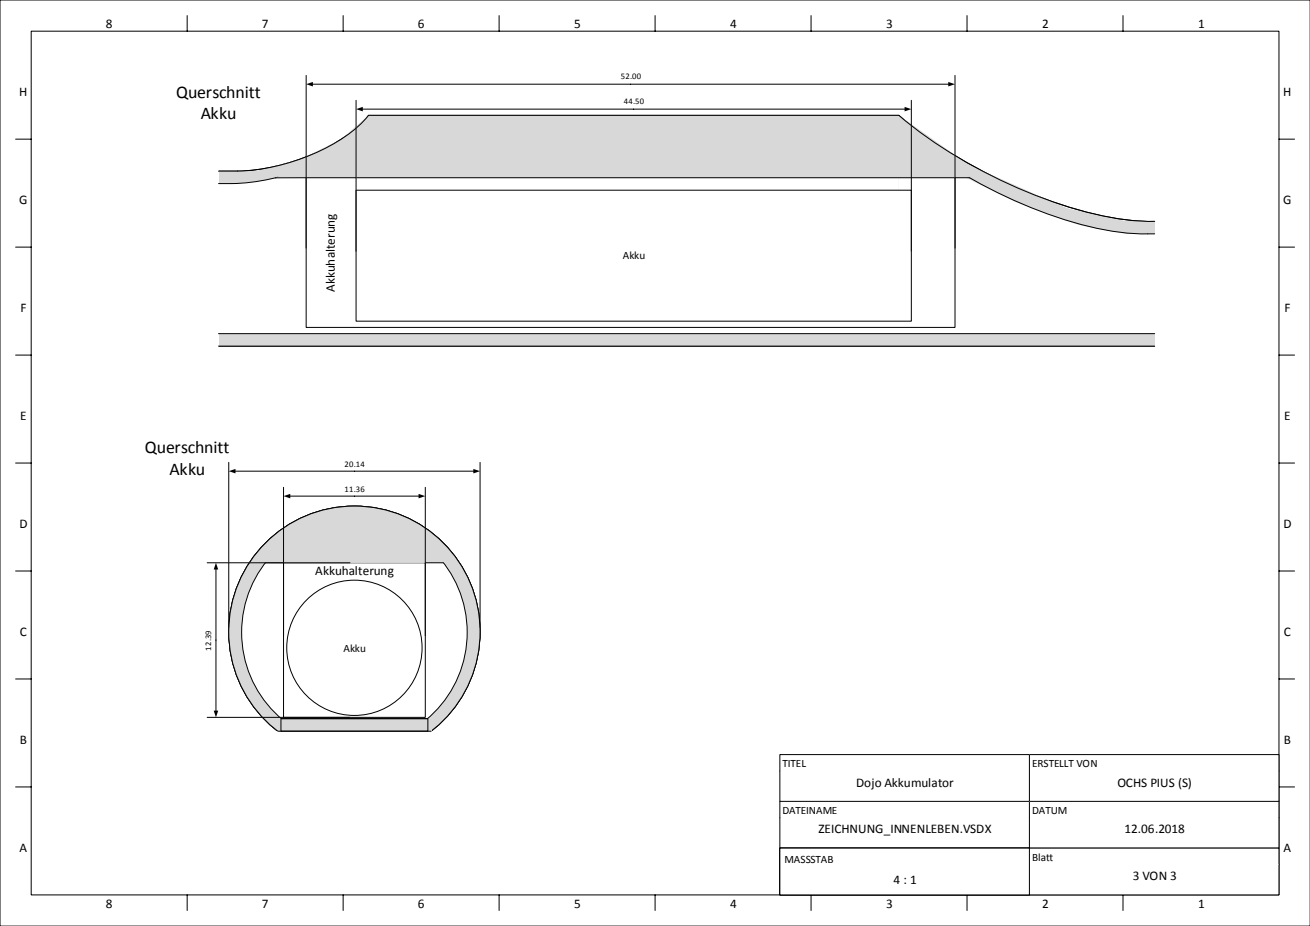
[picture p89: page 1]
DATUM; DATEINAME ZEICHNUNG_INNENLEBEN.VSDX; ERSTELLT VON; OCHS PIUS (S); Blatt; TITEL; Dojo Akkumulator; MASSSTAB; Akku; Akkuhalterung; Querschnitt
