romansonder/pro4e/documentation/03_technical_report/graphics/Board_22.pdf

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

Document Number: Schema V0.0 | REV: 0.0

Date: 07.06.18 08:55 | Sheet: 2/3
