romansonder/pro4e/documentation/03_technical_report/graphics/dojo_layers1.pdf

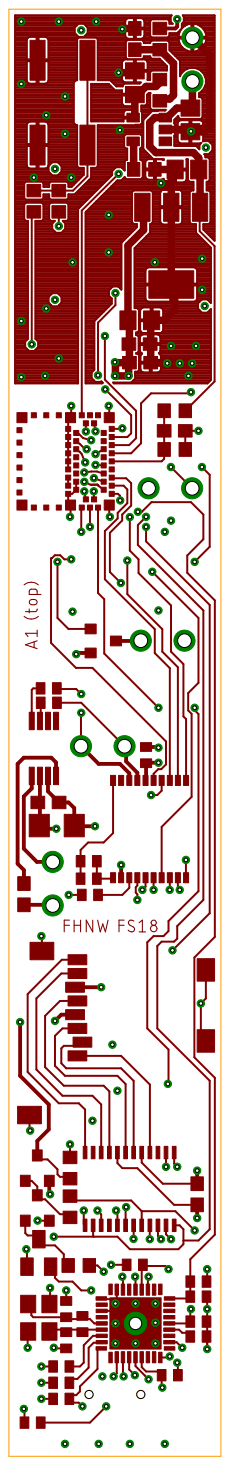
[picture p90: page 1]
