romansonder/pro4e/documentation/03_technical_report/graphics/dojo_layers2.pdf

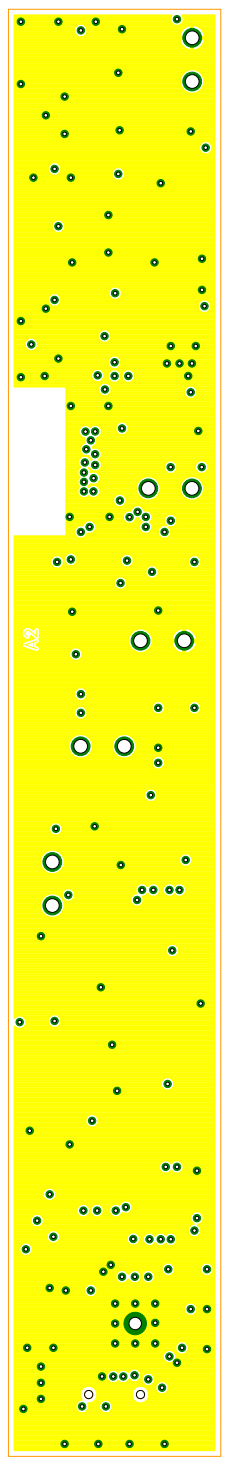
[picture p91: page 1]
