romansonder/pro4e/documentation/03_technical_report/graphics/dojo_layers3.pdf

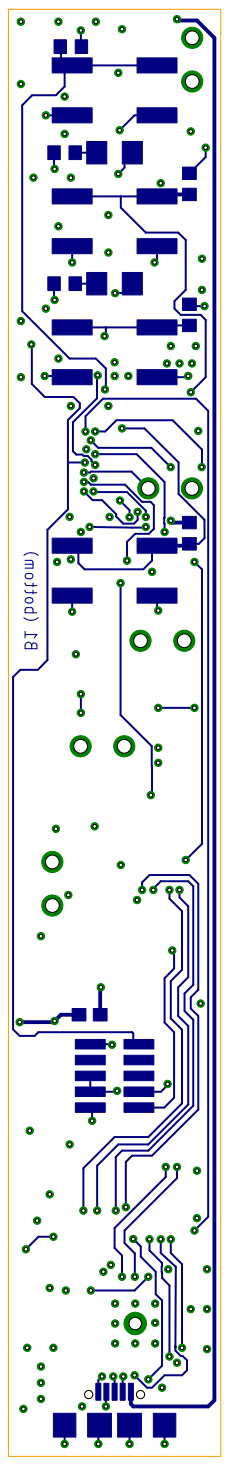
[picture p92: page 1]
