romansonder/pro4e/documentation/03_technical_report/graphics/dojo_layers4.pdf

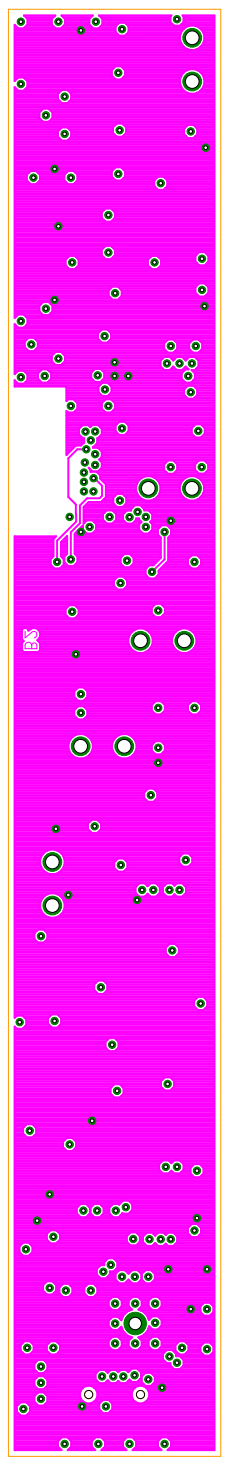
[picture p93: page 1]
