romansonder/pro4e/documentation/03_technical_report/graphics/dojo_layers5.pdf

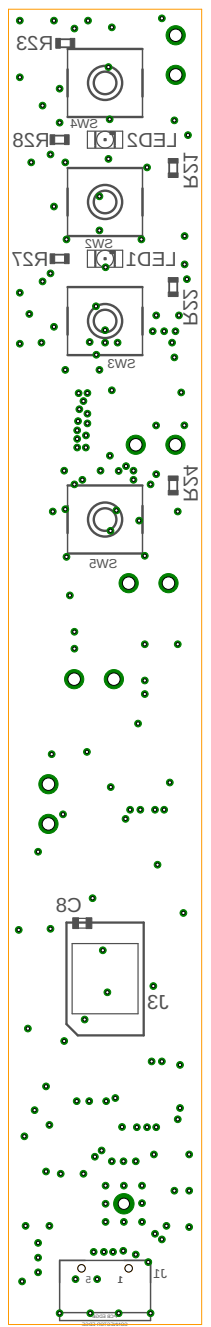
[picture p94: page 1]
