romansonder/pro4e/documentation/03_technical_report/graphics/Board_1_A1.pdf

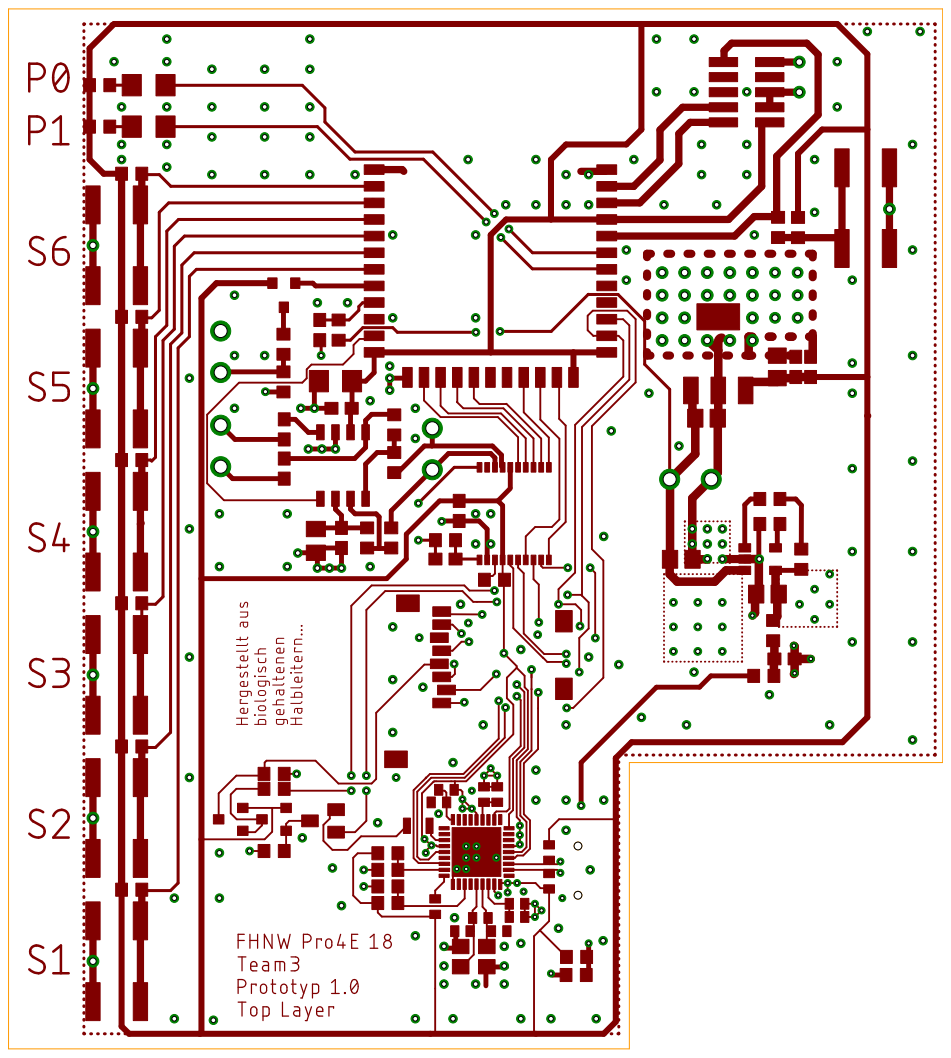
[picture p95: page 1]
