romansonder/pro4e/documentation/03_technical_report/graphics/Board_1_B1.pdf

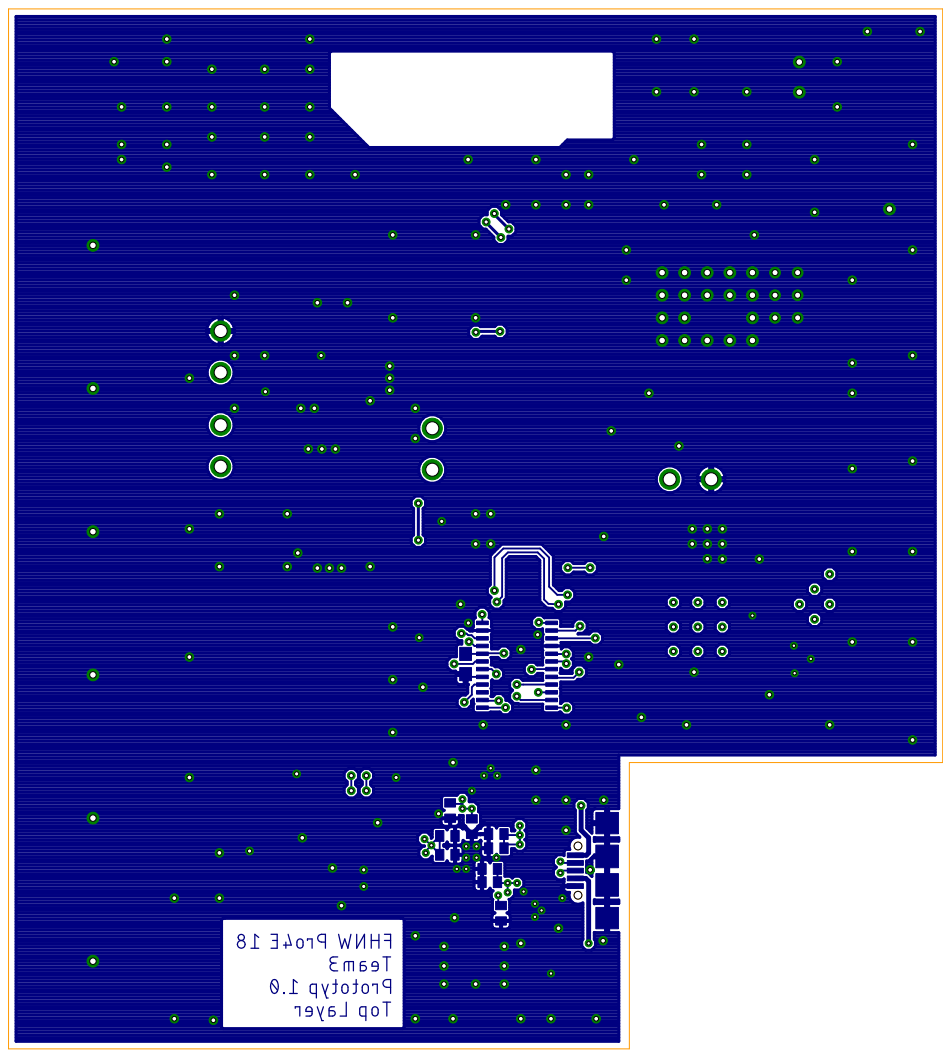
[picture p96: page 1]
