romansonder/pro4e/documentation/03_technical_report/graphics/Board_1_Best_top.pdf

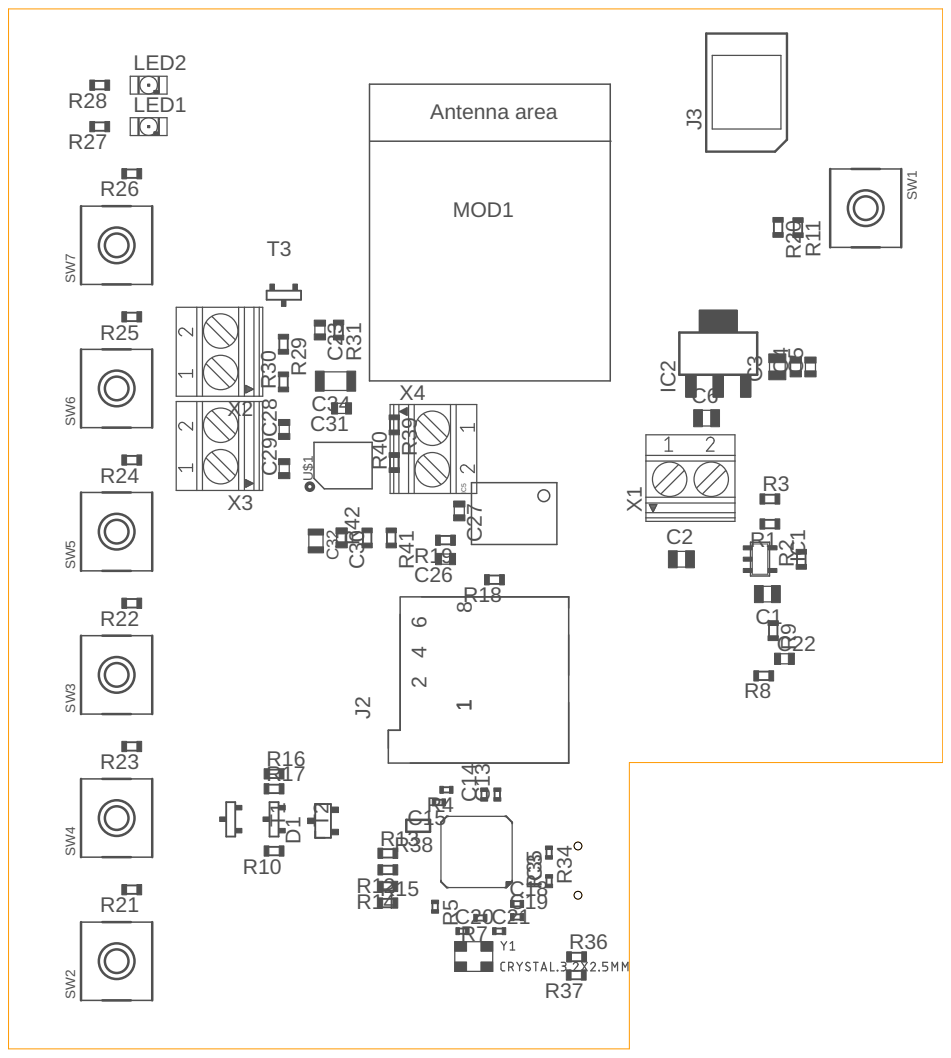
[picture p97: page 1]
