romansonder/pro4e/documentation/01_product_specification_organizational/graphics/Projektplan_pro4E_Team3.pdf

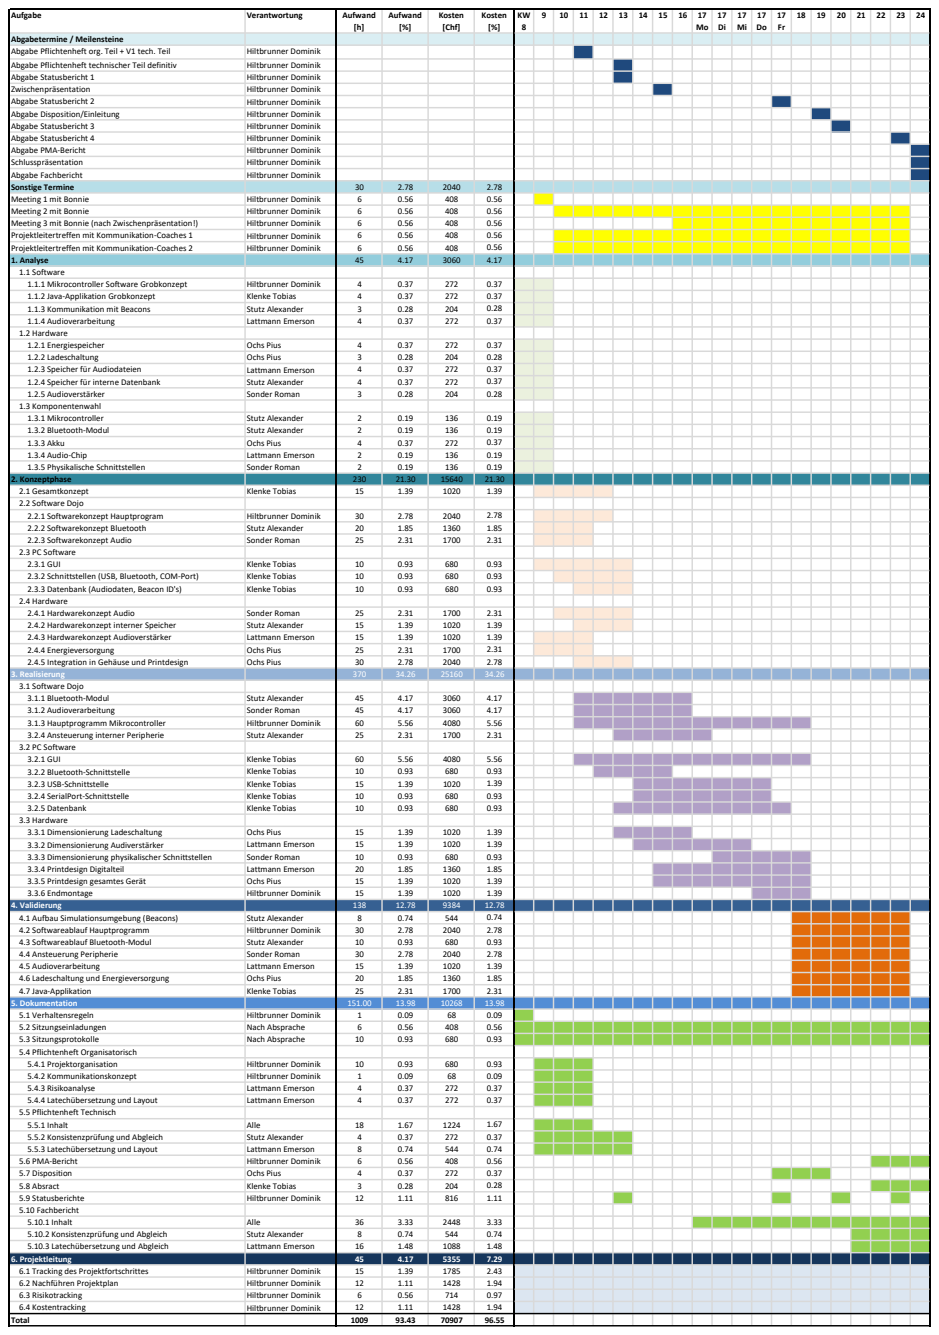
[picture p98: page 1]
Aufgabe; Verantwortung; Aufwand; Aufwand [%]; Kosten [Chf]; Kosten [%]; Abgabetermine / Meilensteine; Abgabe Pflichtenheft org. Teil + V1 tech. Teil; Hiltbrunner Dominik; Abgabe Pflichtenheft technischer Teil definitiv; Abgabe Statusbericht 1; Zwischenpräsentation; Abgabe Statusbericht 2; Abgabe Disposition/Einleitung; Abgabe Statusbericht 3; Abgabe Statusbericht 4; Abgabe PMA-Bericht; Schlusspräsentation; Abgabe Fachbericht; Sonstige Termine; Meeting 1 mit Bonnie; Meeting 2 mit Bonnie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
