romansonder/pro4e/hardware/pcb/Board_2_Eagle/Board_2.brd

## EAGLE design hardware/pcb/Board_2_Eagle/Board_2.brd (2018-06-09)

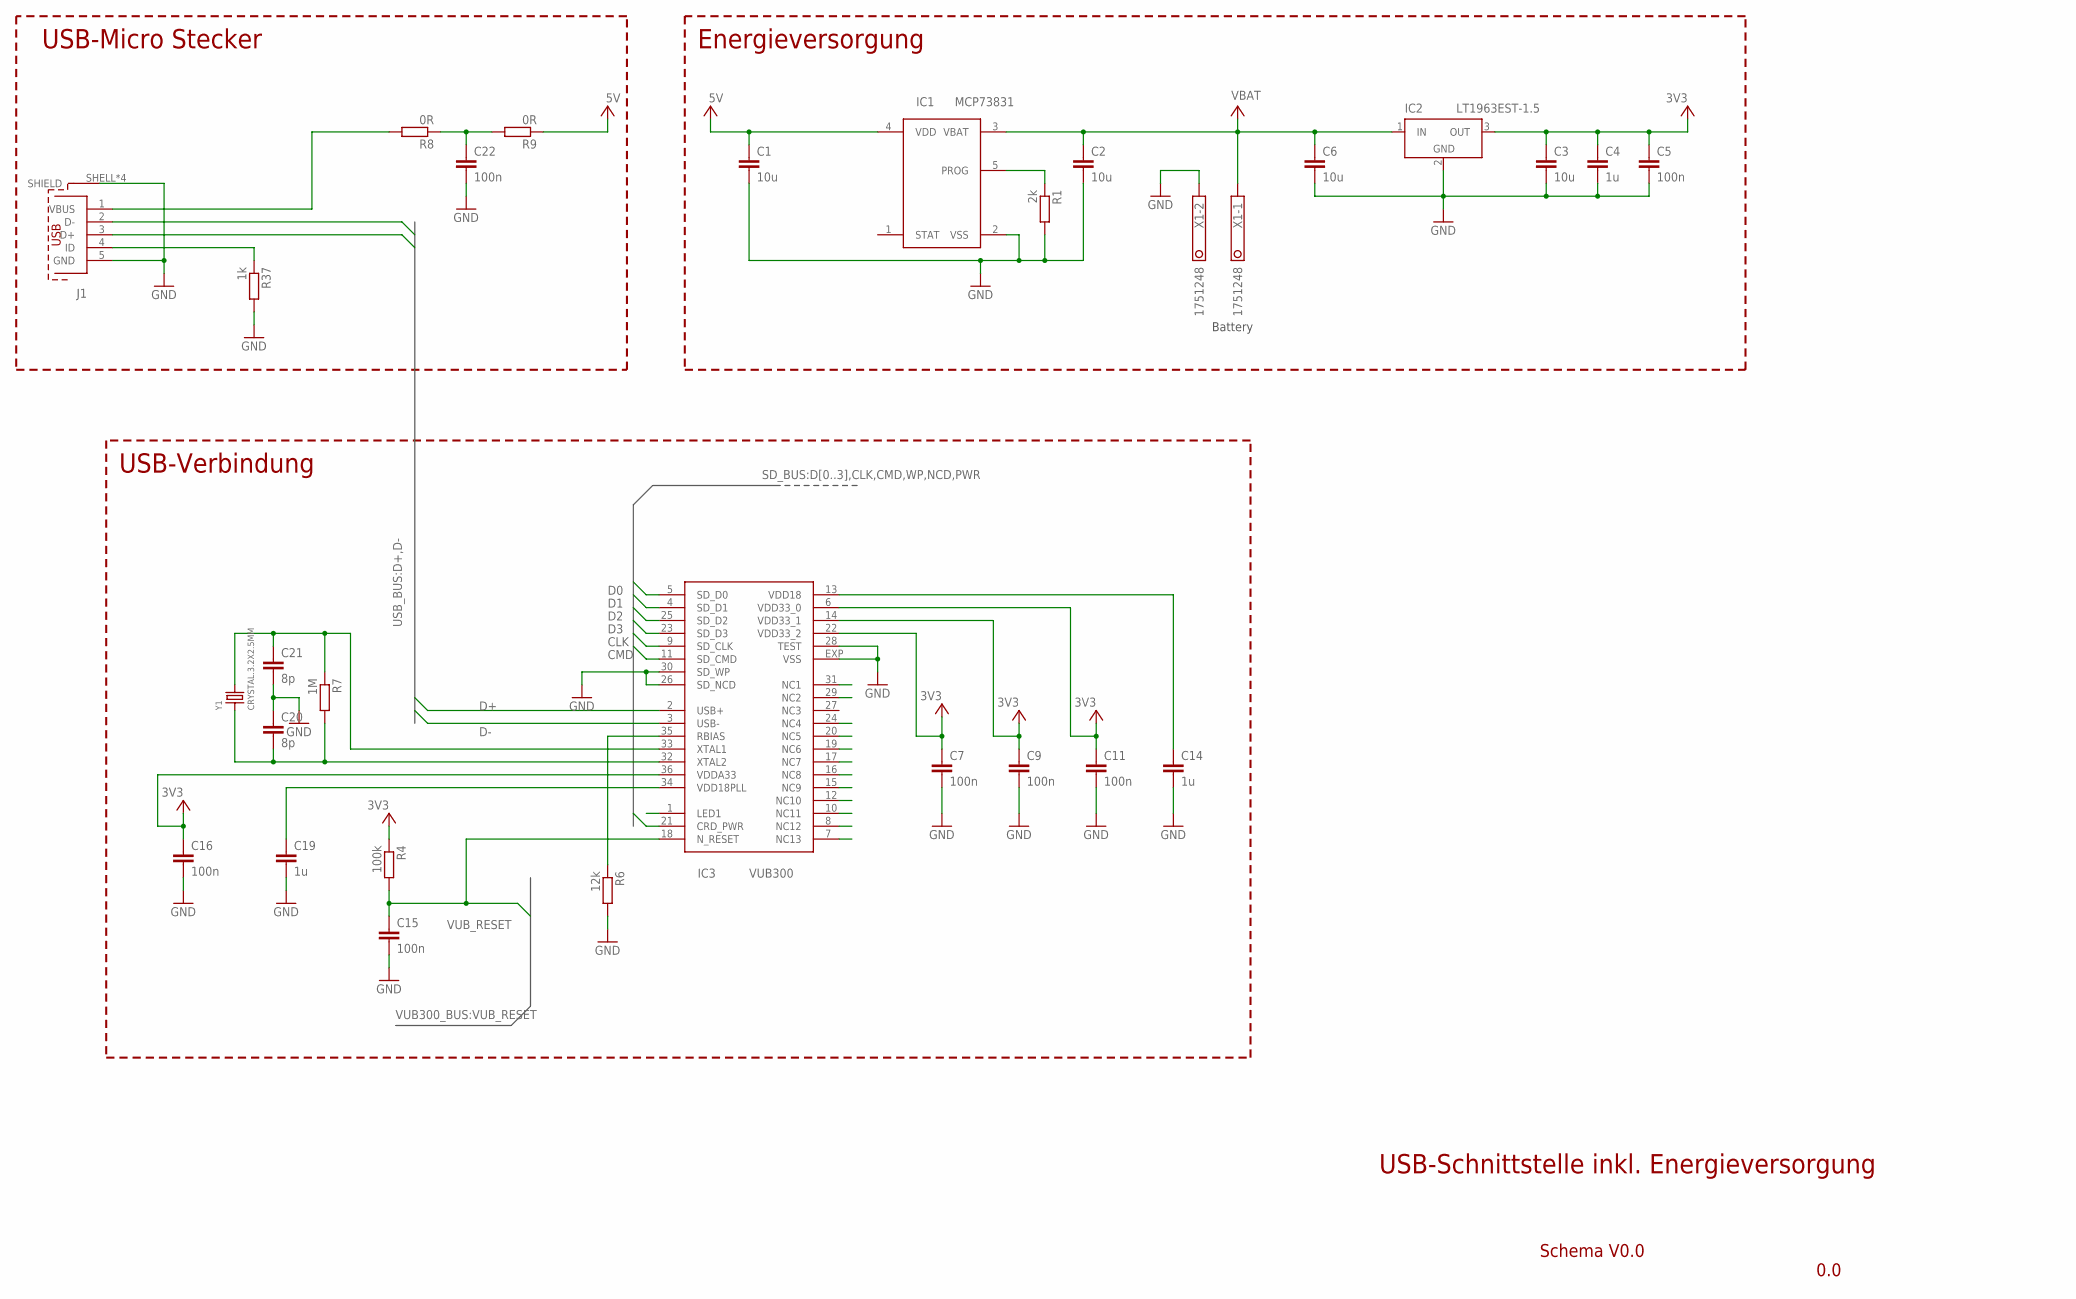
[picture p99: schematic Board_2.sch, sheet 1]

Parts:
C1, C2, C3, C6: 10u; C0805
C4: 1u; C0603
C5, C22: 100n; C0603
C7, C9, C11, C15, C16: 100n; C0402
C14, C19: 1u; C0402
C20, C21: 8p; C0402
IC1: MCP73831; SOT23-5
IC2: LT1963EST-1.5; SOT223
IC3: VUB300; QFN36-6X6
J1: 629105136821
R1: 2k; R0603
R4: 100k; R0402
R6: 12k; R0402
R7: 1M; R0402
R8, R9: 0R; R0603
R37: 1k; R0402
X1: 1751248
Y1: CRYSTAL.3.2X2.5MM; 3.2X2.5MM

Connections:
+3V3: C3.1, C4.1, C5.1, C7.1, C9.1, C11.1, C16.1, IC2.3 (OUT), IC3.6 (VDD33_0), IC3.14 (VDD33_1), IC3.22 (VDD33_2), IC3.36 (VDDA33), R4.1; also elsewhere on the board
+5V: C1.1, IC1.4 (VDD), R9.1
CLK: IC3.9 (SD_CLK); also elsewhere on the board
CMD: IC3.11 (SD_CMD); also elsewhere on the board
D0: IC3.5 (SD_D0); also elsewhere on the board
D1: IC3.4 (SD_D1); also elsewhere on the board
D2: IC3.25 (SD_D2); also elsewhere on the board
D3: IC3.23 (SD_D3); also elsewhere on the board
D+: IC3.2 (USB+), J1.3 (D+)
D-: IC3.3 (USB-), J1.2 (D-)
GND: C1.2, C2.2, C3.2, C4.2, C5.2, C6.2, C7.2, C9.2, C11.2, C14.2, C15.2, C16.2, C19.2, C20.1, C21.2, C22.2, IC1.2 (VSS), IC2.2 (GND), IC2.4 (GND), IC3.26 (SD_NCD), IC3.28 (TEST), IC3.30 (SD_WP), IC3.EXP (VSS), J1.5 (GND), J1.SHELL (SHIELD), J1.SHELL1 (SHIELD), J1.SHELL2 (SHIELD), J1.SHELL3 (SHIELD), R1.2, R6.2, R37.2, X1.2; also elsewhere on the board
unnamed: IC1.5 (PROG), R1.1
unnamed: J1.4 (ID), R37.1
unnamed: IC3.35 (RBIAS), R6.1
unnamed: J1.1 (VBUS), R8.2
unnamed: C20.2, IC3.32 (XTAL2), R7.2, Y1.1
unnamed: C21.1, IC3.33 (XTAL1), R7.1, Y1.3 (2)
unnamed: C22.1, R8.1, R9.2
PWR: IC3.21 (CRD_PWR); also elsewhere on the board
V+: C2.1, C6.1, IC1.3 (VBAT), IC2.1 (IN), X1.1; also elsewhere on the board
VDD18: C14.1, IC3.13 (VDD18)
VDD18PLL: C19.1, IC3.34 (VDD18PLL)
VUB_RESET: C15.1, IC3.18 (N_RESET), R4.2; also elsewhere on the board

Notes on the sheet:
Battery
USB-Micro Stecker
Energieversorgung
USB-Verbindung
Schema V0.0
0.0
USB-Schnittstelle inkl. Energieversorgung

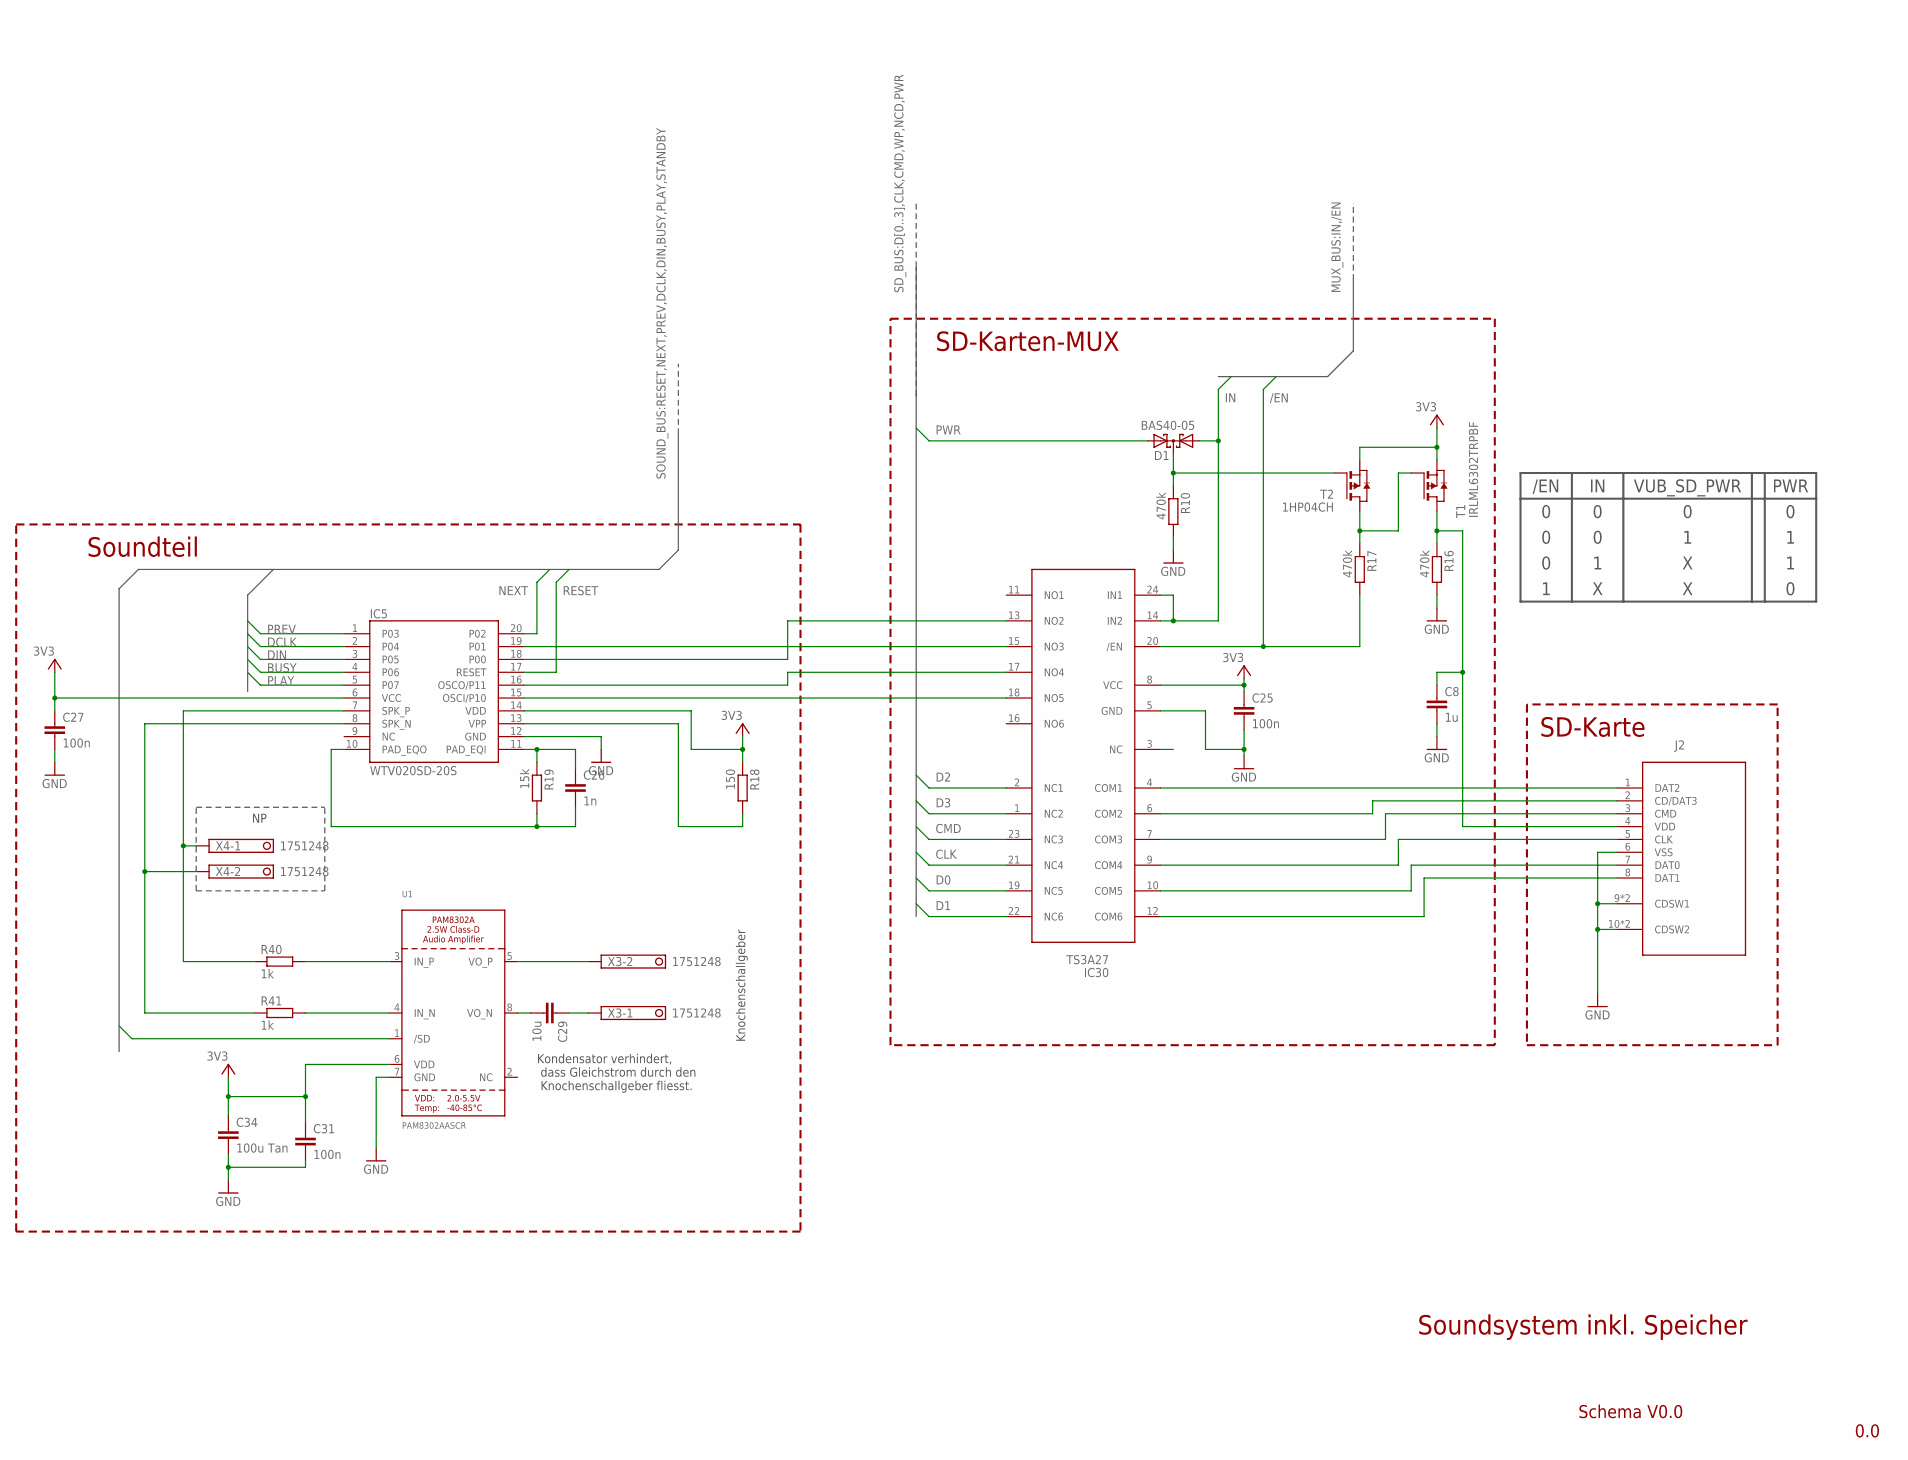
[picture p100: schematic Board_2.sch, sheet 2]

Parts:
C8: 1u; C0603
C25, C31: 100n; C0603
C26: 1n; C0402
C27: 100n; C0402
C29: 10u; C0603
C34: 100u Tan; C1206
D1: BAS40-05; SOT23
IC5: WTV020SD-20S; SSOP_20
IC30: TS3A27; TSSOP24
J2: 693071010811
R10, R16, R17: 470k; R0603
R18: 150; R0402
R19: 15k; R0402
R40, R41: 1k; R0402
T1: IRLML6302TRPBF; SOT-23
T2: 1HP04CH; SOT-23
U1: PAM8302AASCR; MSOP8_0.65MM
X3, X4: 1751248

Connections:
+3V3: C25.1, C27.1, C31.1, C34.1, IC5.6 (VCC), IC5.14 (VDD), IC30.8 (VCC), R18.1, T1.2 (S), T2.2 (S), U1.6 (VDD); also elsewhere on the board
/EN: IC30.20 (/EN), R17.2; also elsewhere on the board
BUSY: IC5.4 (P06); also elsewhere on the board
CLK: IC30.21 (NC4); also elsewhere on the board
CMD: IC30.23 (NC3); also elsewhere on the board
D0: IC30.19 (NC5); also elsewhere on the board
D1: IC30.22 (NC6); also elsewhere on the board
D2: IC30.2 (NC1); also elsewhere on the board
D3: IC30.1 (NC2); also elsewhere on the board
DCLK: IC5.2 (P04); also elsewhere on the board
DIN: IC5.3 (P05); also elsewhere on the board
GND: C8.2, C25.2, C27.2, C31.2, C34.2, IC5.12 (GND), IC30.5 (GND), J2.6 (VSS), J2.9 (CDSW1), J2.9-1 (CDSW1), J2.10 (CDSW2), J2.10-1 (CDSW2), R10.2, R16.2, U1.7 (GND); also elsewhere on the board
IN: D1.1 (A1), IC30.14 (IN2), IC30.24 (IN1); also elsewhere on the board
unnamed: R41.2, U1.4 (IN_N)
unnamed: IC5.19 (P01), IC30.15 (NO3)
unnamed: R40.2, U1.3 (IN_P)
unnamed: U1.5 (VO_P), X3.2
unnamed: C29.1, X3.1
unnamed: C29.2, U1.8 (VO_N)
unnamed: IC30.9 (COM4), J2.5 (CLK)
unnamed: IC5.13 (VPP), R18.2
unnamed: C26.1, IC5.11 (PAD_EQI), R19.1
unnamed: IC5.16 (OSCO/P11), IC30.17 (NO4)
unnamed: IC5.15 (OSCI/P10), IC30.18 (NO5)
unnamed: IC30.4 (COM1), J2.1 (DAT2)
unnamed: IC30.12 (COM6), J2.8 (DAT1)
unnamed: IC30.6 (COM2), J2.2 (CD/DAT3)
unnamed: R17.1, T1.3 (G), T2.1 (D)
unnamed: D1.3 (C), R10.1, T2.3 (G)
NCD1: C8.1, J2.4 (VDD), R16.1, T1.1 (D)
NEXT: IC5.20 (P02); also elsewhere on the board
PLAY: IC5.5 (P07); also elsewhere on the board
PREV: IC5.1 (P03); also elsewhere on the board
PWM: C26.2, IC5.10 (PAD_EQO), R19.2
PWR: D1.2 (A2); also elsewhere on the board
RESET: IC5.17 (RESET); also elsewhere on the board
SDCS: IC5.18 (P00), IC30.13 (NO2)
SDDI: IC30.7 (COM3), J2.3 (CMD)
SDDO: IC30.10 (COM5), J2.7 (DAT0)
SPK+: IC5.7 (SPK_P), R40.1, X4.1
SPK-: IC5.8 (SPK_N), R41.1, X4.2

Notes on the sheet:
SD-Karten-MUX
SD-Karte
Soundteil
Schema V0.0
0.0
Soundsystem inkl. Speicher
Knochenschallgeber
VUB_SD_PWR
/EN
PWR
Kondensator verhindert, dass Gleichstrom durch den Knochenschallgeber fliesst.

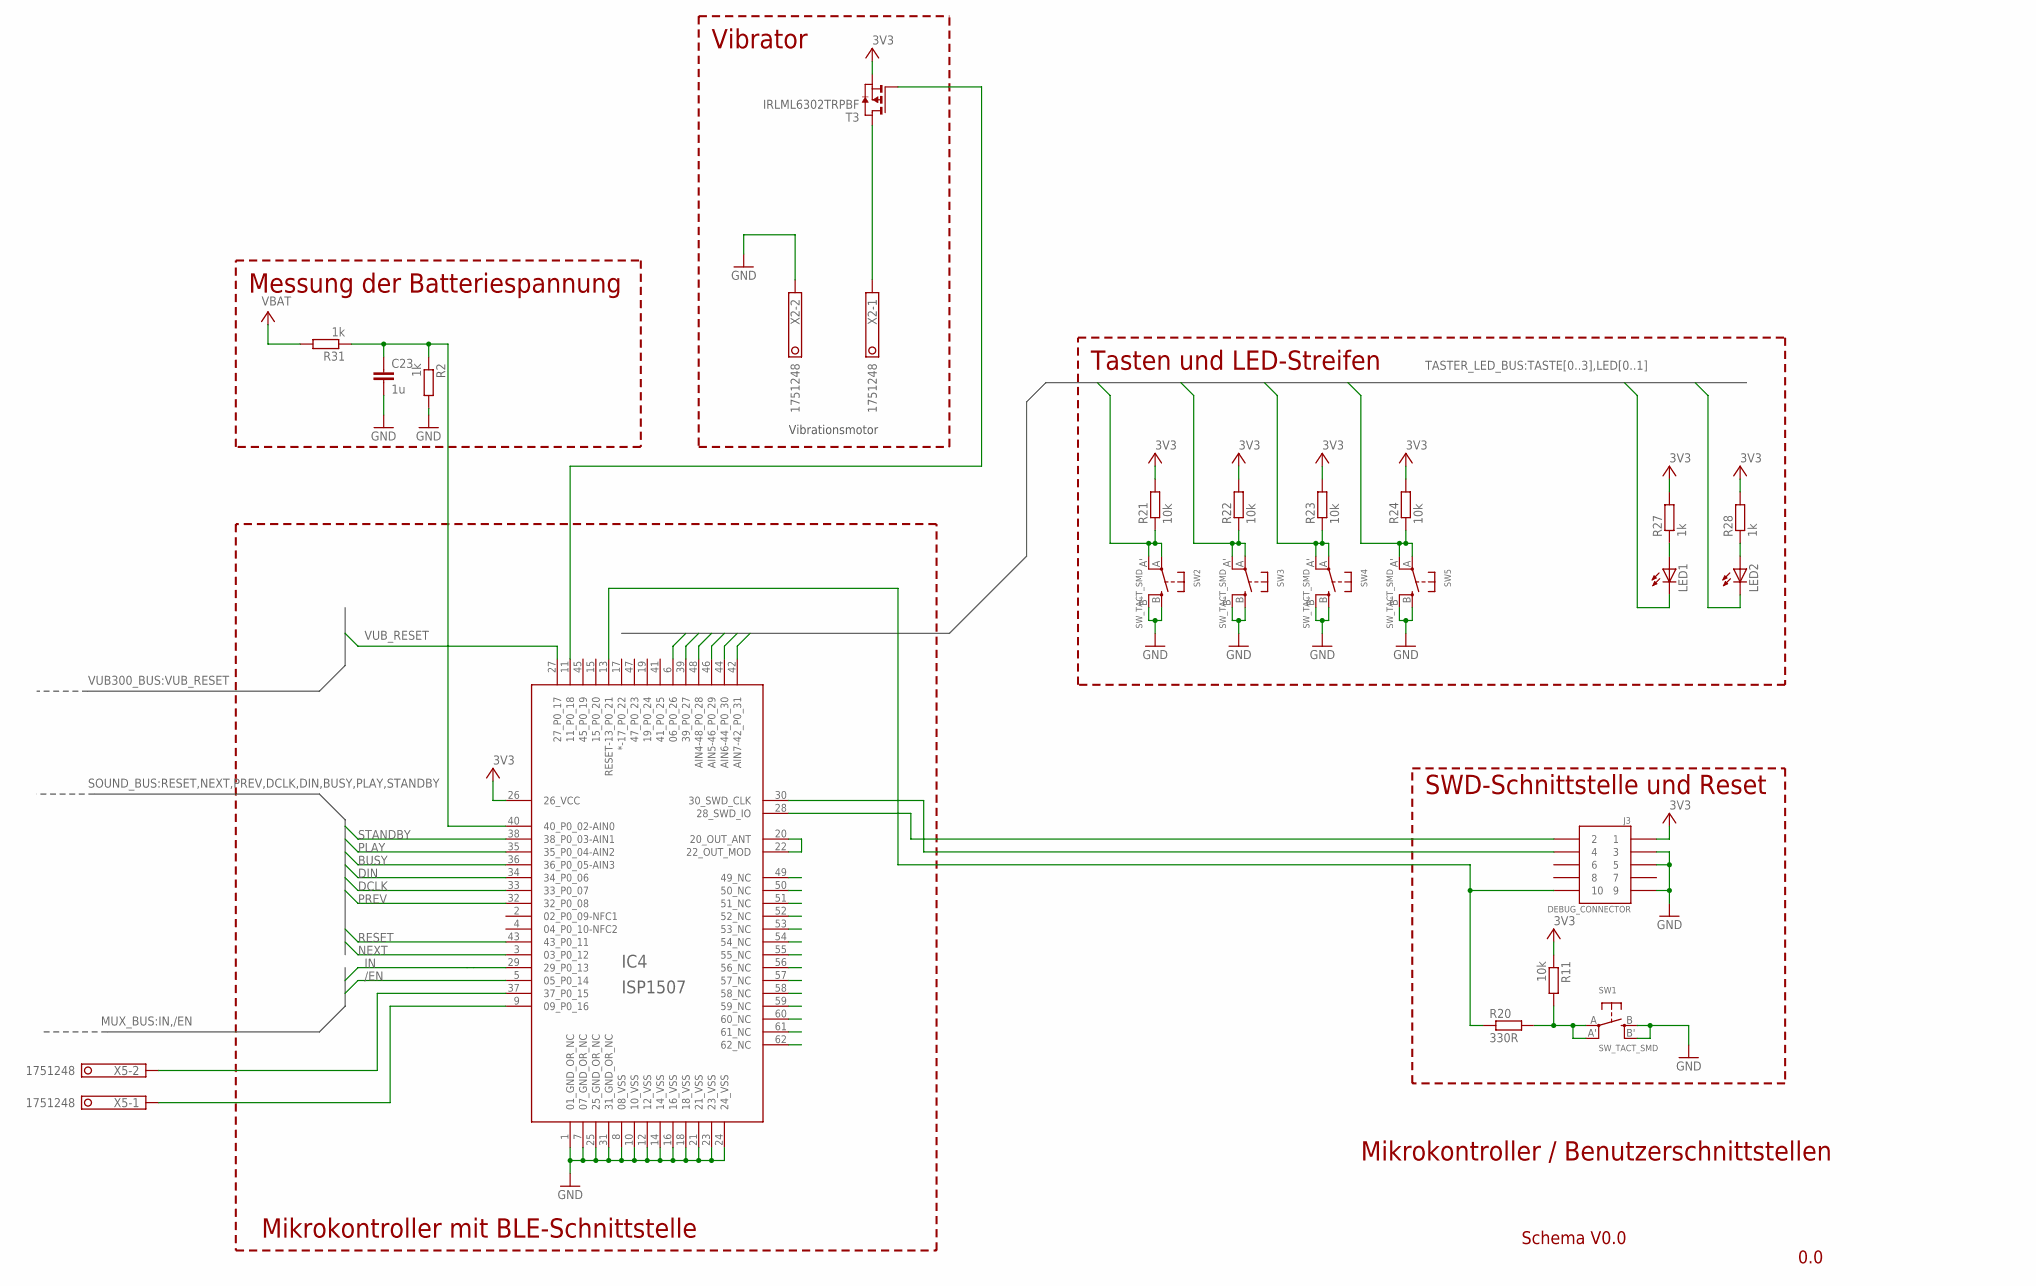
[picture p101: schematic Board_2.sch, sheet 3]

Parts:
C23: 1u; C0603
IC4: ISP1507
J3: DEBUG_CONNECTOR; HDRV127P5X2-10_N
LED1, LED2: LED_E; LED_1206
R2, R27, R28, R31: 1k; R0603
R11, R21, R22, R23, R24: 10k; R0603
R20: 330R; R0603
SW1, SW2, SW3, SW4, SW5: SW_TACT_SMD; EVQ-Q2
T3: IRLML6302TRPBF; SOT-23
X2, X5: 1751248

Connections:
+3V3: IC4.26 (26_VCC), J3.1, R11.1, R21.2, R22.2, R23.2, R24.2, R27.2, R28.2, T3.2 (S); also elsewhere on the board
/EN: IC4.5 (05_P0_14); also elsewhere on the board
BUSY: IC4.36 (36_P0_05-AIN3); also elsewhere on the board
DCLK: IC4.33 (33_P0_07); also elsewhere on the board
DIN: IC4.34 (34_P0_06); also elsewhere on the board
GND: C23.2, IC4.1 (01_GND_OR_NC), IC4.7 (07_GND_OR_NC), IC4.8 (08_VSS), IC4.10 (10_VSS), IC4.12 (12_VSS), IC4.14 (14_VSS), IC4.16 (16_VSS), IC4.18 (18_VSS), IC4.21 (21_VSS), IC4.23 (23_VSS), IC4.24 (24_VSS), IC4.25 (25_GND_OR_NC), IC4.31 (31_GND_OR_NC), J3.3, J3.5, J3.9, R2.2, SW1.B (S), SW1.B' (S1), SW2.B (S), SW2.B' (S1), SW3.B (S), SW3.B' (S1), SW4.B (S), SW4.B' (S1), SW5.B (S), SW5.B' (S1), X2.2; also elsewhere on the board
IN: IC4.29 (29_P0_13); also elsewhere on the board
LED0: IC4.39 (39_P0_27), LED1.C
LED1: IC4.6 (06_P0_26), LED2.C
unnamed: IC4.37 (37_P0_15), X5.2
unnamed: IC4.20 (20_OUT_ANT), IC4.22 (22_OUT_MOD)
unnamed: IC4.11 (11_P0_18), T3.3 (G)
unnamed: IC4.9 (09_P0_16), X5.1
unnamed: R11.2, R20.2, SW1.A, SW1.A' (P1)
unnamed: IC4.30 (30_SWD_CLK), J3.4
unnamed: IC4.28 (28_SWD_IO), J3.2
unnamed: LED1.A, R27.1
unnamed: C23.1, IC4.40 (40_P0_02-AIN0), R2.1, R31.1
unnamed: LED2.A, R28.1
unnamed: T3.1 (D), X2.1
unnamed: IC4.13 (RESET-13_P0_21), J3.10, R20.1
NEXT: IC4.3 (03_P0_12); also elsewhere on the board
PLAY: IC4.35 (35_P0_04-AIN2); also elsewhere on the board
PREV: IC4.32 (32_P0_08); also elsewhere on the board
RESET: IC4.43 (43_P0_11); also elsewhere on the board
STANDBY: IC4.38 (38_P0_03-AIN1)
TASTE0: IC4.42 (AIN7-42_P0_31), R21.1, SW2.A, SW2.A' (P1)
TASTE1: IC4.44 (AIN6-44_P0_30), R22.1, SW3.A, SW3.A' (P1)
TASTE2: IC4.46 (AIN5-46_P0_29), R23.1, SW4.A, SW4.A' (P1)
TASTE3: IC4.48 (AIN4-48_P0_28), R24.1, SW5.A, SW5.A' (P1)
V+: R31.2; also elsewhere on the board
VUB_RESET: IC4.27 (27_P0_17); also elsewhere on the board

Notes on the sheet:
Vibrationsmotor
Tasten und LED-Streifen
SWD-Schnittstelle und Reset
Vibrator
Messung der Batteriespannung
Mikrokontroller mit BLE-Schnittstelle
Schema V0.0
0.0
Mikrokontroller / Benutzerschnittstellen

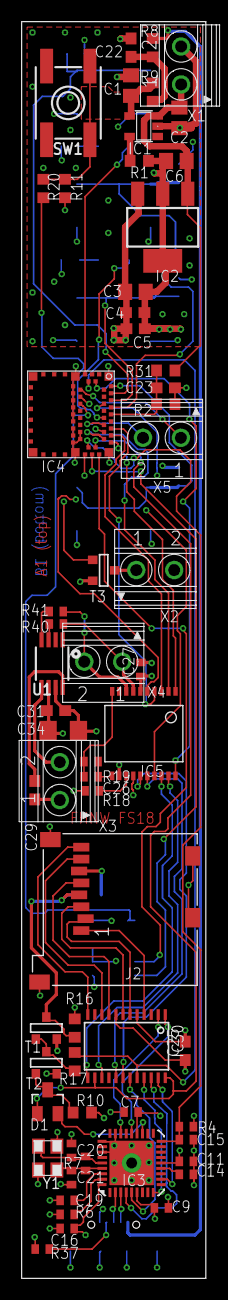
[picture p102: board Board_2.brd from above]

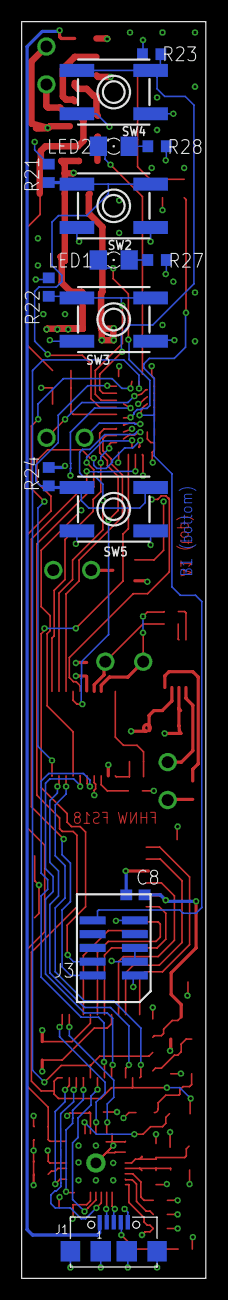
[picture p103: board Board_2.brd from below]

Board: 4 copper layers, 17.0 x 116.0 mm, 75 parts (15 on the bottom side), 73 nets.
