romansonder/pro4e/software/firmware/periphery/ts3a27518e.h

/* ts3a27518e Multiplexer USB/Audio nach SD */

#ifndef TS3A27518E_H
#define TS3A27518E_H

#include <stdbool.h>
#include <stdint.h>

extern void ts3a27518e_init(void);
extern void ts3a27518e_usb_mode(void);
extern void ts3a27518e_audio_mode(void);


#endif /* TS3A27518E_H */
