romansonder/pro4e/software/firmware/periphery/ts4871.h

/* ts4871 Audioamplifier */

#ifndef TS4871_H
#define TS4871_H

#include <stdbool.h>
#include <stdint.h>

extern void ts4871_init(void);
extern void ts4871_ein(void);
extern void ts4871_aus(void);


#endif /* TS4871_H */
