romansonder/pro4e/(commit log)

2018-03-06 Neue Bilder und Einleitung,Organigramm und Budget geschrieben
2018-03-06 Rechtschreibung und ergänzungen
2018-03-20 Test 01
    [Board_1.brd, Board_1.sch]
2018-03-20 audio driver update
2018-03-20 First part of layout done and added design rules.
    [Board_1.brd, Board_1.sch]
2018-03-21 VUB300 gelayoutet
    [Board_1.brd, Board_1.sch]
2018-03-27 lsökj
    [Board_1.brd, Board_1.sch]
2018-03-28 Layout angepasst. Verstärker hinzugefügt
    [Board_1.brd, Board_1.sch, board_Nutzen.brd, board_Nutzen.sch]
2018-04-24 laden und entlade kapitel geschrieben
2018-04-25 Abstract und Wirkungsgrad berechnung
2018-04-26 Plots hinzugefügt und korrekturen
2018-04-26 Einleitung und Tabellenverzeichnis/Abbildungsverzeichnis
2018-04-26 öldsaf
    [Board_1.brd, Mängelliste.xlsx]
2018-04-26 Einleitung und Verzeichnis
2018-05-14 Removed save button from command panel to menubar.
2018-06-01 Änderungen im Softwareteil der Doku
2018-06-05 PMA Vorgabe ueglade.
    Anhand vo dem chamer de PMA Bricht schribe.
2018-06-06 div. Aenderige unter anderem PMA und die eint Zeichnig
    Judihuii
2018-06-07 ölkj
    [Board_1.brd, Board_1.sch]
2018-06-09 Ileitig Überarbeitet
    Anhand de Dubach irne Sache überarbeitet und in Duden prüeft.
2018-06-09 PMA fertiggstellt Ileitig erwitered und Schlusswort gschribe
2018-06-10 Wiederherstellen der Korekturen
